ebf-hue/mini-scos/cad/13-bench-architecture/README.md

# Bench architecture study

Bench-layout study made during the architecture reset. The project subsequently returned to a wrist-mounted layout.

The existing scripts, exports and check reports are preserved in this folder. See the [CAD index](../README.md) for the ordered design history and the current version. Geometry and recorded checks do not establish physical fit or optical performance.
