ebf-hue/mini-scos/cad/05-slim-c-rest/README.md

# Slim C-rest

Intermediate slimmer wrist-rest and support study. Superseded by the SolidCraft mount sequence.

The existing scripts, exports and check reports are preserved in this folder. See the [CAD index](../README.md) for the ordered design history and the current version. Geometry and recorded checks do not establish physical fit or optical performance.
