ebf-hue/mini-scos/cad/08-solidcraft-mount-v3/README.md

# SCOS mount V3 — rounded laser cradle

The laser support now has a broad rounded barrel-shaped root, with radiused ends instead of the pointed triangular gusset. The camera retains V2's open front-loading tray and removable front keeper.

## What to reprint

Reprint **only the rest and the spine/camera tray**. Reuse V1's laser compression band, flat locking key and camera keeper. Their physical geometry is unchanged; the keeper moves to the front in the assembly.

- [One A1 mini PLA replacement plate — 55 mm wide-camera version](bambu/mount_wide_single/mount_wide_single.3mf)
- [One A1 mini PLA replacement plate — 105 mm standard-camera version](bambu/mount_standard_single/mount_standard_single.3mf)
- [Native SolidCraft model](mount.solidcraft)

The plates contain two replacement parts, with the rest on its axial end and the camera support on its planar rear face. They use a 0.4 mm nozzle, 0.2 mm layers, four walls, 30% infill and tree supports, with the complete bundled A1 mini/Generic PLA profiles. The wide-camera plate was also opened and re-sliced in Bambu Studio: approximately **2 h 50 min / 74.5 g**. Select the PLA AMS slot before printing. No print is sent automatically.

## Laser support

The cradle root is 32 mm wide, with a 22 mm diameter rounded cross-section and 2 mm end radii. It joins the arm rest across a broad footprint. The lower laser collar has a 17 mm outside diameter; the upper end retains the existing printed compression-band interface. The nominal 10 mm laser barrel uses a 10.2 mm bore.

This is a geometric reinforcement. Physical fit and strength still require a print trial; the checks below do not establish either.

## Insert the camera from the front

1. Leave the front keeper **out**. Disconnect the ribbon while loading.
2. Hold the camera **lens downward**, ribbon connector toward the rear spine, and slide it into the open front of the tray between the edge guides.
3. Seat it at the two rear stops. The guides are 25.8 mm apart for a nominal 25 mm board; the vertical guide gap remains 1.72 mm for the nominal 1.12 mm PCB.
4. Slide the original keeper crosswise into the **front** guide to prevent the board sliding back out. Do not force a tight keeper; physical printer compensation may still be needed.
5. Feed and connect the ribbon through the rear opening, using the top access window to operate the connector latch. Cable bending/hand access are not represented by the straight-envelope collision check.

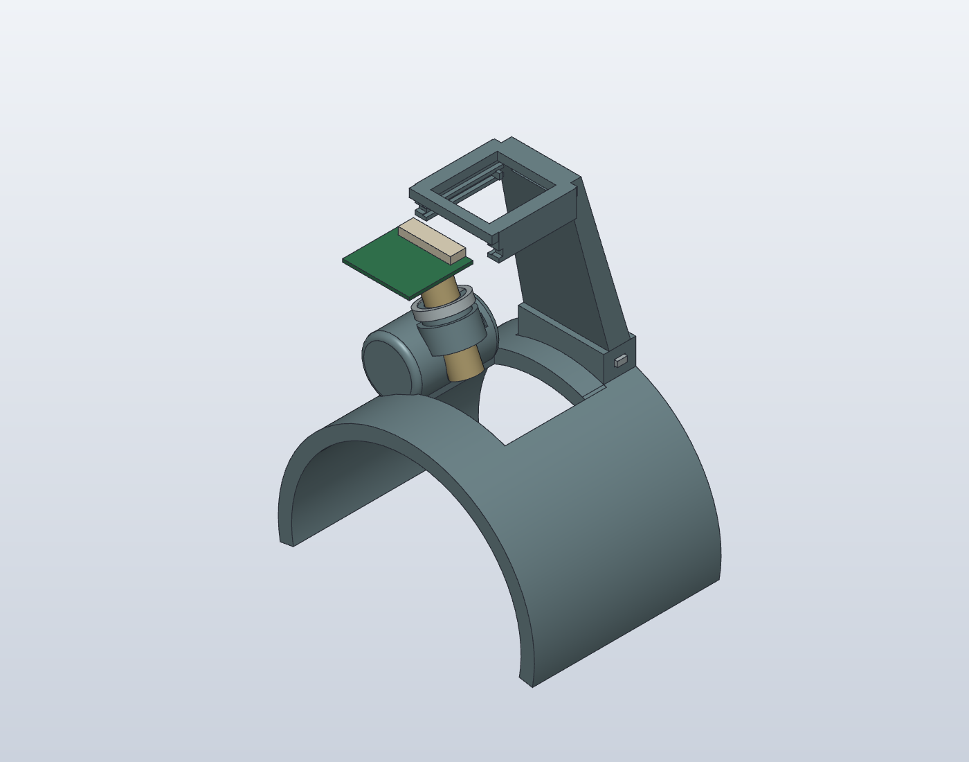
[picture p8: cad/08-solidcraft-mount-v3/camera_loading.png]
Camera outside the open front, keeper removed


## Checks

The native SolidCraft model checks the full **continuous 40 mm front insertion path** for the PCB, lens housing, lens and rear connector, with the keeper and ribbon removed. The check uses exact swept boxes for rectangular components and a conservative swept box around the circular lens. X/Y envelopes are padded by 0.2 mm per side and Z envelopes by 0.1 mm. A clear conservative envelope establishes clearance for the nominal rigid module along that path, rather than only checking sampled positions.

Both 55 and 105 mm configurations pass that insertion check. [Wide-path report](exports/assembly_path_wide.json) / [standard-path report](exports/assembly_path_standard.json). These are geometry checks, not a physical assembly trial.

The assembled model also checks the camera, cable, laser and R41 arm gauge. The only intended intersections are the flat key's two friction contacts and the collar/compression-band press fit. [Static collision report](exports/collision_checks.json). Camera/connector reference envelopes are simplified; they do not include every small electronic component or cable-handling detail.

Closed-mesh and bed-placement checks are in [mesh_validation.json](exports/mesh_validation.json). Bambu projects are sliced before delivery; native model sources and STEP exports are retained beside the print files. The standard variant retains V1's height difference; this revision does not change camera optics or establish SCOS performance.

## Rebuild

```sh
python3 build.py
python3 check_meshes.py
python3 slice_bambu.py
```

SolidCraft and Bambu Studio are required at their installed macOS locations; `SOLIDCRAFT_CLI` can override SolidCraft's path. Rebuilding uses a separate headless SolidCraft MCP document. The native feature history remains in `mount.solidcraft` and its plain JSON counterpart; `build_commands.json` is the replayable native command script. Re-slicing keeps both replacement parts on one A1 mini build plate.
