ebf-hue/mini-scos/cad/10-solidcraft-mount-v5/README.md

# SolidCraft mount V5

Intermediate attachment-junction and blending study between V4 and V6. Not the current mount.

The existing scripts, exports and check reports are preserved in this folder. See the [CAD index](../README.md) for the ordered design history and the current version. Geometry and recorded checks do not establish physical fit or optical performance.
