ebf-hue/mini-scos/cad/11-solidcraft-mount-v6/README.md

# SCOS mount V6 — surface-blended laser attachment

The attachment is a surface blend between trimmed boundaries on the arm rest and laser collar. The replacement surface follows the parent surfaces at both ends, rather than intersecting them with a two-profile solid loft. See [close-up](blend_detail_front.png).

## What to reprint

Reprint **only the rest and the spine/camera tray**. Reuse V1's laser compression band, flat locking key and camera keeper. Their physical geometry is unchanged; the keeper moves to the front in the assembly.

- [One A1 mini PLA replacement plate — 55 mm wide-camera version](bambu/mount_wide_single/mount_wide_single.3mf)
- [One A1 mini PLA replacement plate — 105 mm standard-camera version](bambu/mount_standard_single/mount_standard_single.3mf)
- [Native SolidCraft model](mount.solidcraft)

The plates contain two replacement parts, with the rest on its axial end and the camera support on its planar rear face. They use a 0.4 mm nozzle, 0.2 mm layers, four walls, 30% infill and tree supports, with the complete bundled A1 mini/Generic PLA profiles. The wide-camera plate was opened and re-sliced in Bambu Studio: approximately **2 h 38 min / 68.8 g**. Select the PLA AMS slot before printing. No print is sent automatically.

## Laser support

A 16 × 24 mm projected oval on the rest blends into a 4 × 7 mm projected oval on the back of the collar. SolidCraft's `surface.blend` requests G2 at each end; the open surfaces are sewn in Open CASCADE at 0.01 mm and imported as a closed solid for the bore, compliance slit and key slots. The native authoring document remains in [surface_source/blend_joined.solidcraft](surface_source/blend_joined.solidcraft); the final assembly has the sewn rest as a STEP import.

Independent checks on the finished STEP measured the blend seams at **under 0.45° tangent-plane mismatch** and **under 0.00022 mm projection gap**. [Report](surface_source/blend_seam_validation.json). This establishes finite-tolerance tangent agreement; exact mathematical G2 continuity is not claimed.

The rest STL is tessellated from the valid STEP solid using Open CASCADE. The mesh check preserves tiny triangles with 0.000001 mm coordinate rounding; every mesh edge has two incident triangles and no triangle has zero area. No hole filling or mesh patching is used.

The existing compression-band interface and 10.2 mm laser bore are retained. Physical fit and strength still require a print trial.

## Insert the camera from the front

1. Leave the front keeper **out**. Disconnect the ribbon while loading.
2. Hold the camera **lens downward**, ribbon connector toward the rear spine, and slide it into the open front of the tray between the edge guides.
3. Seat it at the two rear stops. The guides are 25.8 mm apart for a nominal 25 mm board; the vertical guide gap remains 1.72 mm for the nominal 1.12 mm PCB.
4. Slide the original keeper crosswise into the **front** guide to prevent the board sliding back out. Do not force a tight keeper; physical printer compensation may still be needed.
5. Feed and connect the ribbon through the rear opening, using the top access window to operate the connector latch. Cable bending/hand access are not represented by the straight-envelope collision check.

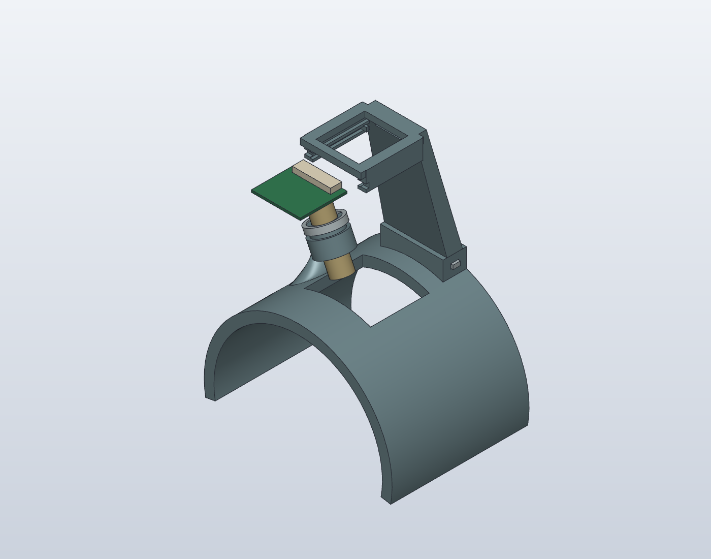
[picture p10: cad/11-solidcraft-mount-v6/camera_loading.png]
Camera outside the open front, keeper removed


## Checks

The native SolidCraft model checks the full **continuous 40 mm front insertion path** for the PCB, lens housing, lens and rear connector, with the keeper and ribbon removed. The check uses exact swept boxes for rectangular components and a conservative swept box around the circular lens. X/Y envelopes are padded by 0.2 mm per side and Z envelopes by 0.1 mm. A clear conservative envelope establishes clearance for the nominal rigid module along that path, rather than only checking sampled positions.

Both 55 and 105 mm configurations pass that insertion check. [Wide-path report](exports/assembly_path_wide.json) / [standard-path report](exports/assembly_path_standard.json). These are geometry checks, not a physical assembly trial.

The assembled model also checks the camera, cable, laser and R41 arm gauge. The only intended intersections are the flat key's two friction contacts and the collar/compression-band press fit. [Static collision report](exports/collision_checks.json). SolidCraft could not intersect the reused band with the imported curved rest; that intended press-fit pair was checked independently in Open CASCADE (15.18 mm³), with a source hash recorded. All remaining pairs and the complete camera insertion sweeps were checked in SolidCraft. Camera/connector reference envelopes are simplified; they do not include every small electronic component or cable-handling detail.

Closed-mesh and bed-placement checks are in [mesh_validation.json](exports/mesh_validation.json). Bambu projects are sliced before delivery; native model sources and STEP exports are retained beside the print files. The standard variant retains V1's height difference; this revision does not change camera optics or establish SCOS performance.

## Rebuild

```sh
# Reuse the checked surface source and rebuild camera variants/assembly:
python3 build.py
python3 check_meshes.py
python3 slice_bambu.py
```

SolidCraft and Bambu Studio are required at their installed macOS locations; `SOLIDCRAFT_CLI` can override SolidCraft's path. Rebuilding uses a separate headless SolidCraft MCP document. The native feature history remains in `mount.solidcraft` and its plain JSON counterpart; `build_commands.json` is the replayable native command script. Re-slicing keeps both replacement parts on one A1 mini build plate.

To rebuild the surface geometry itself, run `python3 build_surface.py` before the assembly build. This also uses uv/CadQuery for sewing and validation. The rest surface source and sewing are retained separately from the final imported assembly.
