ebf-hue/mini-scos/cad/12-solidcraft-mount-v7/README.md

# SolidCraft mount V7

Camera attachment surface blends and a wider laser attachment, retaining the front-loading camera layout. Superseded by the later architecture studies.

The existing scripts, exports and check reports are preserved in this folder. See the [CAD index](../README.md) for the ordered design history and the current version. Geometry and recorded checks do not establish physical fit or optical performance.
