ebf-hue/mini-scos/docs/TEAM.md

# Team #

## Members ##
- Elena Berrios eberrios@bu.edu
- Sean O’Connor ssoc@bu.edu

## Decisions ##
Decisions will be collaborative. In the rare case that an agreement can't be made, the designated sprint lead will call it.

## Roles ##
Designated sprint lead will alternate. The lead for sprint 1 is Elena. All decisions, including those that are technical or related to project management, are collaboratively discussed between members as stated above.

## Communication ##
The team will meet biweekly during EC601 class time. Additional in-person or remote meetings are flexible and will be scheduled as needed. Communication outside of meetings will primarily be over text. Replies can be expected within 24 hours, unless a member communicates that they'll be unavailable. Members will also communicate if they're unable to attend a scheduled meeting.
