ebf-hue/mini-scos/cad/01-bench-fixture/preview.png

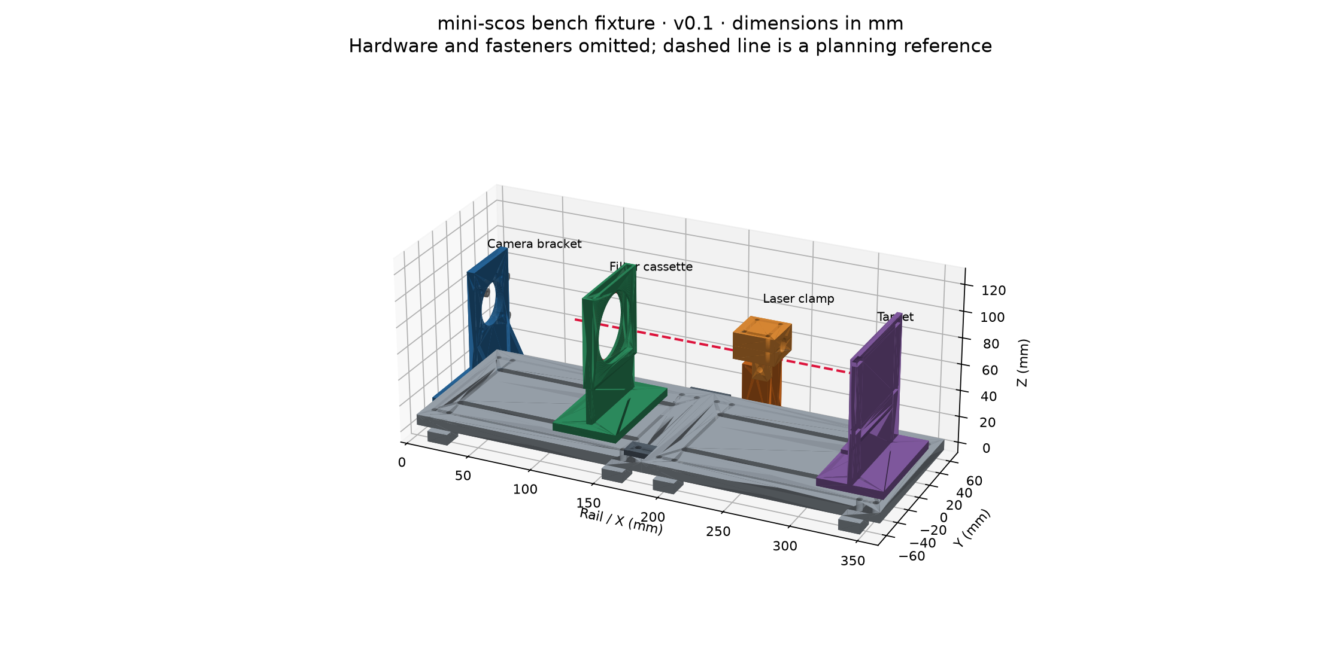
cad/01-bench-fixture/preview.png
