ebf-hue/mini-scos/cad/02-arm-cuff-concept/arm_cuff_graphic.png

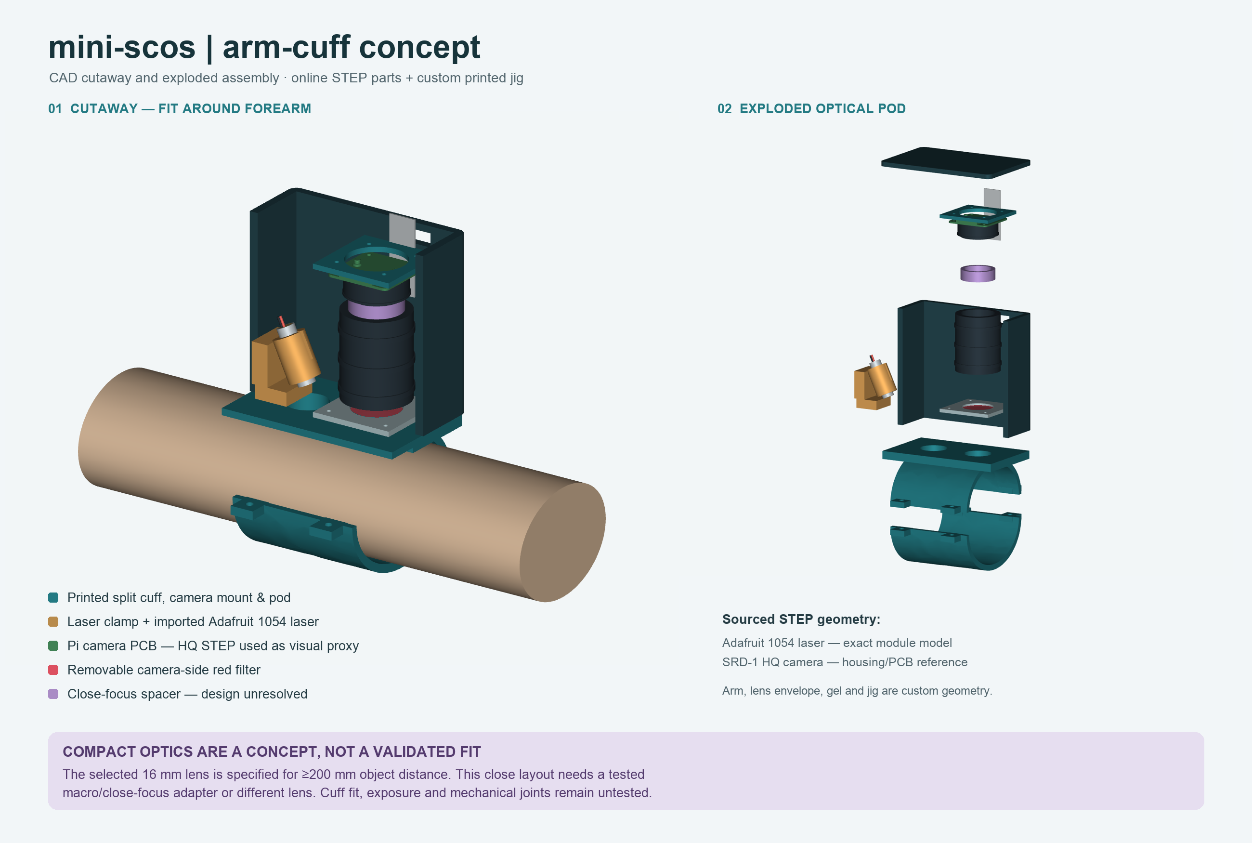
cad/02-arm-cuff-concept/arm_cuff_graphic.png
