ebf-hue/mini-scos/cad/02-arm-cuff-concept/arm_cuff_graphic_v02.png

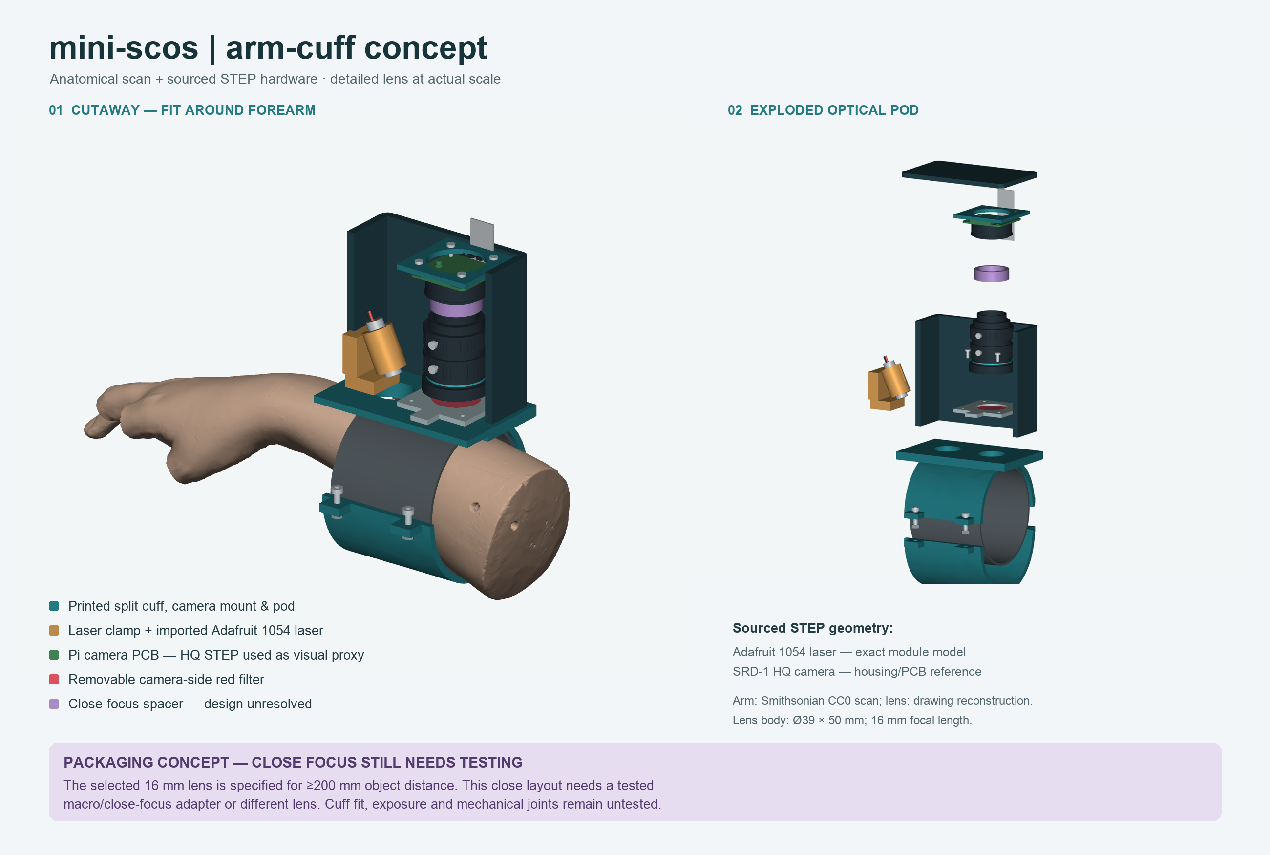
cad/02-arm-cuff-concept/arm_cuff_graphic_v02.png
