ebf-hue/mini-scos/cad/02-arm-cuff-concept/cutaway.png

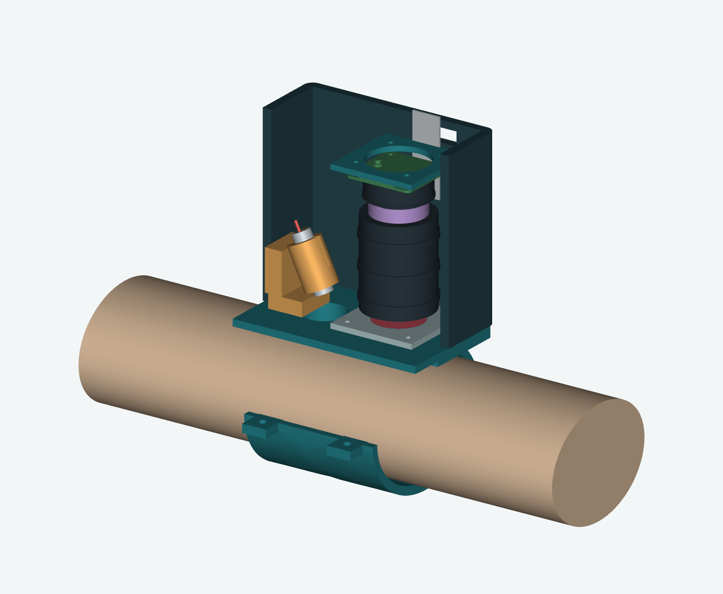
cad/02-arm-cuff-concept/cutaway.png
