ebf-hue/mini-scos/cad/02-arm-cuff-concept/cutaway_v02.png

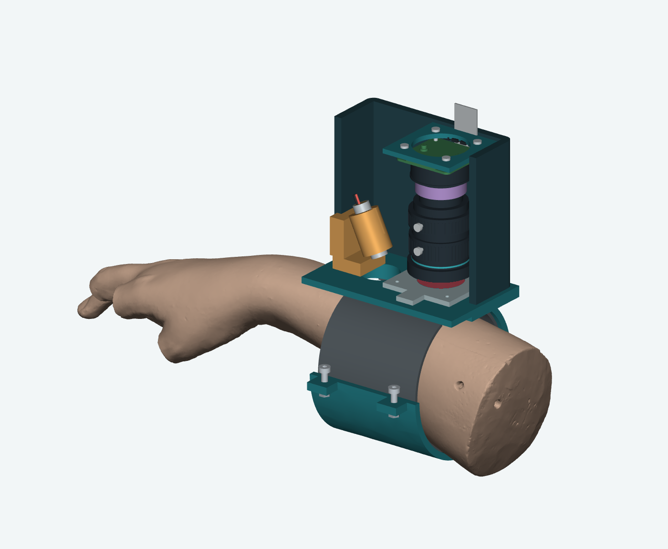
cad/02-arm-cuff-concept/cutaway_v02.png
