ebf-hue/mini-scos/cad/02-arm-cuff-concept/exploded.png

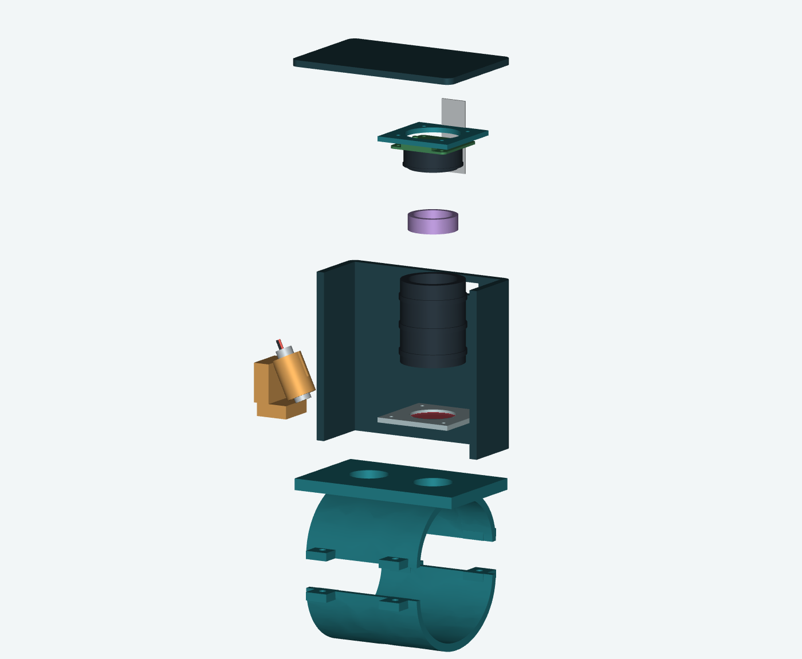
cad/02-arm-cuff-concept/exploded.png
