ebf-hue/mini-scos/cad/02-arm-cuff-concept/open_arm_saddle_graphic.png

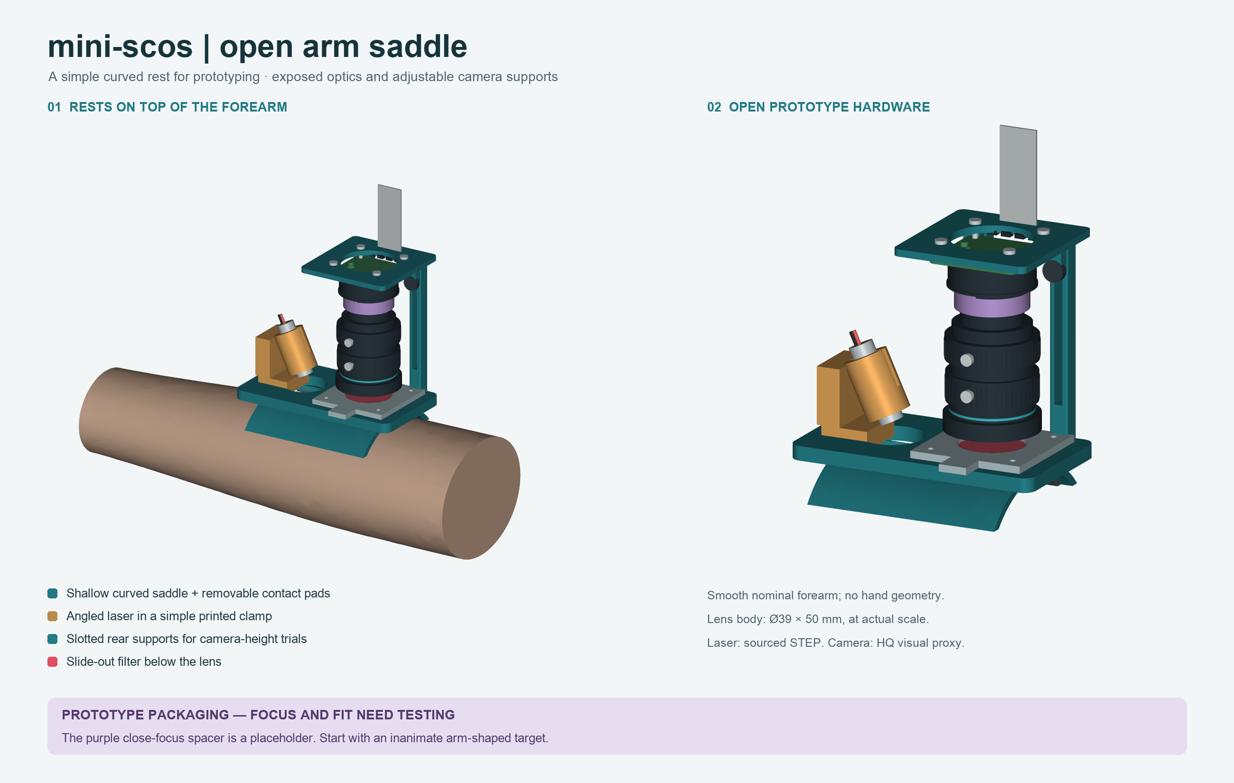
cad/02-arm-cuff-concept/open_arm_saddle_graphic.png
