ebf-hue/mini-scos/cad/02-arm-cuff-concept/open_saddle_detail.png

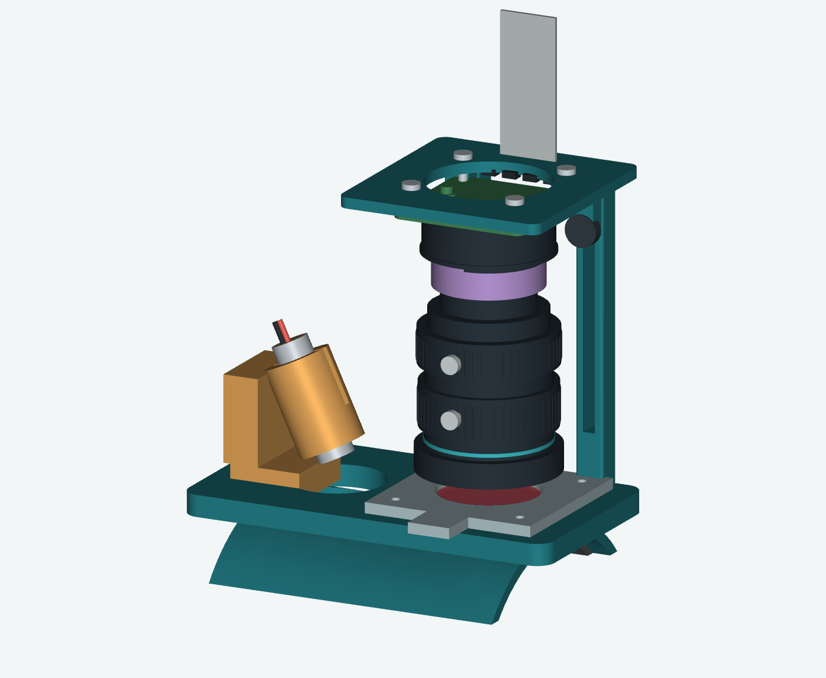
cad/02-arm-cuff-concept/open_saddle_detail.png
