ebf-hue/mini-scos/cad/02-arm-cuff-concept/sources/forearm_scan/life-cast-of-left-forearm-and-hand-150k-4096-occlusion.jpg

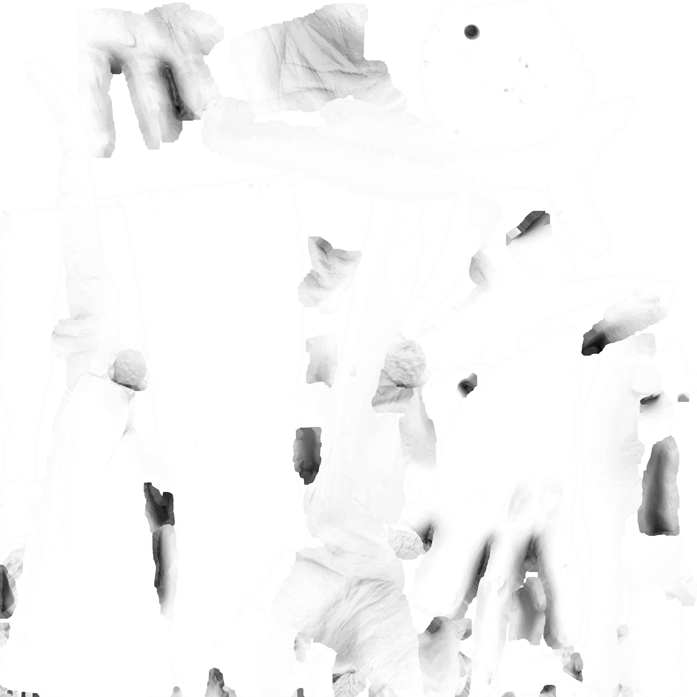
cad/02-arm-cuff-concept/sources/forearm_scan/life-cast-of-left-forearm-and-hand-150k-4096-occlusion.jpg
