ebf-hue/mini-scos/cad/03-c-rest-module3/exploded.png

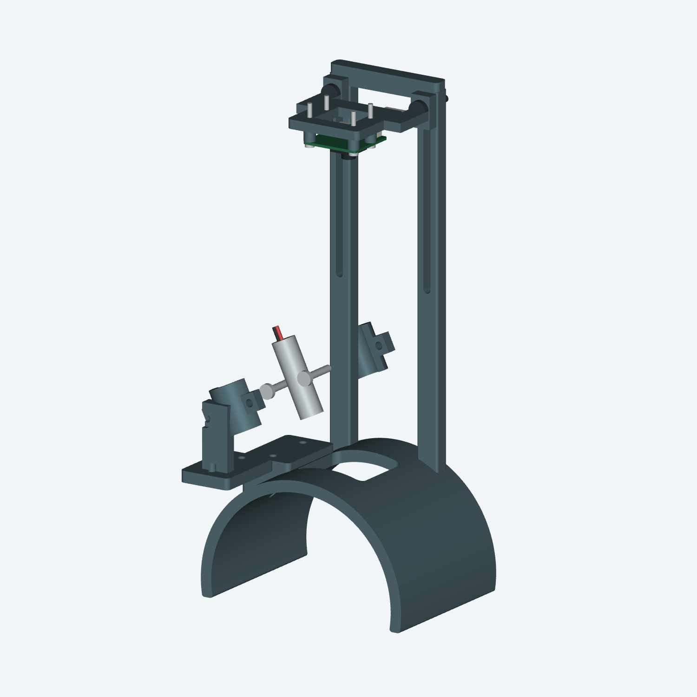
cad/03-c-rest-module3/exploded.png
