ebf-hue/mini-scos/cad/03-c-rest-module3/front.png

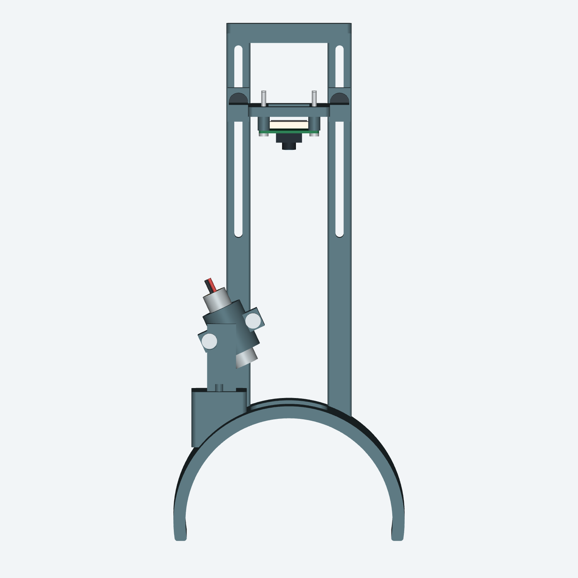
cad/03-c-rest-module3/front.png
