ebf-hue/mini-scos/cad/03-c-rest-module3/on_arm.png

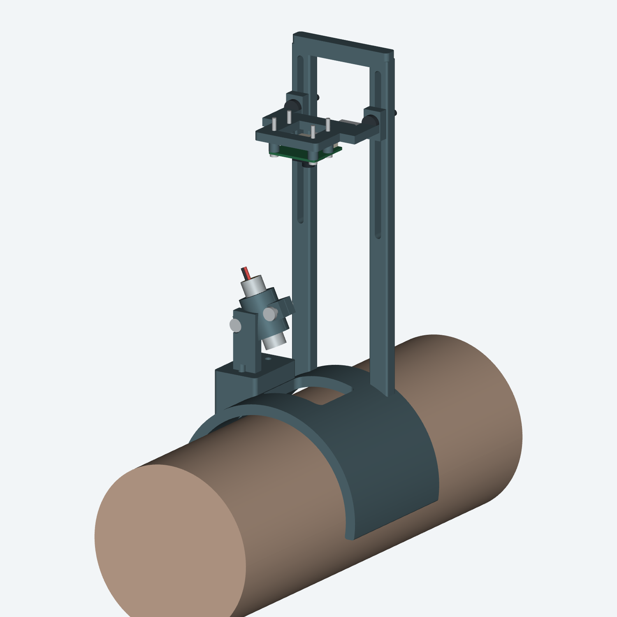
cad/03-c-rest-module3/on_arm.png
