ebf-hue/mini-scos/cad/11-solidcraft-mount-v6/blend_detail_back.png

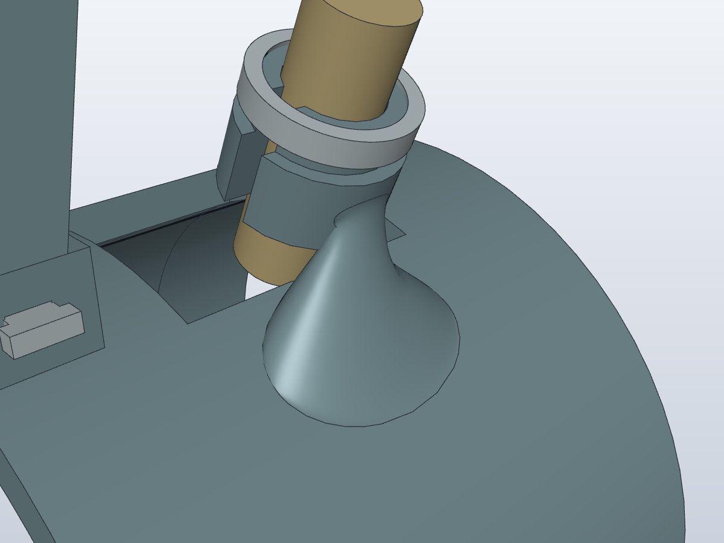
cad/11-solidcraft-mount-v6/blend_detail_back.png
