ebf-hue/mini-scos/cad/11-solidcraft-mount-v6/blend_detail_front.png

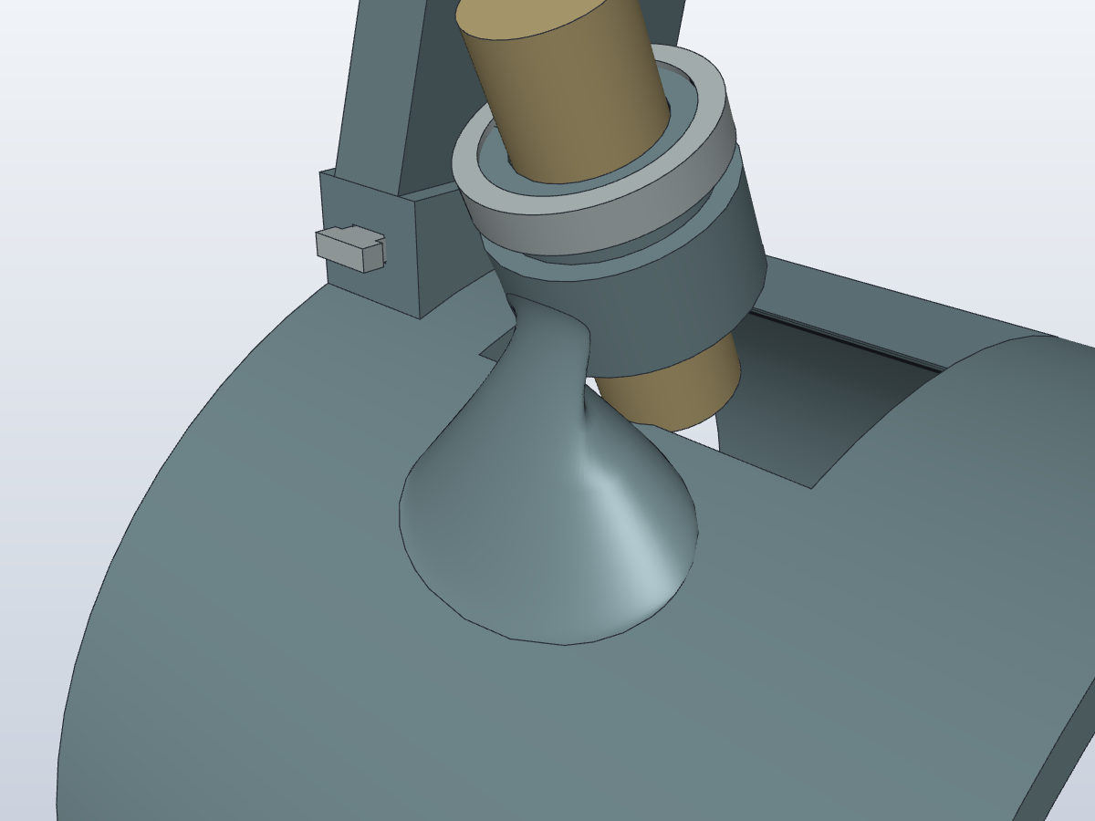
cad/11-solidcraft-mount-v6/blend_detail_front.png
