ebf-hue/mini-scos/cad/12-solidcraft-mount-v7/camera_source/wide/camera_blended.png

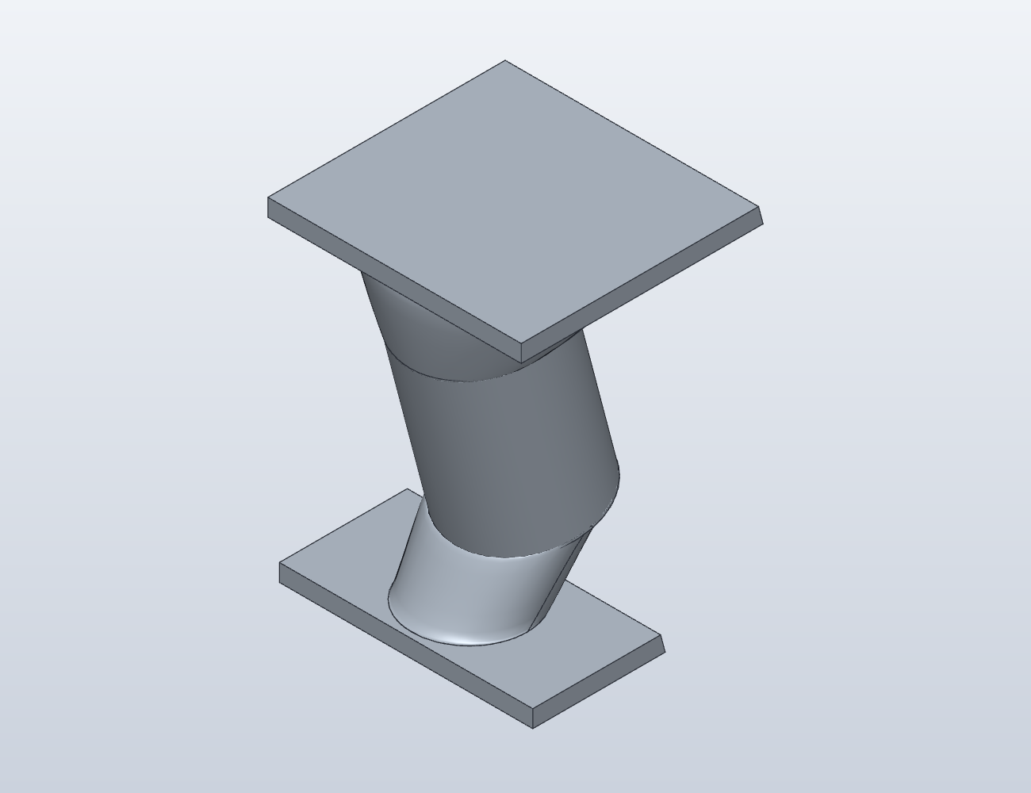
cad/12-solidcraft-mount-v7/camera_source/wide/camera_blended.png
