ebf-hue/mini-scos/cad/13-bench-architecture/bench-concept.png

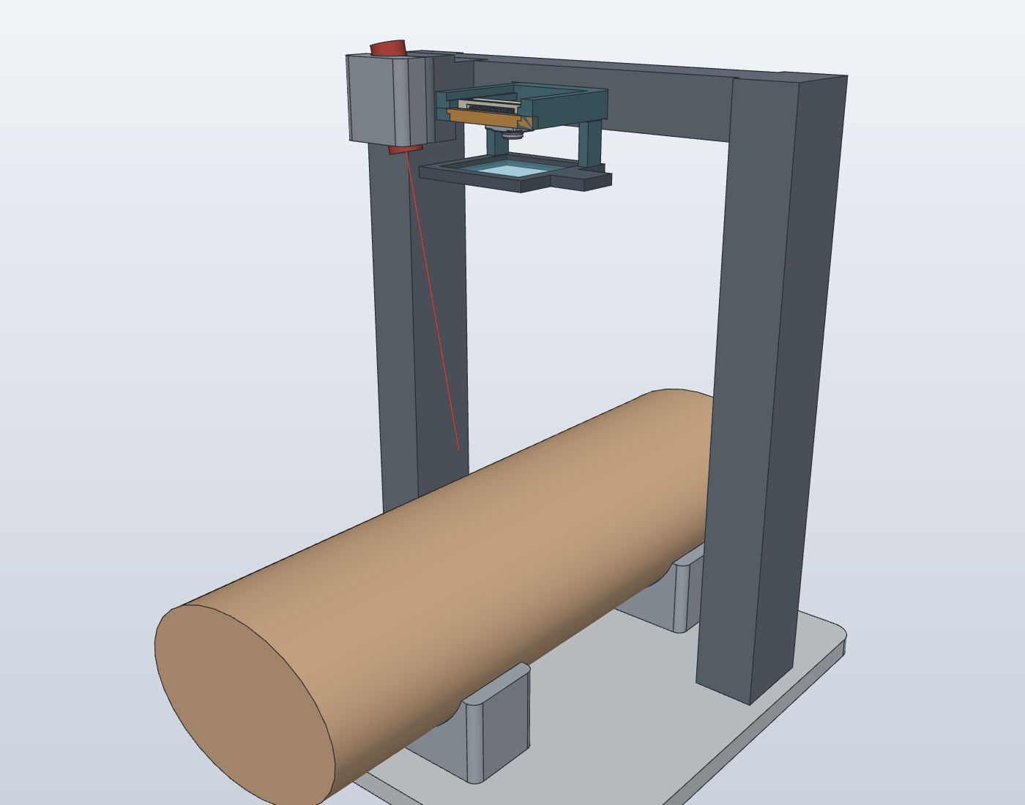
cad/13-bench-architecture/bench-concept.png
