ebf-hue/mini-scos/cad/13-bench-architecture/camera-detail.png

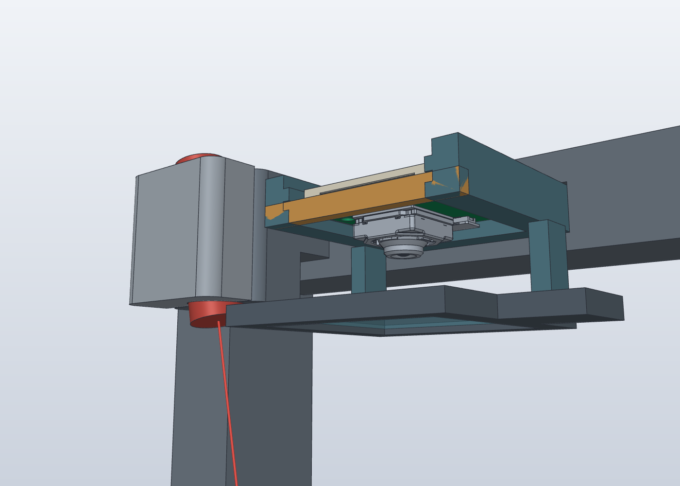
cad/13-bench-architecture/camera-detail.png
