ebf-hue/mini-scos/cad/14-wrist-architecture/insertion/camera-insertion.png

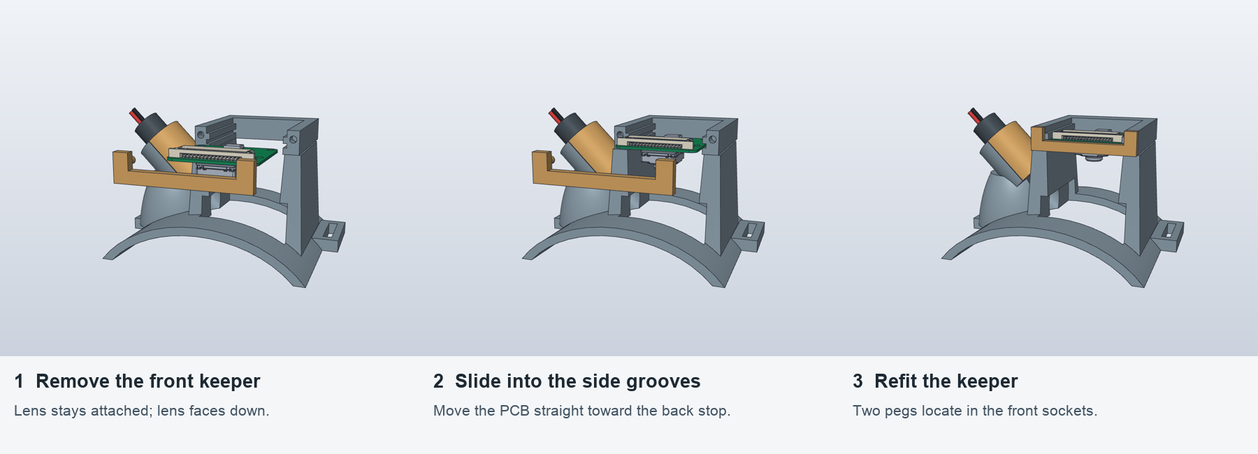
cad/14-wrist-architecture/insertion/camera-insertion.png
