ebf-hue/mini-scos/cad/14-wrist-architecture/wrist-closeup.png

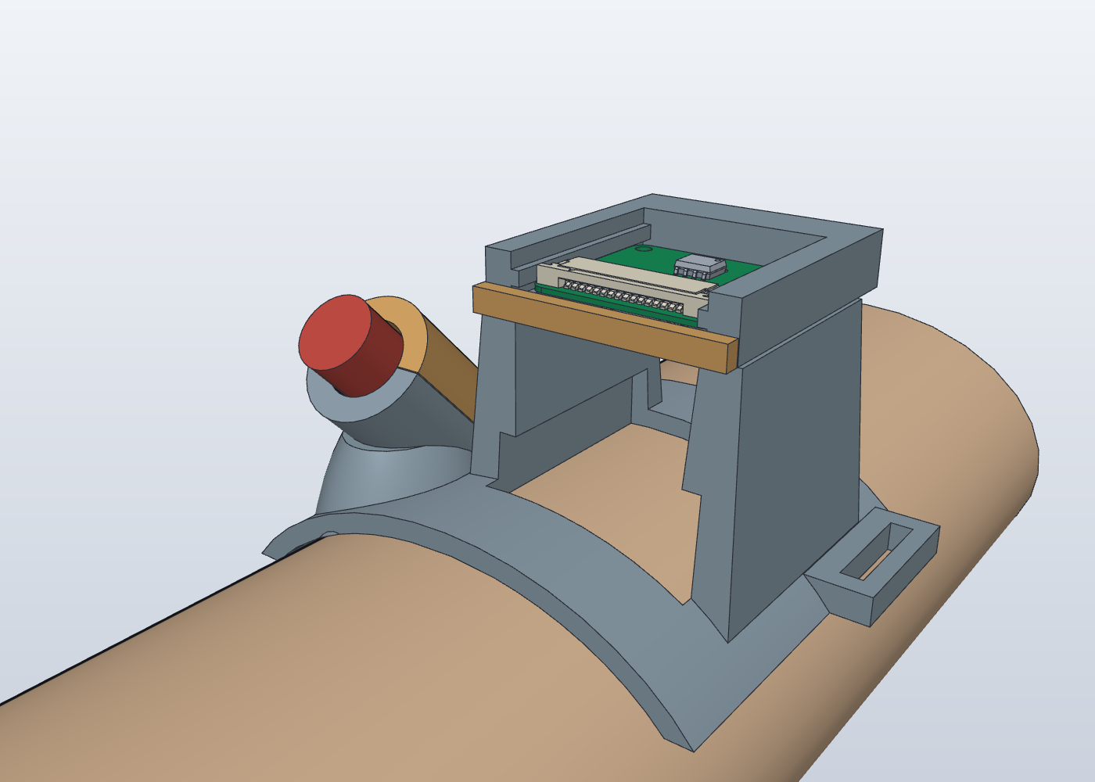
cad/14-wrist-architecture/wrist-closeup.png
