ebf-hue/mini-scos/cad/14-wrist-architecture/wrist-concept.png

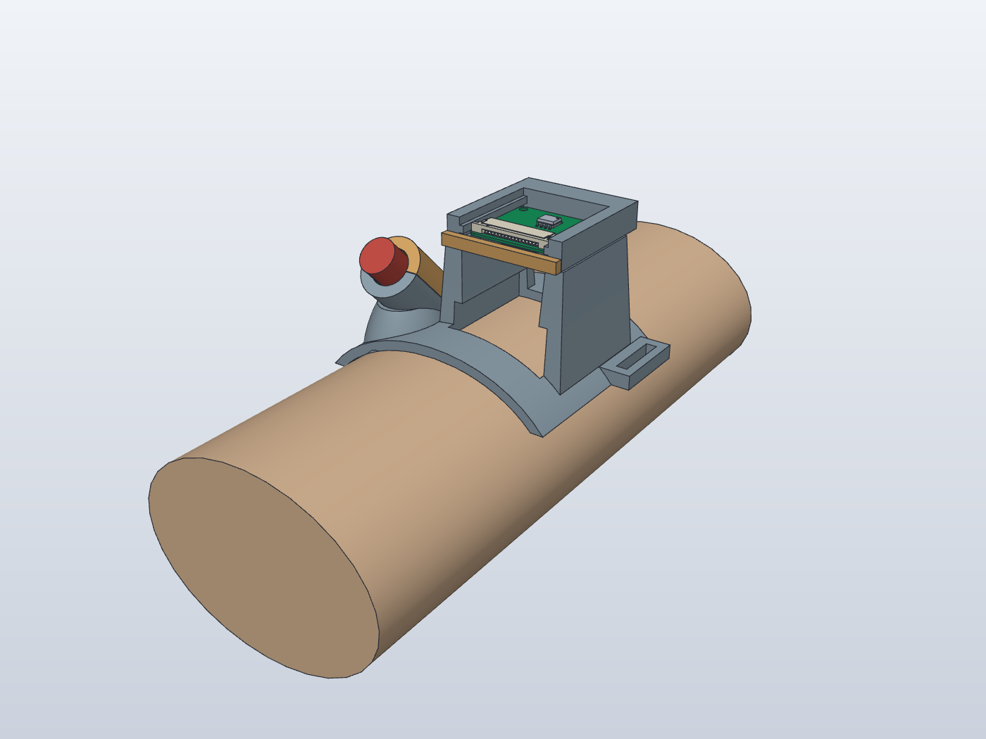
cad/14-wrist-architecture/wrist-concept.png
