ebf-hue/mini-scos/cad/14-wrist-architecture/wrist-inward-ray.png

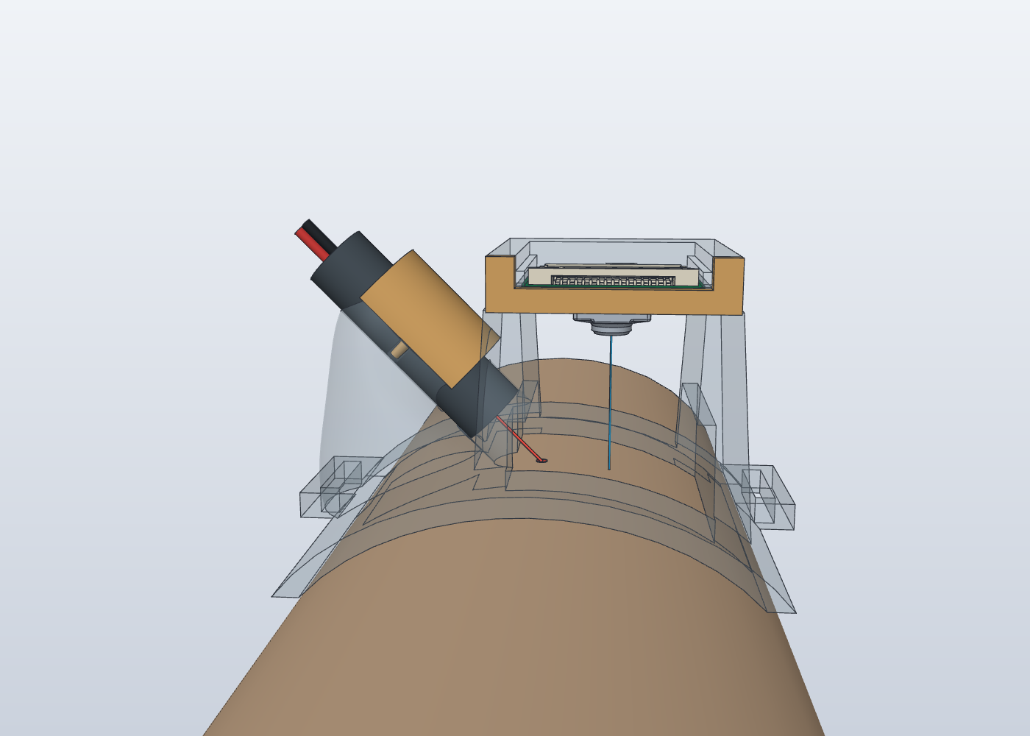
cad/14-wrist-architecture/wrist-inward-ray.png
