ebf-hue/mini-scos/cad/15-tower-mechanical/front.png

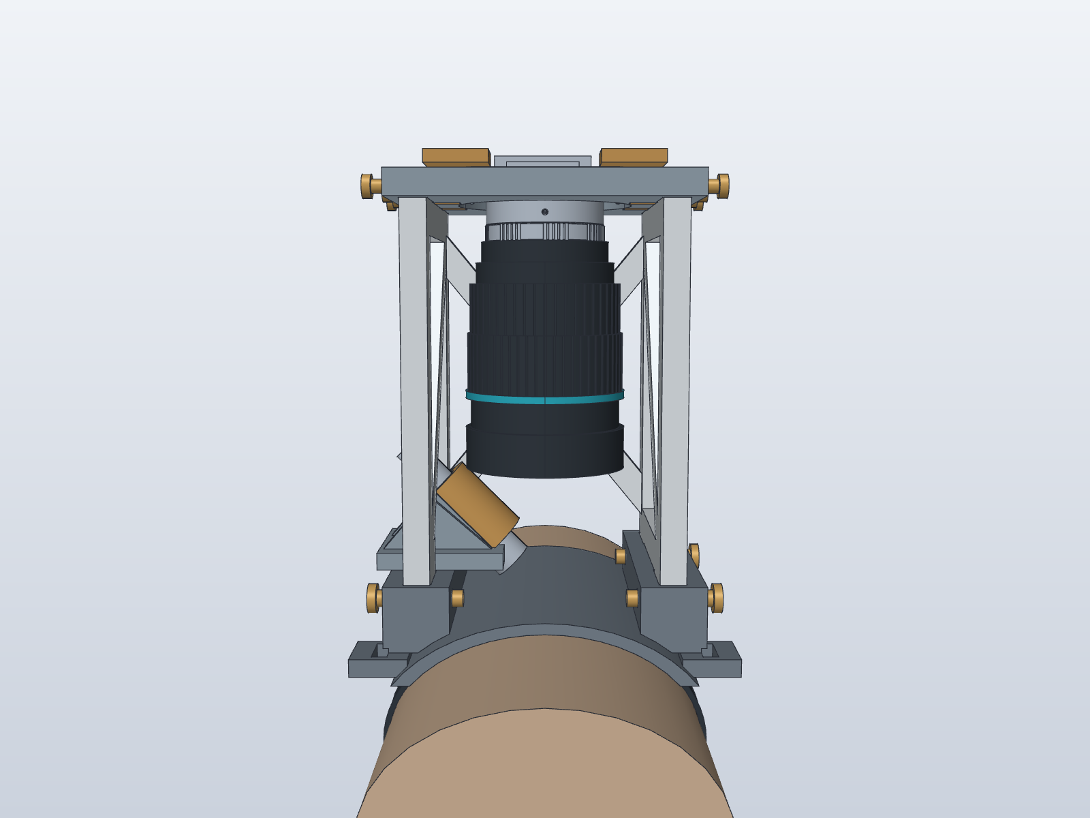
cad/15-tower-mechanical/front.png
