ebf-hue/mini-scos/cad/15-tower-mechanical/side.png

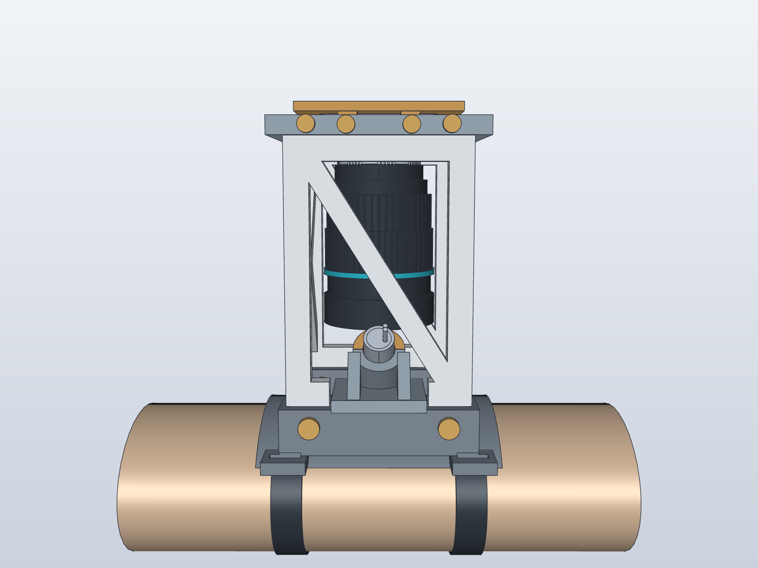
cad/15-tower-mechanical/side.png
