ebf-hue/mini-scos/cad/16-tower-dovetail/bambu/sliced-plate.jpg

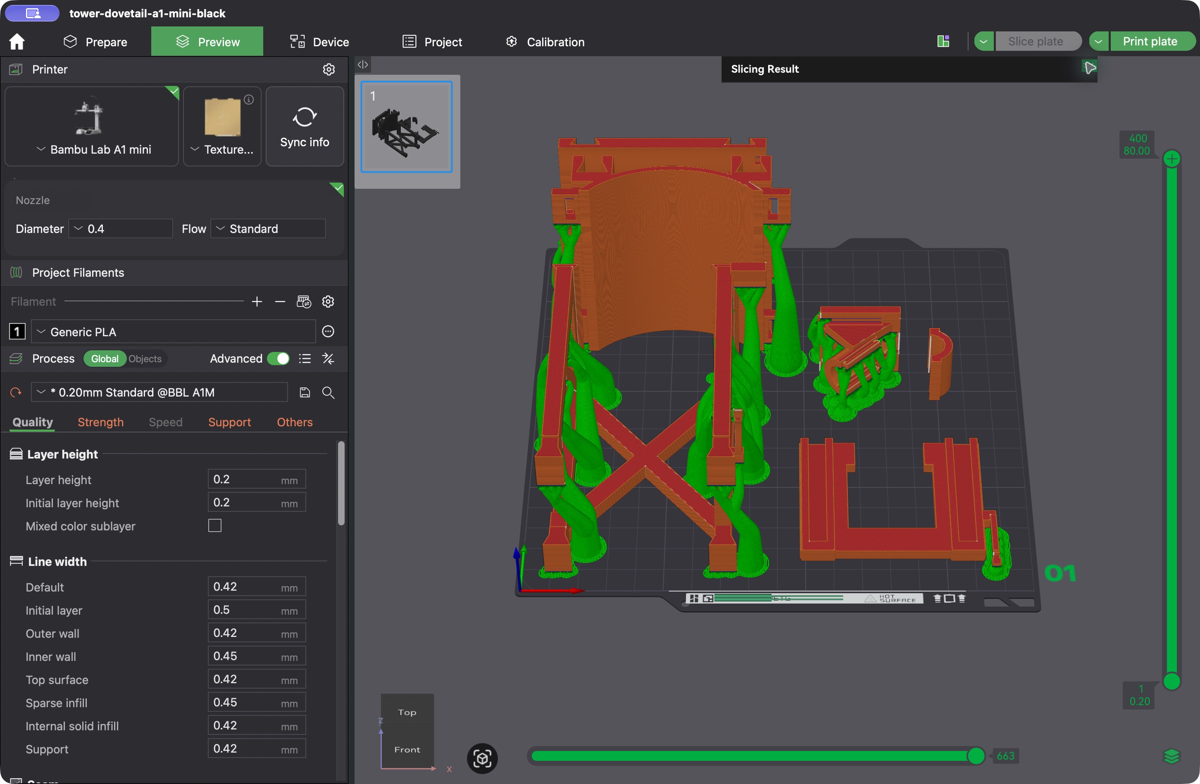
cad/16-tower-dovetail/bambu/sliced-plate.jpg
