ebf-hue/mini-scos/cad/16-tower-dovetail/screenshots/04-camera-retainer.png

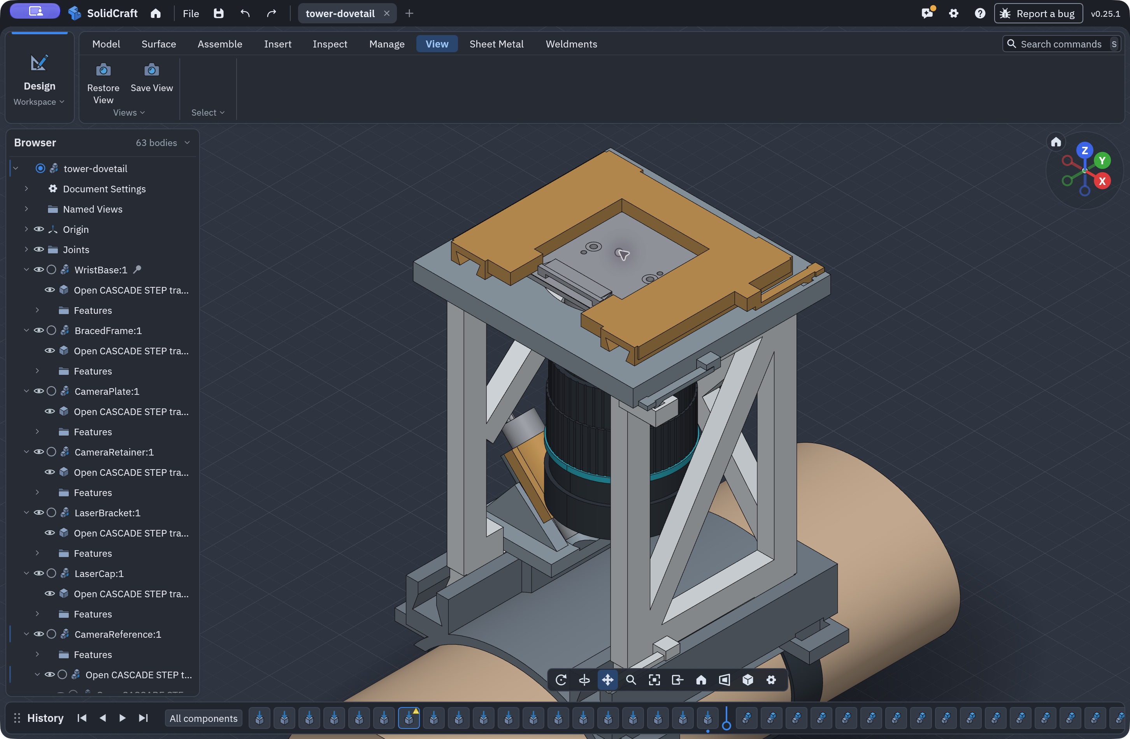
cad/16-tower-dovetail/screenshots/04-camera-retainer.png
