ebf-hue/mini-scos/cad/17-tower-open-optics/camera-clip-bottom.png

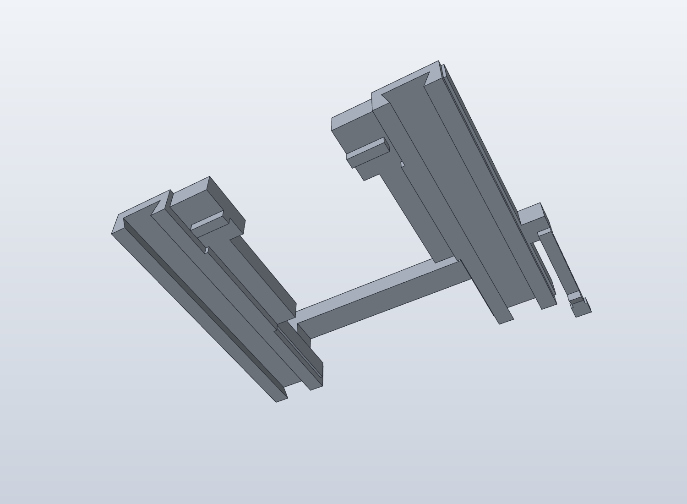
cad/17-tower-open-optics/camera-clip-bottom.png
