ebf-hue/mini-scos/cad/17-tower-open-optics/camera-retention-section.png

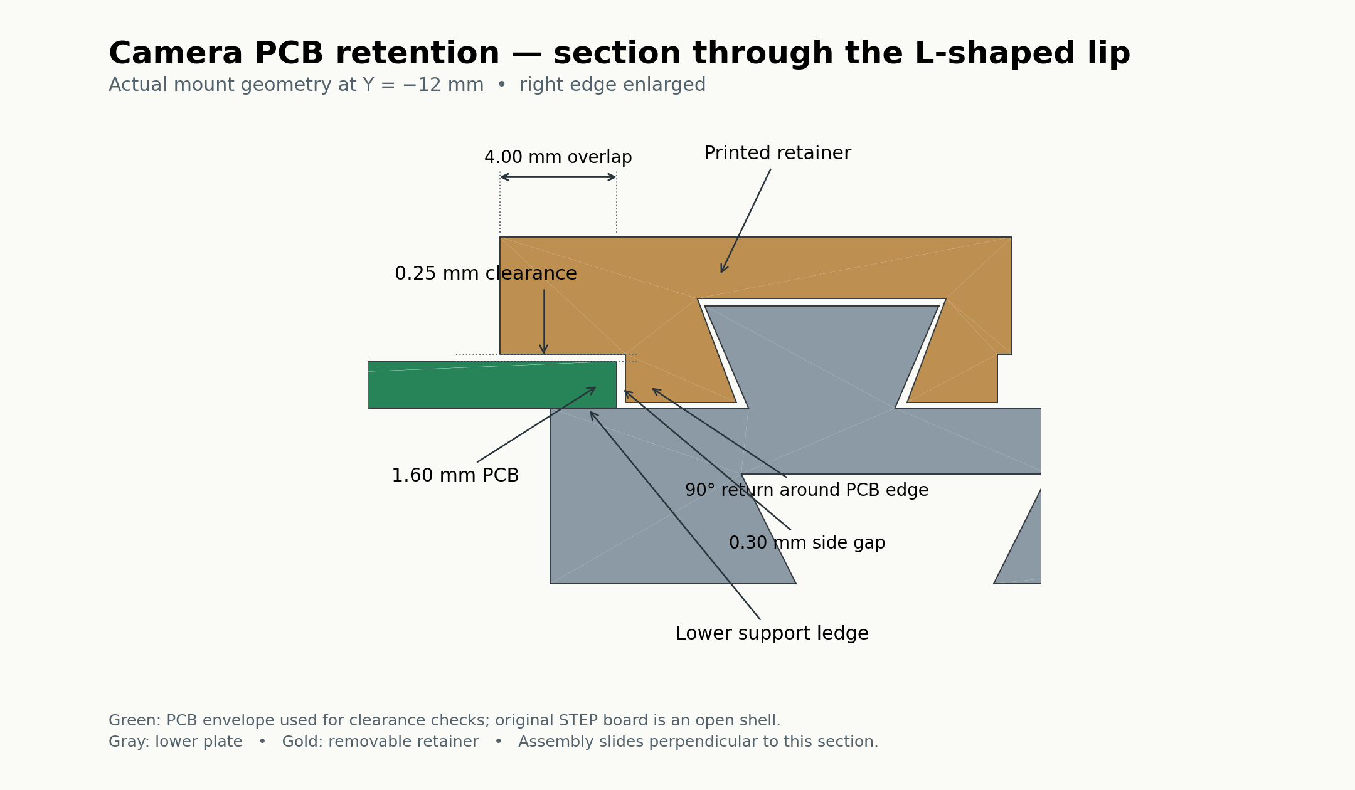
cad/17-tower-open-optics/camera-retention-section.png
