ebf-hue/mini-scos/cad/17-tower-open-optics/header-clearance-detail.png

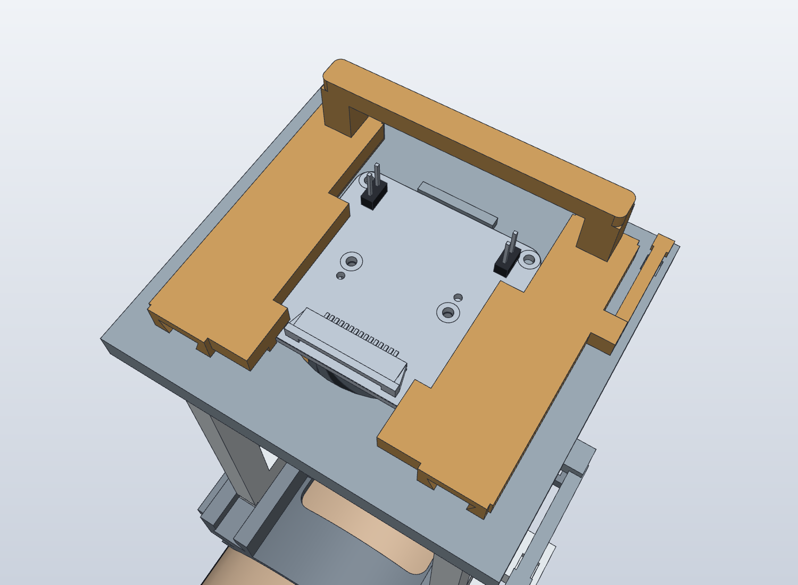
cad/17-tower-open-optics/header-clearance-detail.png
