ebf-hue/mini-scos/cad/17-tower-open-optics/open-base.png

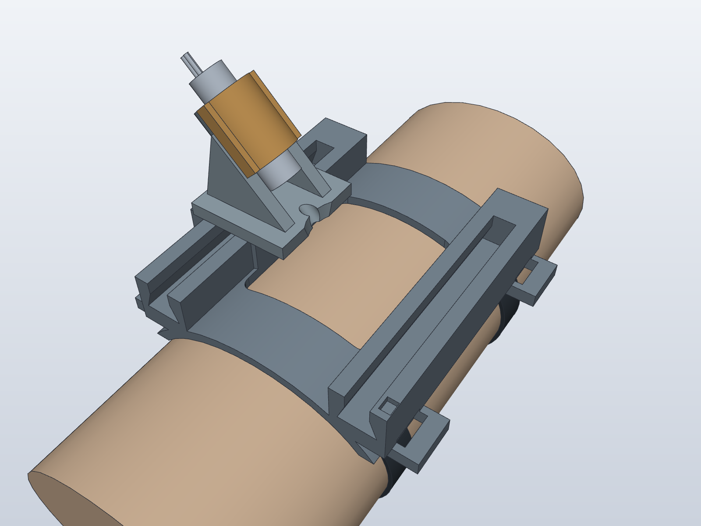
cad/17-tower-open-optics/open-base.png
