ebf-hue/mini-scos/cad/17-tower-open-optics/optical-paths-side.png

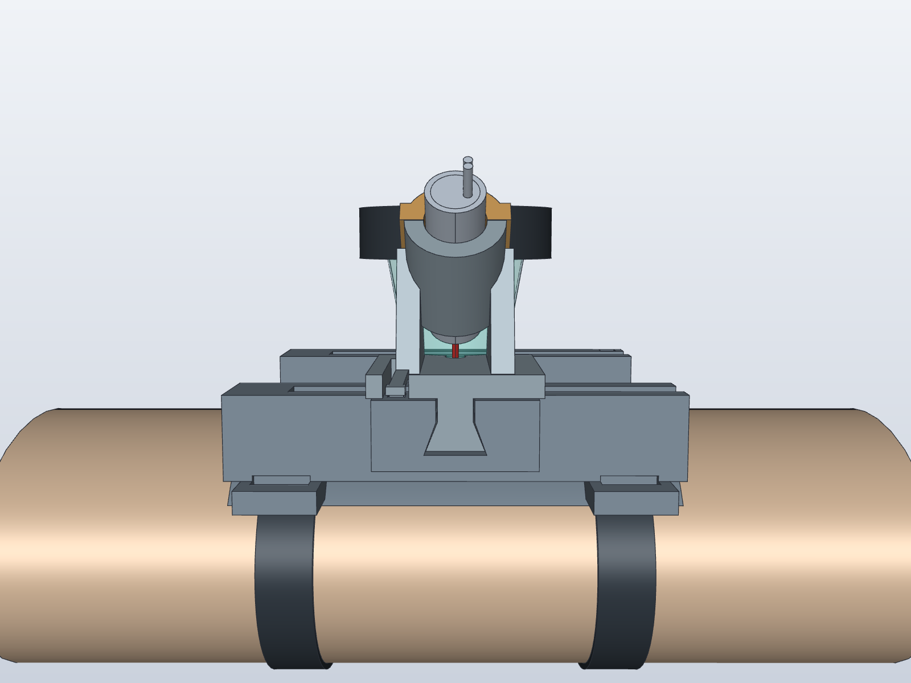
cad/17-tower-open-optics/optical-paths-side.png
