ebf-hue/mini-scos/cad/17-tower-open-optics/optical-paths.png

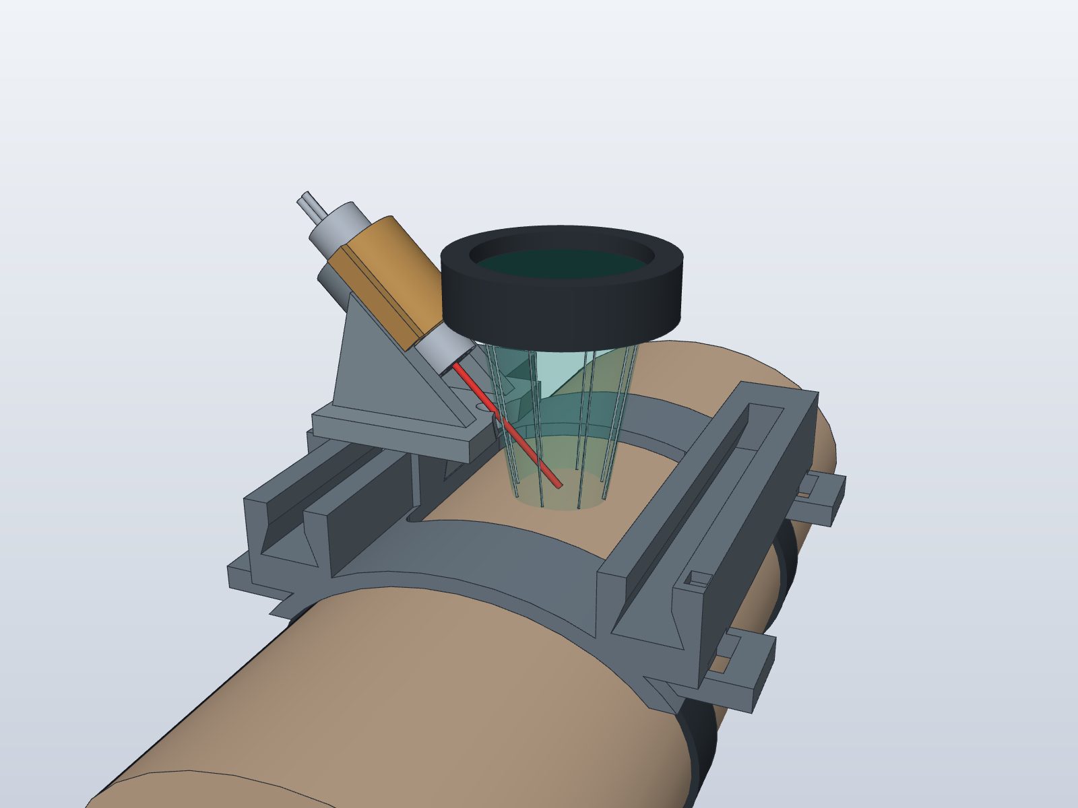
cad/17-tower-open-optics/optical-paths.png
