ebf-hue/mini-scos/cad/17-tower-open-optics/pcb-end-stops-section.png

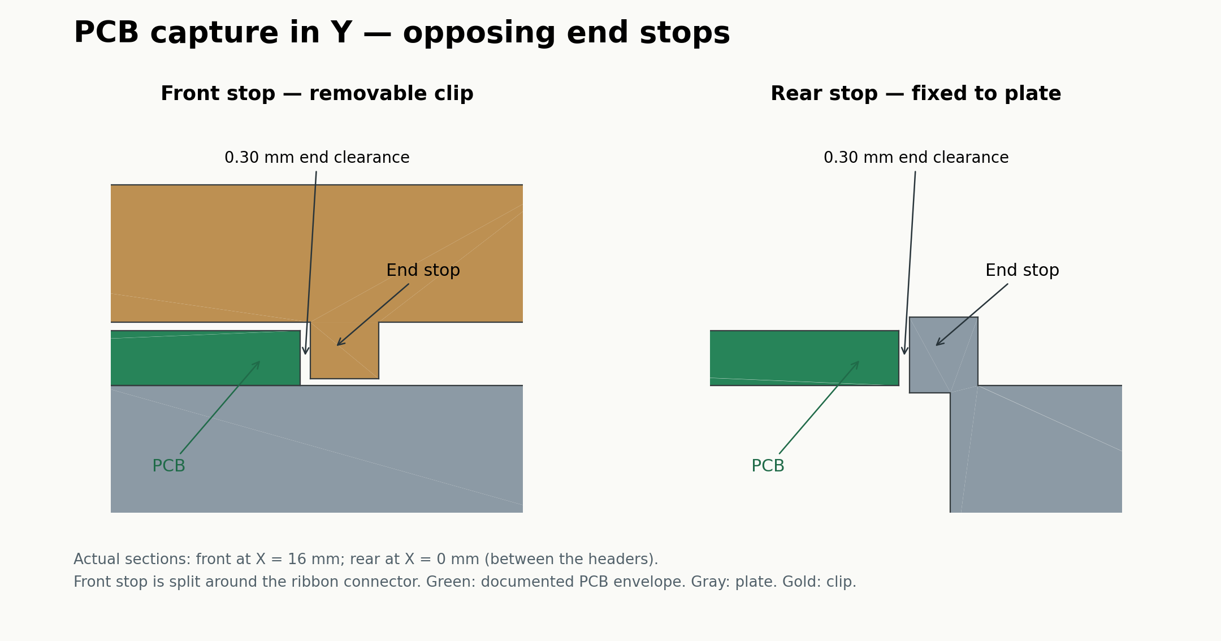
cad/17-tower-open-optics/pcb-end-stops-section.png
