ebf-hue/mini-scos/cad/18-tower-recessed-clips/camera-drop-in.png

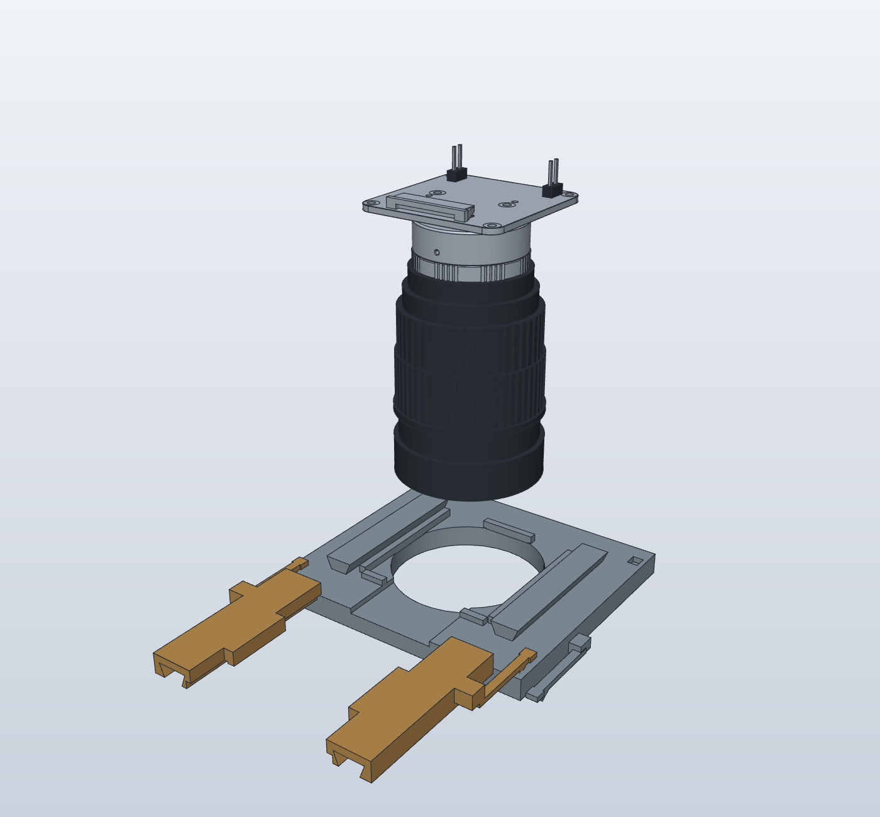
cad/18-tower-recessed-clips/camera-drop-in.png
