ebf-hue/mini-scos/cad/18-tower-recessed-clips/camera-seat-empty.png

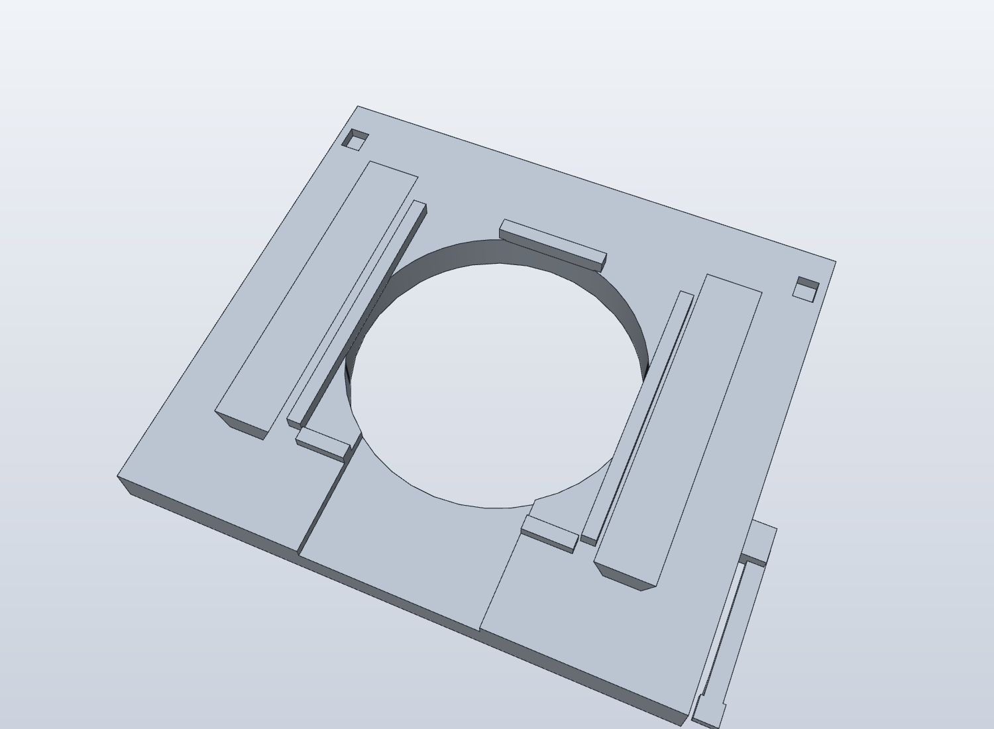
cad/18-tower-recessed-clips/camera-seat-empty.png
