ebf-hue/mini-scos/cad/19-camera-tray/camera-seat-empty.png

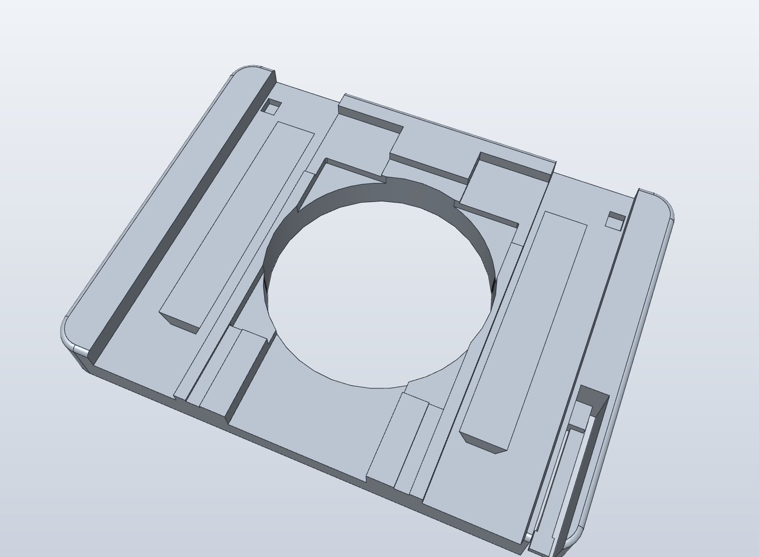
cad/19-camera-tray/camera-seat-empty.png
