ebf-hue/mini-scos/cad/experiments/halloween-sculpt/concept-reference.png

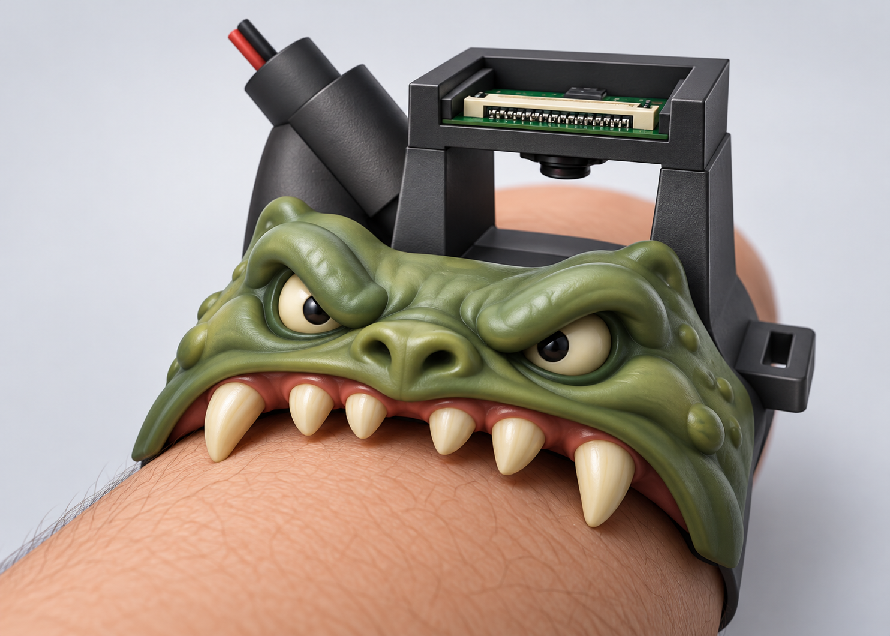
cad/experiments/halloween-sculpt/concept-reference.png
