ebf-hue/mini-scos/cad/tower-dovetail/dovetail-detail.png

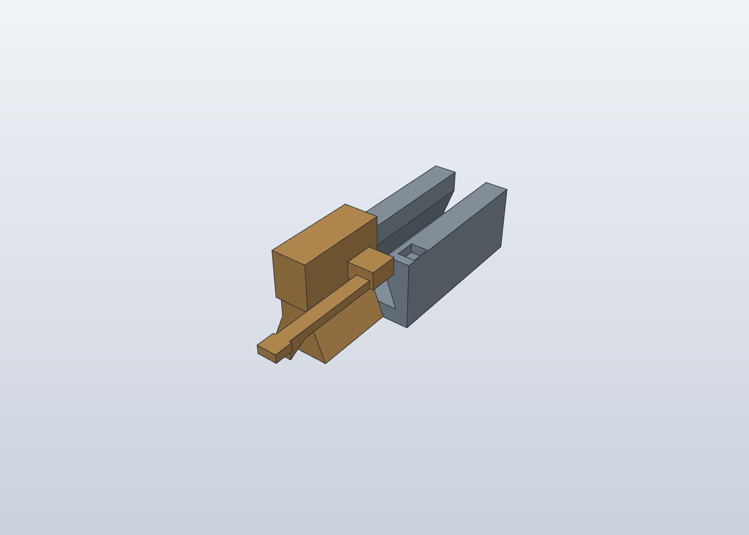
cad/tower-dovetail/dovetail-detail.png
