ebf-hue/mini-scos/cad/wrist-architecture/wrist-inward-closeup.png

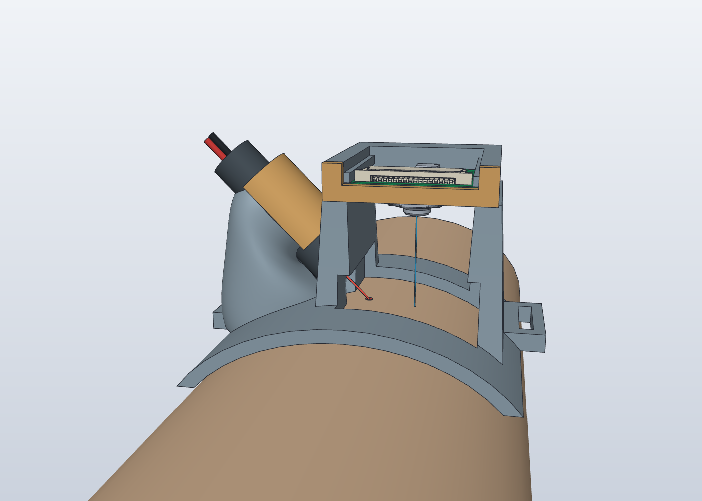
cad/wrist-architecture/wrist-inward-closeup.png
