ebf-hue/mini-scos/docs/Laser Speckle Imaging Workflow.png

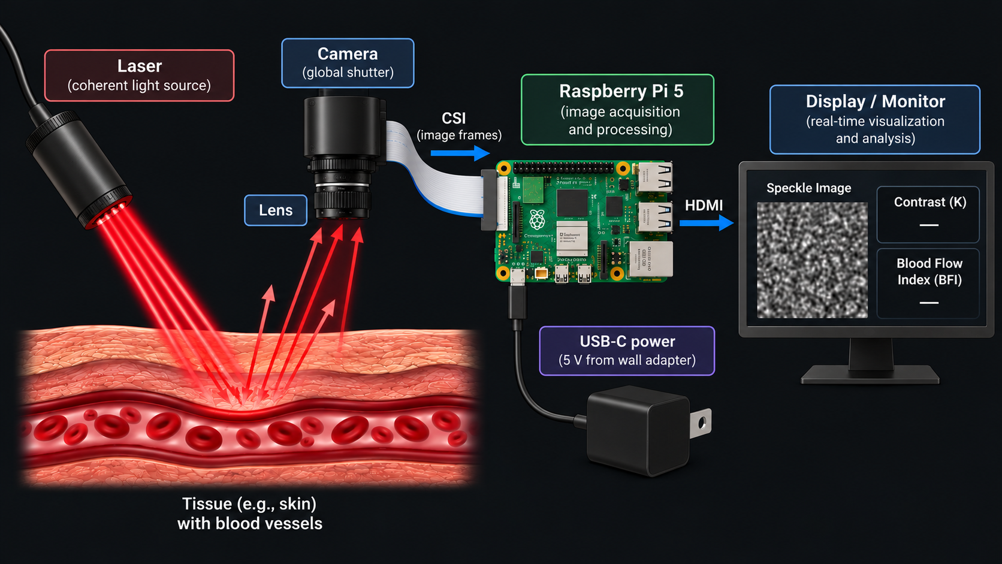
docs/Laser Speckle Imaging Workflow.png
