ebf-hue/mini-scos/software/examples/images/high.png

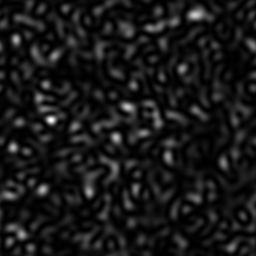
software/examples/images/high.png
