ebf-hue/mini-scos/software/examples/images/low.png

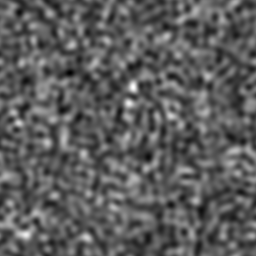
software/examples/images/low.png
