ebf-hue/mini-scos/cad/04-c-rest-printable/print_parts.png

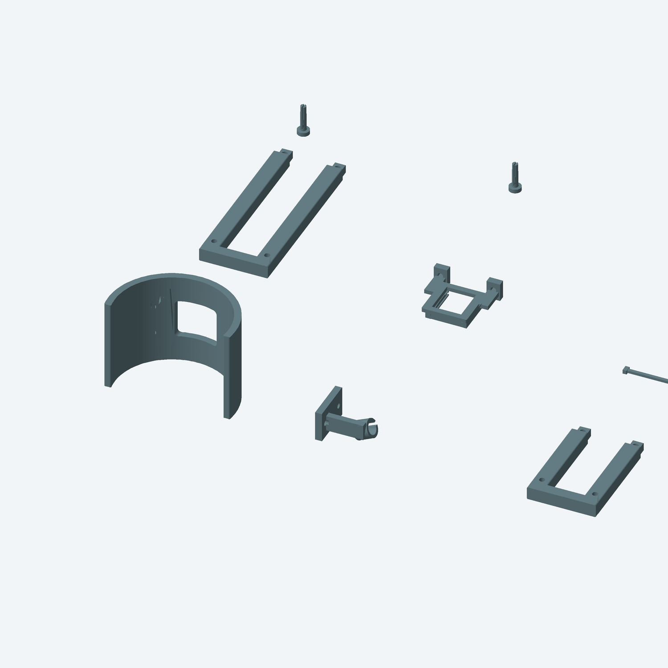
cad/04-c-rest-printable/print_parts.png
