ebf-hue/mini-scos/cad/12-solidcraft-mount-v7/standard_exports/assembly_standard.step

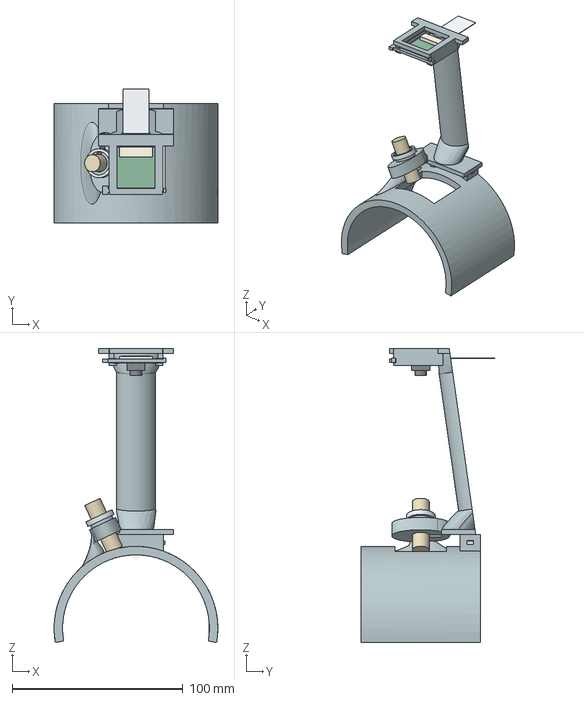
[picture p57: CAD file, 2026-11-04]
cad/12-solidcraft-mount-v7/standard_exports/assembly_standard.step
96.0 x 78.5 x 172.3 mm
