ebf-hue/mini-scos/cad/06-solidcraft-mount-v1/exports/assembly_standard.step

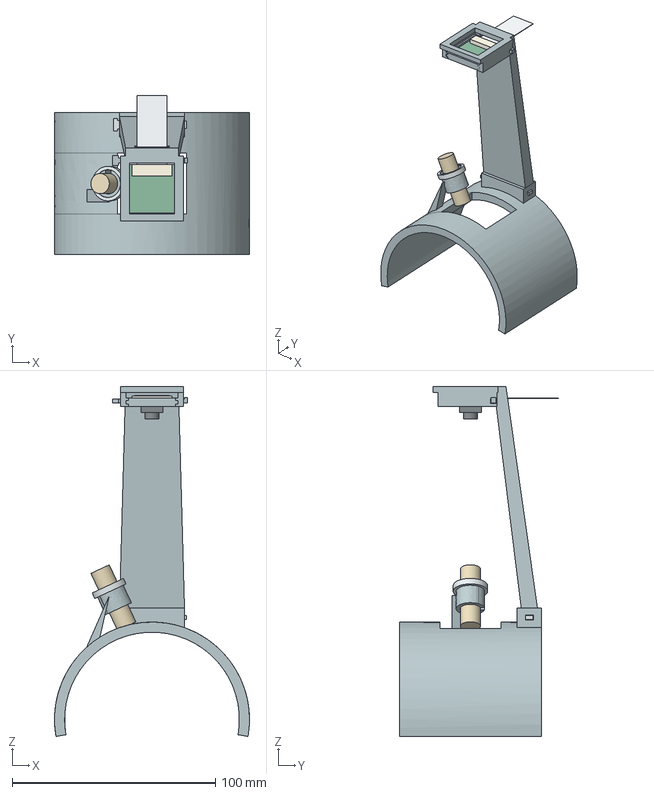
[picture p58: CAD file, 2026-11-04]
cad/06-solidcraft-mount-v1/exports/assembly_standard.step
96.0 x 78.5 x 172.3 mm
