ebf-hue/mini-scos/cad/07-solidcraft-mount-v2/exports/assembly_wide.step

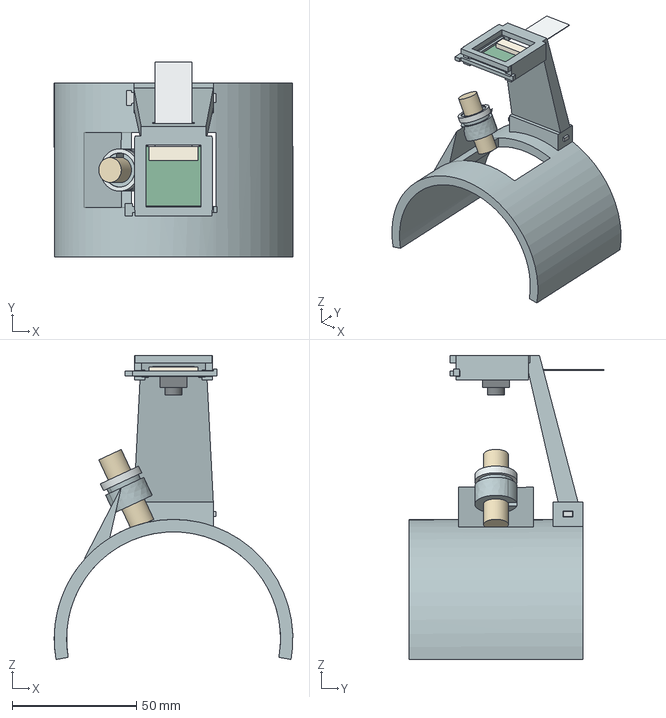
[picture p59: CAD file, 2026-11-04]
cad/07-solidcraft-mount-v2/exports/assembly_wide.step
96.0 x 78.5 x 122.3 mm
