ebf-hue/mini-scos/cad/11-solidcraft-mount-v6/exports/assembly_wide.step

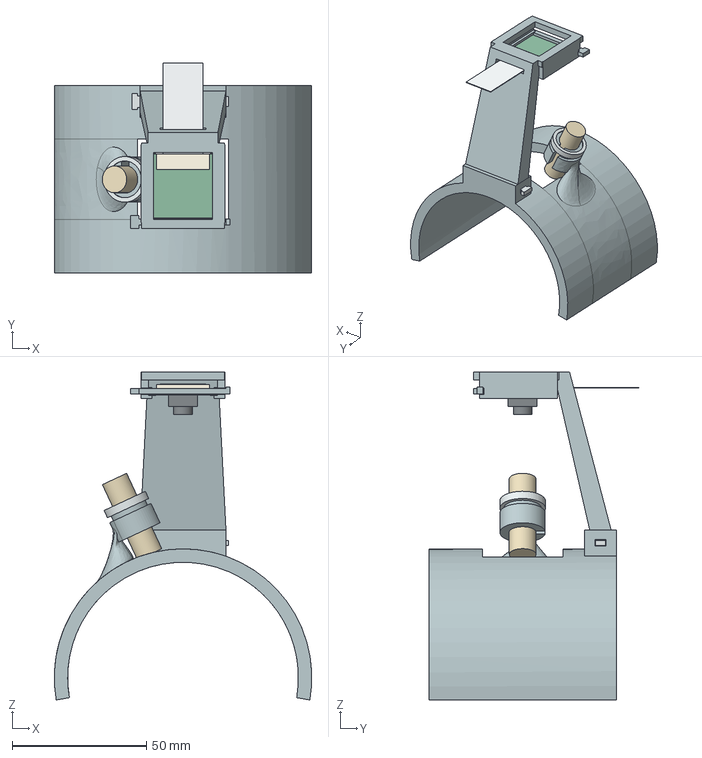
[picture p60: CAD file, 2026-11-04]
cad/11-solidcraft-mount-v6/exports/assembly_wide.step
96.0 x 78.5 x 122.3 mm
