ebf-hue/mini-scos/cad/03-c-rest-module3/exports/assembly.step

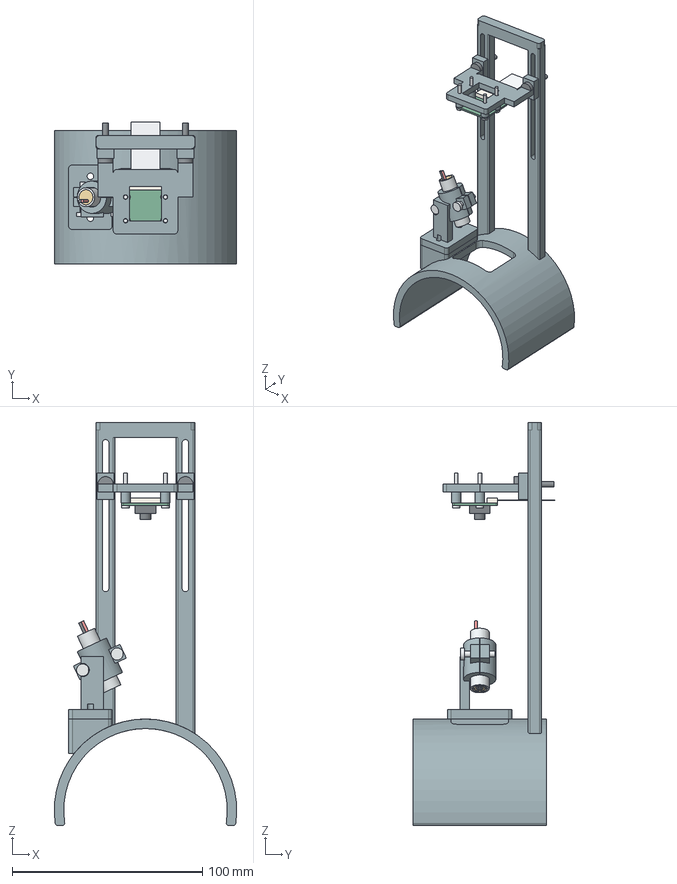
[picture p61: CAD file, 2026-11-04]
cad/03-c-rest-module3/exports/assembly.step
96.0 x 74.5 x 212.0 mm
c_rest
camera_carrier
laser_cradle
laser_cap
camera_module3_PCB_reference
camera_lens_reference
lens_glass_reference
FFC_connector_reference
ribbon_reference
Adafruit1054_reference_0
Adafruit1054_reference_1
Adafruit1054_reference_2
Adafruit1054_reference_3
Adafruit1054_reference_4
camera_height_M3_-21
camera_height_M3_21
camera_M2_-10.5_-12.4
camera_M2_-10.5_0.1
camera_M2_10.5_-12.4
camera_M2_10.5_0.1
laser_clamp_M3_-10
laser_clamp_M3_10
