ebf-hue/mini-scos/cad/04-c-rest-printable/exports/assembly_wide.step

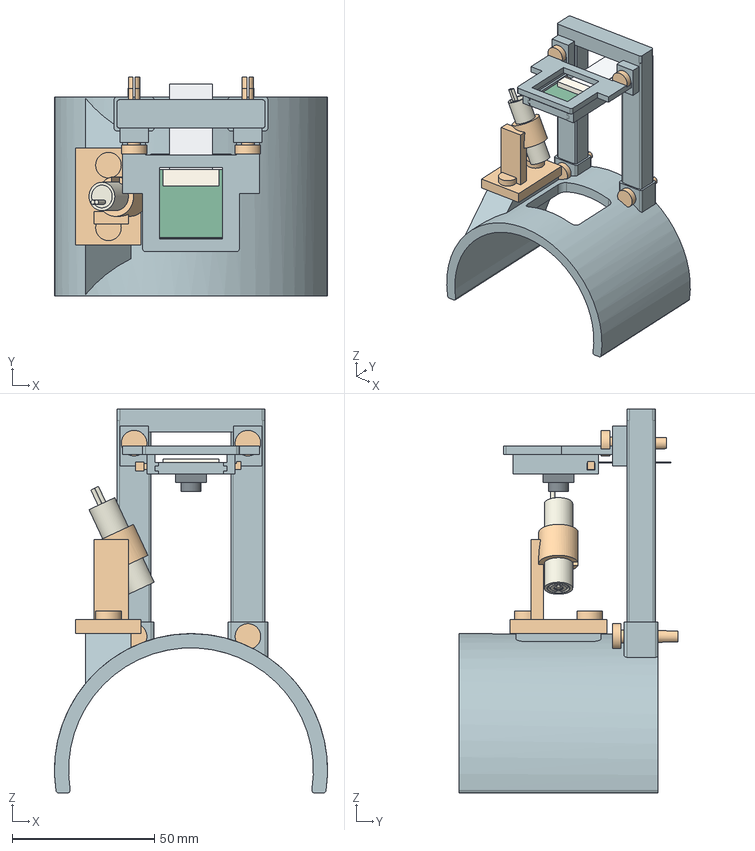
[picture p62: CAD file, 2026-11-04]
cad/04-c-rest-printable/exports/assembly_wide.step
96.0 x 77.0 x 134.9 mm
rest
laser_clip
tower
cassette
keeper
base_pin_-20
camera_pin_-20
base_pin_20
camera_pin_20
laser_pin_-11
laser_pin_11
PCB
lens_envelope
connector
laser
ribbon
