ebf-hue/mini-scos/cad/01-bench-fixture/exports/camera_bracket.step

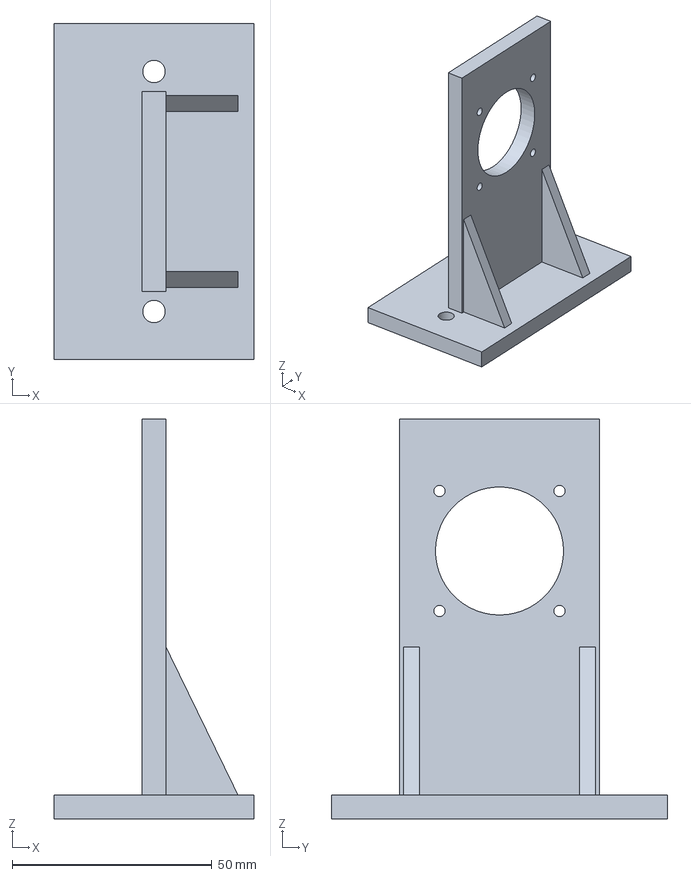
[picture p64: CAD file, 2026-11-04]
cad/01-bench-fixture/exports/camera_bracket.step
50.0 x 84.0 x 100.0 mm
