ebf-hue/mini-scos/cad/02-arm-cuff-concept/exports/filter_frame.step

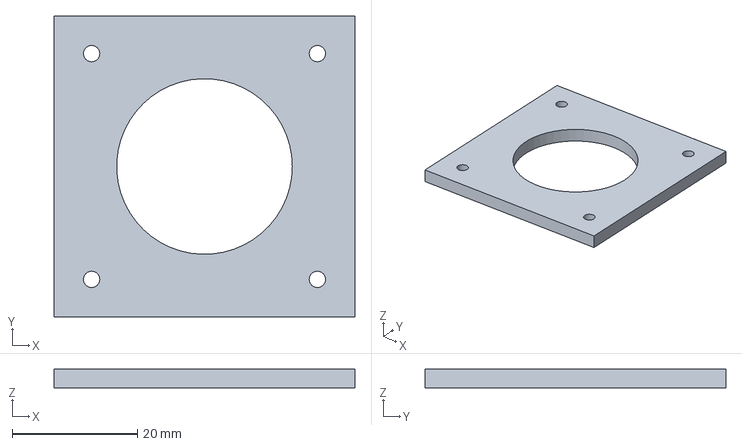
[picture p65: CAD file, 2026-11-04]
cad/02-arm-cuff-concept/exports/filter_frame.step
48.0 x 48.0 x 3.00 mm
