ebf-hue/mini-scos/cad/02-arm-cuff-concept/sources/forearm_scan/life-cast-of-left-forearm-and-hand-150k.obj

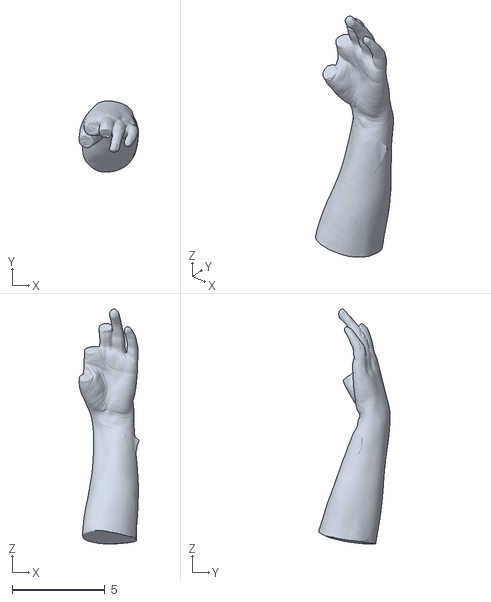
[picture p66: CAD file, 2026-11-04]
cad/02-arm-cuff-concept/sources/forearm_scan/life-cast-of-left-forearm-and-hand-150k.obj
3.21 x 3.84 x 12.6
