ebf-hue/mini-scos/cad/03-c-rest-module3/exports/dimensions.dxf

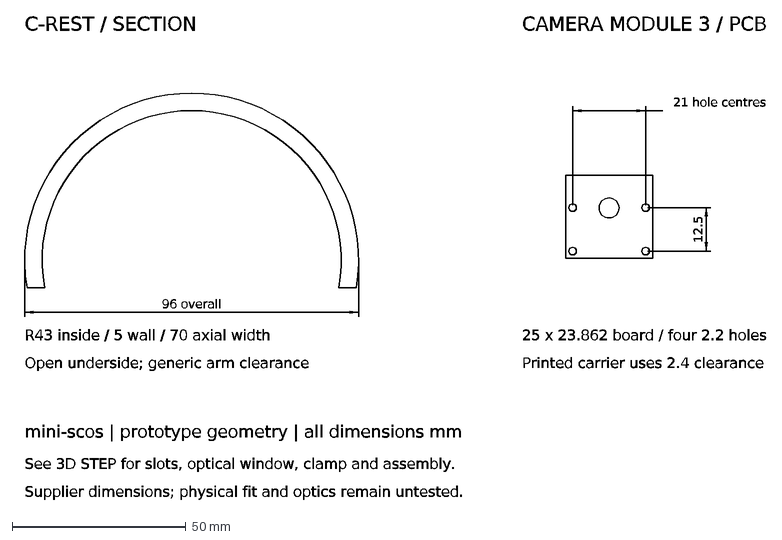
[picture p67: CAD file, 2026-11-04]
cad/03-c-rest-module3/exports/dimensions.dxf
C-REST / SECTION
R43 inside / 5 wall / 70 axial width
Open underside; generic arm clearance
96 overall
21 hole centres
12.5
CAMERA MODULE 3 / PCB
25 x 23.862 board / four 2.2 holes
Printed carrier uses 2.4 clearance
mini-scos | prototype geometry | all dimensions mm
See 3D STEP for slots, optical window, clamp and assembly.
Supplier dimensions; physical fit and optics remain untested.
