ebf-hue/mini-scos/cad/04-c-rest-printable/exports/camera_cassette.step

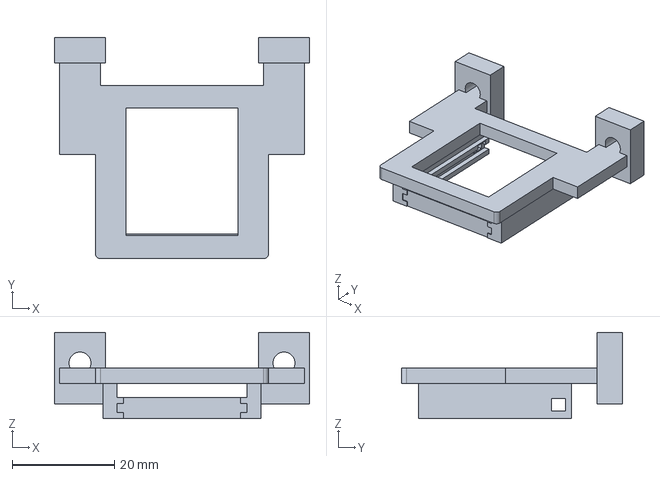
[picture p68: CAD file, 2026-11-04]
cad/04-c-rest-printable/exports/camera_cassette.step
50.0 x 43.4 x 16.9 mm
