ebf-hue/mini-scos/cad/06-solidcraft-mount-v1/bambu/fit_test/fit_test.3mf

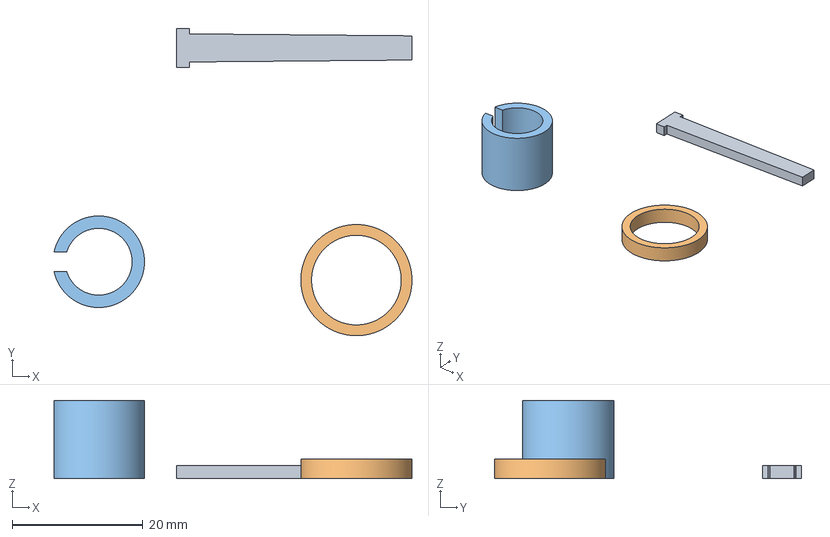
[picture p69: CAD file, 2026-11-04]
cad/06-solidcraft-mount-v1/bambu/fit_test/fit_test.3mf
54.7 x 47.0 x 12.0 mm
LockingKey.stl
LaserBand.stl
FitCollar.stl
