ebf-hue/mini-scos/cad/06-solidcraft-mount-v1/bambu/mount_standard/mount_standard.3mf

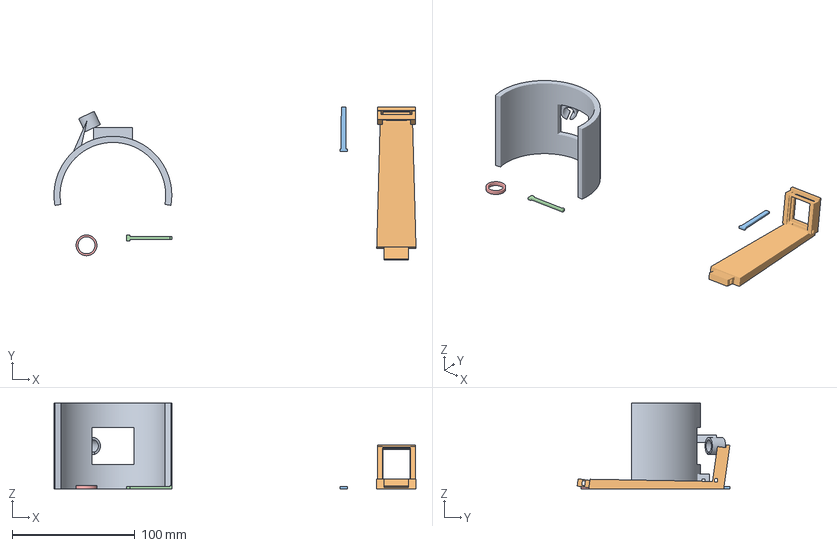
[picture p70: CAD file, 2026-11-04]
cad/06-solidcraft-mount-v1/bambu/mount_standard/mount_standard.3mf
295.0 x 124.5 x 70.0 mm
Rest.stl
SpineCamera_standard.stl
LockingKey.stl
Keeper.stl
LaserBand.stl
