ebf-hue/mini-scos/cad/06-solidcraft-mount-v1/bambu/mount_standard_single/layout.3mf

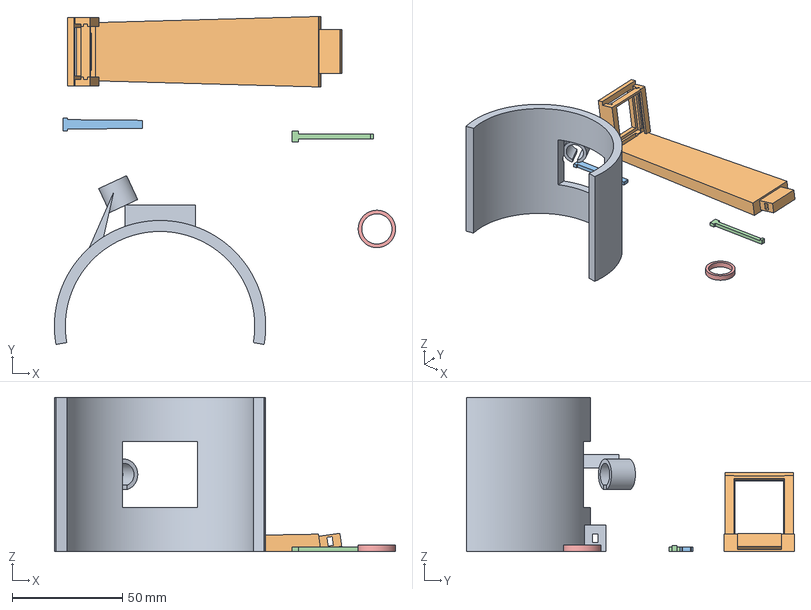
[picture p71: CAD file, 2026-11-04]
cad/06-solidcraft-mount-v1/bambu/mount_standard_single/layout.3mf
155.0 x 149.0 x 70.0 mm
Rest.stl
SpineCamera_standard.stl
LockingKey.stl
Keeper.stl
LaserBand.stl
