ebf-hue/mini-scos/cad/06-solidcraft-mount-v1/bambu/mount_wide/mount_wide.3mf

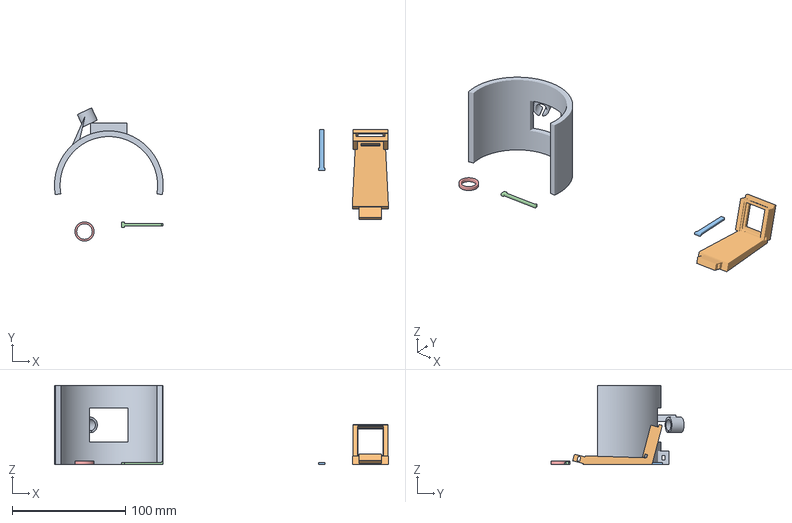
[picture p72: CAD file, 2026-11-04]
cad/06-solidcraft-mount-v1/bambu/mount_wide/mount_wide.3mf
295.0 x 117.7 x 70.0 mm
Rest.stl
SpineCamera.stl
LockingKey.stl
Keeper.stl
LaserBand.stl
