ebf-hue/mini-scos/cad/06-solidcraft-mount-v1/bambu/mount_wide_single/mount_wide_single.3mf

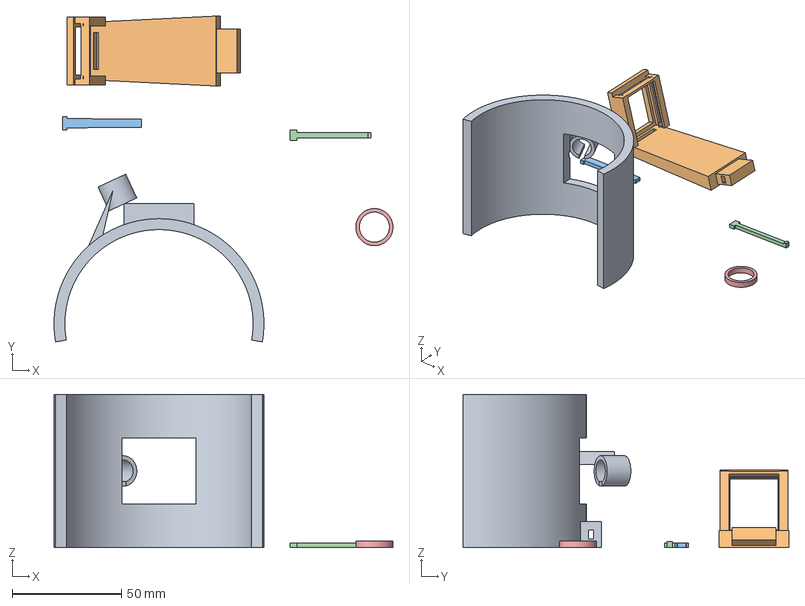
[picture p73: CAD file, 2026-11-04]
cad/06-solidcraft-mount-v1/bambu/mount_wide_single/mount_wide_single.3mf
155.0 x 149.0 x 70.0 mm
Rest.stl
SpineCamera.stl
LockingKey.stl
Keeper.stl
LaserBand.stl
