ebf-hue/mini-scos/cad/06-solidcraft-mount-v1/bambu/oriented/SpineCamera_standard.stl

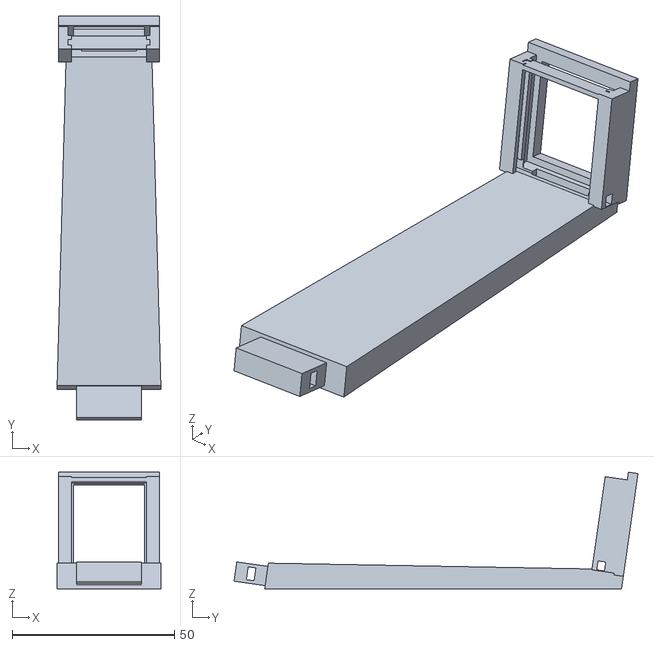
[picture p74: CAD file, 2026-11-04]
cad/06-solidcraft-mount-v1/bambu/oriented/SpineCamera_standard.stl
32.0 x 124.5 x 36.0
