ebf-hue/mini-scos/cad/06-solidcraft-mount-v1/exports/SpineCamera_standard.stl

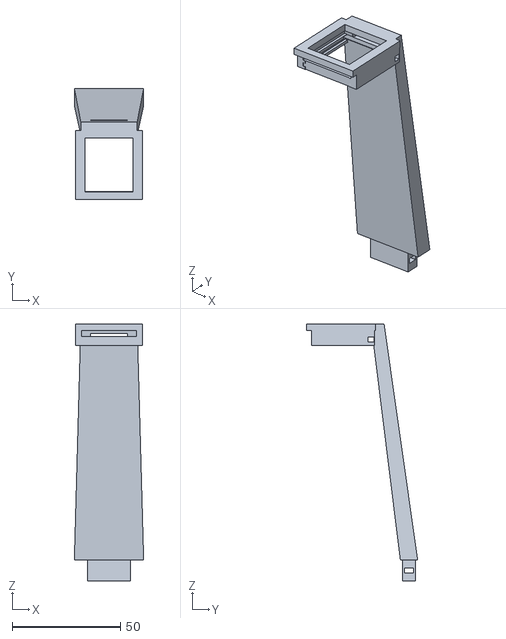
[picture p75: CAD file, 2026-11-04]
cad/06-solidcraft-mount-v1/exports/SpineCamera_standard.stl
32.0 x 51.4 x 118.6
