ebf-hue/mini-scos/cad/07-solidcraft-mount-v2/bambu/mount_standard/mount_standard.3mf

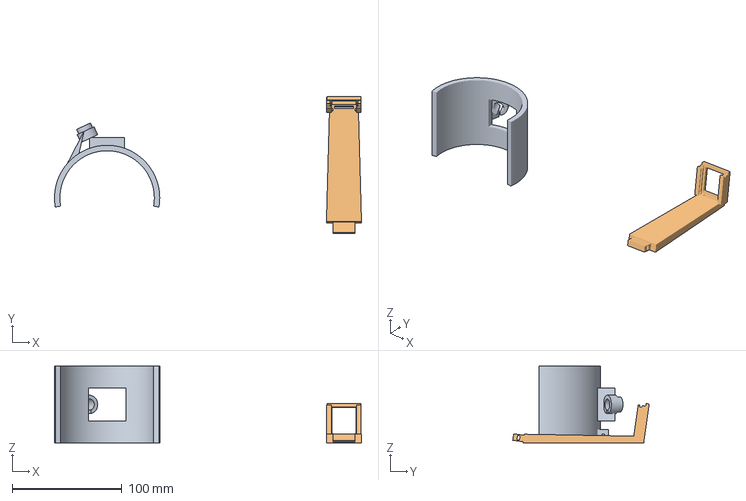
[picture p76: CAD file, 2026-11-04]
cad/07-solidcraft-mount-v2/bambu/mount_standard/mount_standard.3mf
280.0 x 124.5 x 70.0 mm
Rest.stl
SpineCamera_standard.stl
