ebf-hue/mini-scos/cad/07-solidcraft-mount-v2/bambu/mount_standard_single/layout.3mf

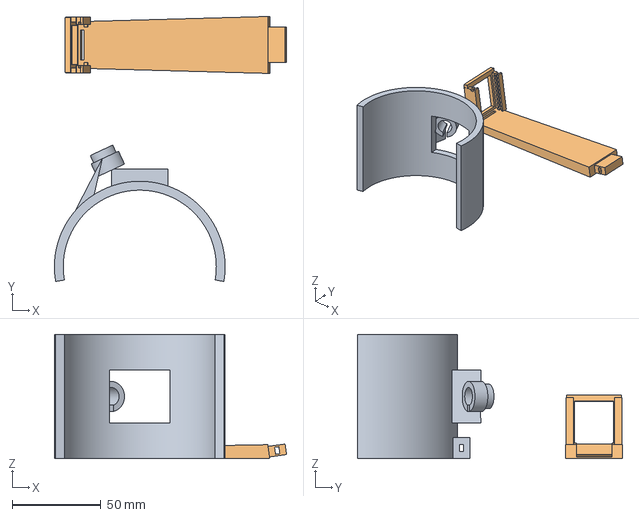
[picture p77: CAD file, 2026-11-04]
cad/07-solidcraft-mount-v2/bambu/mount_standard_single/layout.3mf
130.5 x 149.0 x 70.0 mm
Rest.stl
SpineCamera_standard.stl
