ebf-hue/mini-scos/cad/07-solidcraft-mount-v2/bambu/mount_wide/mount_wide.3mf

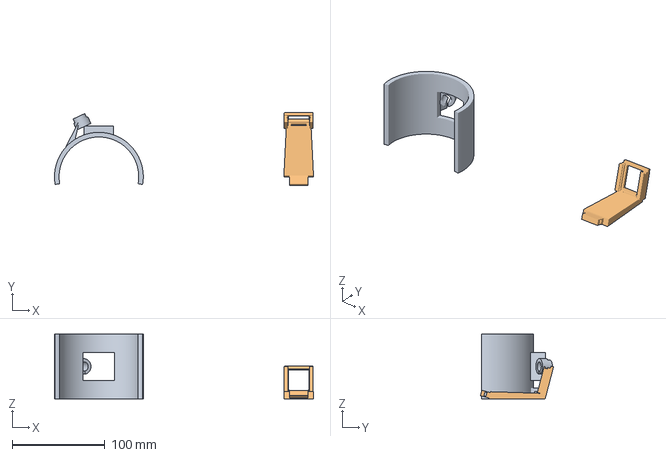
[picture p78: CAD file, 2026-11-04]
cad/07-solidcraft-mount-v2/bambu/mount_wide/mount_wide.3mf
280.0 x 79.2 x 70.0 mm
Rest.stl
SpineCamera.stl
