ebf-hue/mini-scos/cad/07-solidcraft-mount-v2/bambu/mount_wide_single/layout.3mf

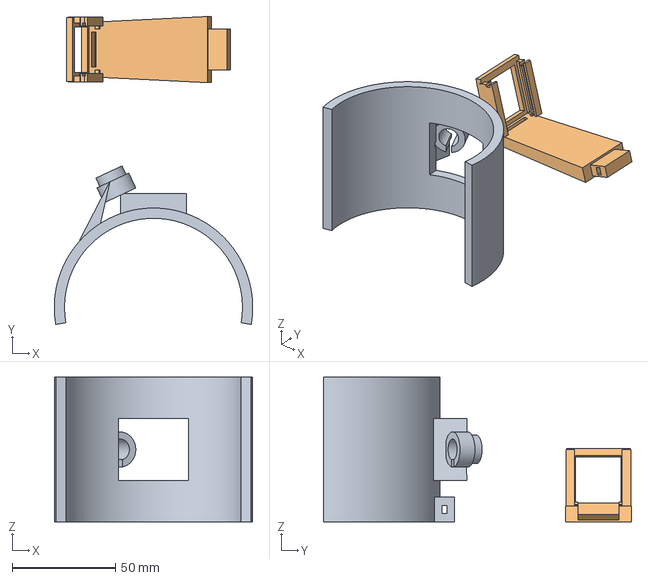
[picture p79: CAD file, 2026-11-04]
cad/07-solidcraft-mount-v2/bambu/mount_wide_single/layout.3mf
96.0 x 149.0 x 70.0 mm
Rest.stl
SpineCamera.stl
