ebf-hue/mini-scos/cad/07-solidcraft-mount-v2/exports/Rest.step

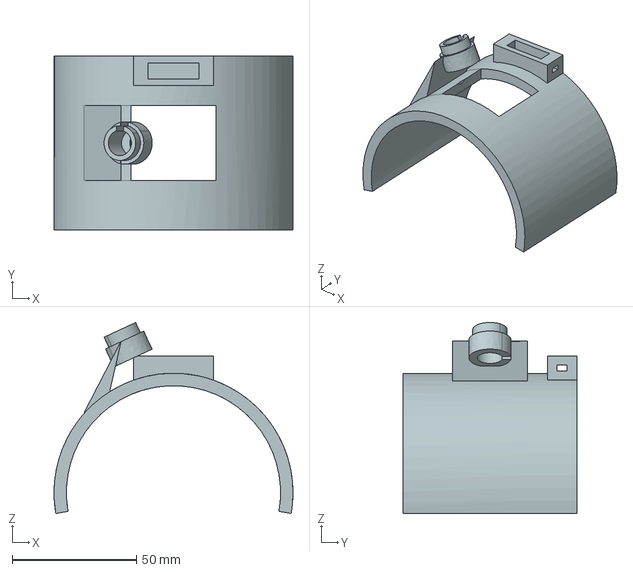
[picture p80: CAD file, 2026-11-04]
cad/07-solidcraft-mount-v2/exports/Rest.step
96.0 x 70.0 x 76.7 mm
