ebf-hue/mini-scos/cad/08-solidcraft-mount-v3/exports/SpineCamera.stl

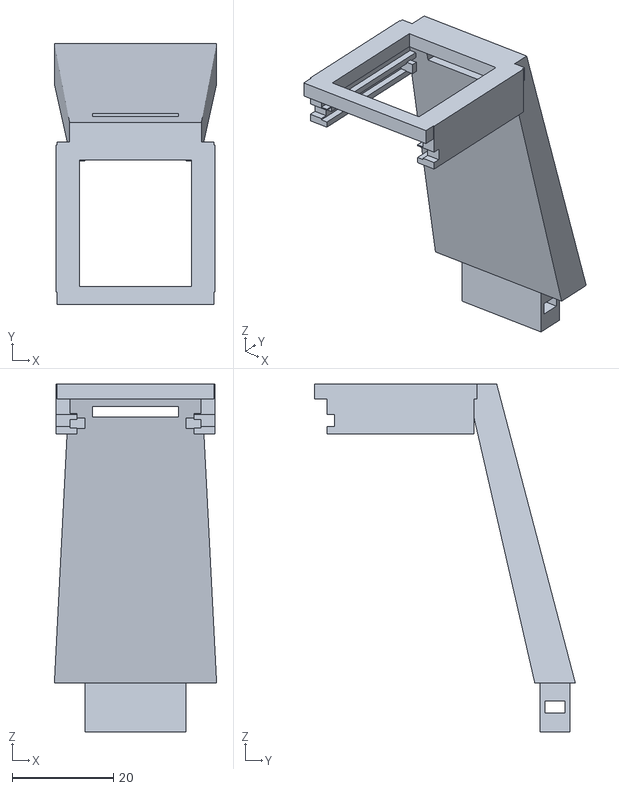
[picture p81: CAD file, 2026-11-04]
cad/08-solidcraft-mount-v3/exports/SpineCamera.stl
32.0 x 51.4 x 68.6
