ebf-hue/mini-scos/cad/09-solidcraft-mount-v4/bambu/mount_standard/mount_standard.3mf

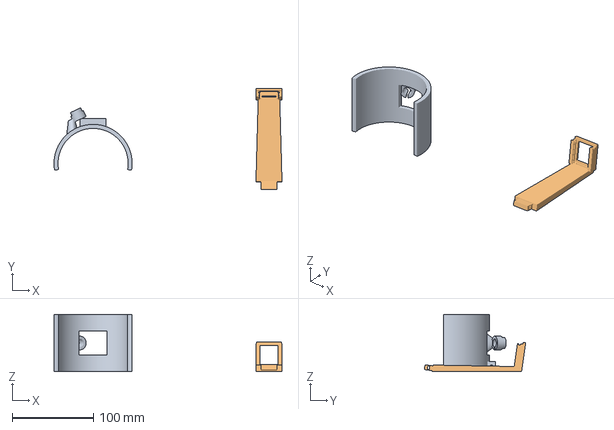
[picture p82: CAD file, 2026-11-04]
cad/09-solidcraft-mount-v4/bambu/mount_standard/mount_standard.3mf
280.0 x 124.5 x 70.0 mm
Rest.stl
SpineCamera_standard.stl
