ebf-hue/mini-scos/cad/09-solidcraft-mount-v4/bambu/mount_standard_single/mount_standard_single.3mf

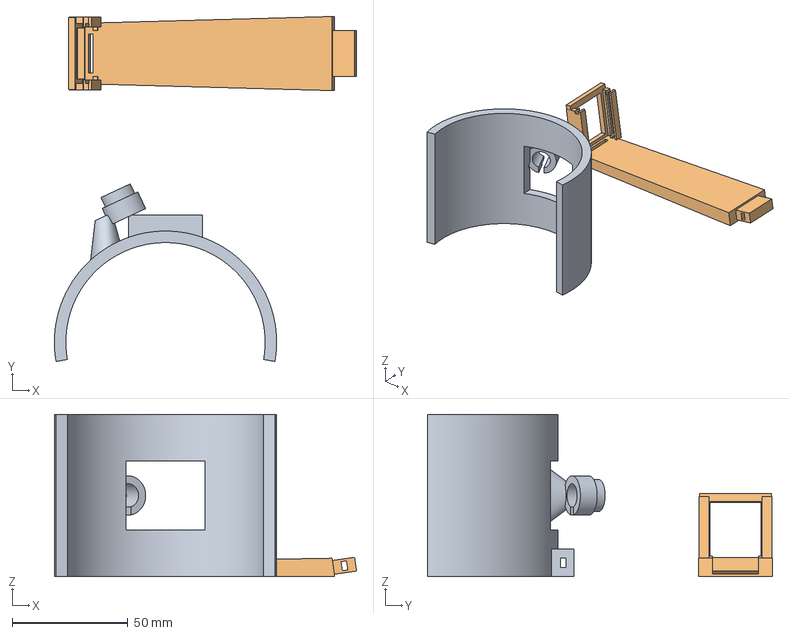
[picture p83: CAD file, 2026-11-04]
cad/09-solidcraft-mount-v4/bambu/mount_standard_single/mount_standard_single.3mf
130.5 x 149.0 x 70.0 mm
Rest.stl
SpineCamera_standard.stl
