ebf-hue/mini-scos/cad/09-solidcraft-mount-v4/bambu/mount_wide/mount_wide.3mf

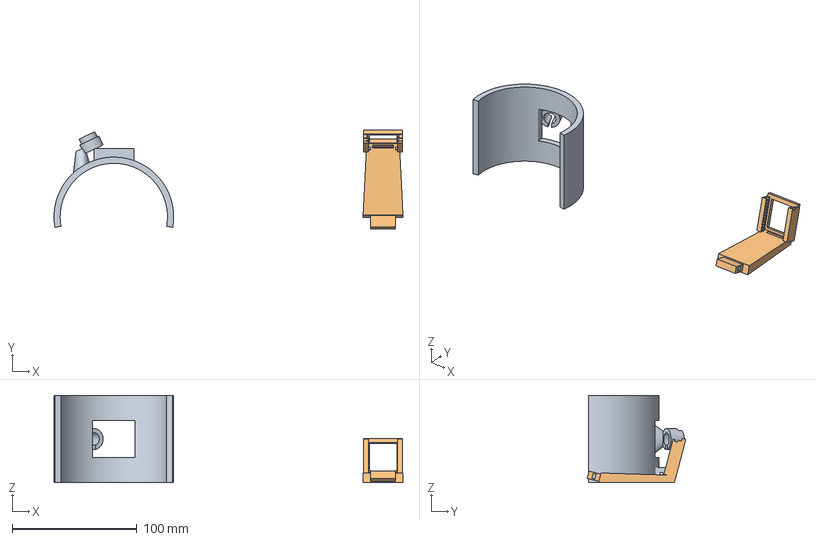
[picture p84: CAD file, 2026-11-04]
cad/09-solidcraft-mount-v4/bambu/mount_wide/mount_wide.3mf
280.0 x 79.2 x 70.0 mm
Rest.stl
SpineCamera.stl
