ebf-hue/mini-scos/cad/09-solidcraft-mount-v4/bambu/mount_wide_single/layout.3mf

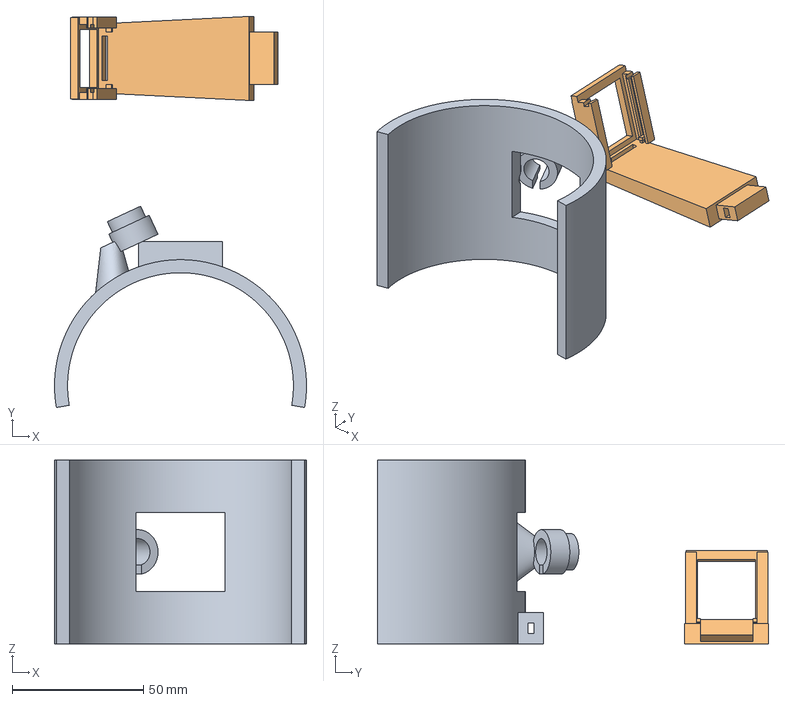
[picture p85: CAD file, 2026-11-04]
cad/09-solidcraft-mount-v4/bambu/mount_wide_single/layout.3mf
96.0 x 149.0 x 70.0 mm
Rest.stl
SpineCamera.stl
