ebf-hue/mini-scos/cad/09-solidcraft-mount-v4/exports/Rest.step

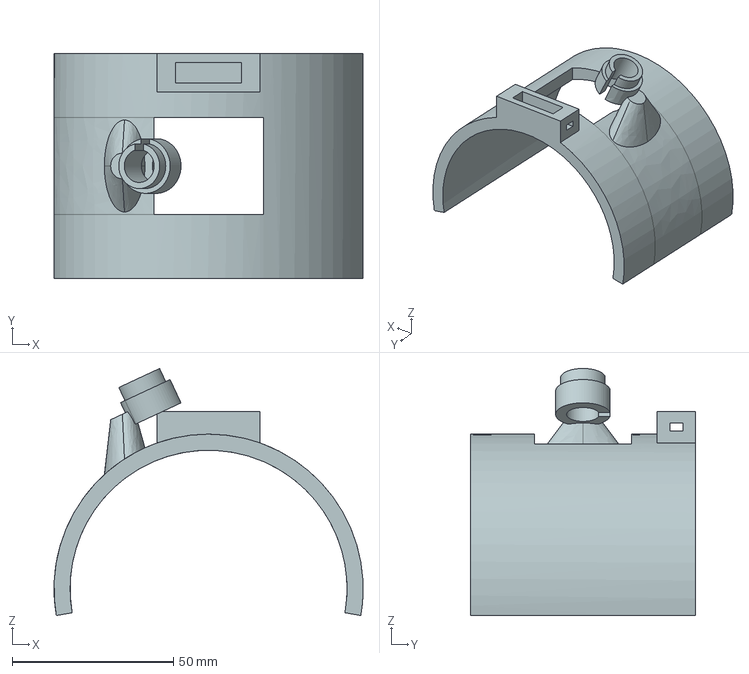
[picture p86: CAD file, 2026-11-04]
cad/09-solidcraft-mount-v4/exports/Rest.step
96.0 x 70.0 x 76.7 mm
