ebf-hue/mini-scos/cad/11-solidcraft-mount-v6/bambu/oriented/SpineCamera.stl

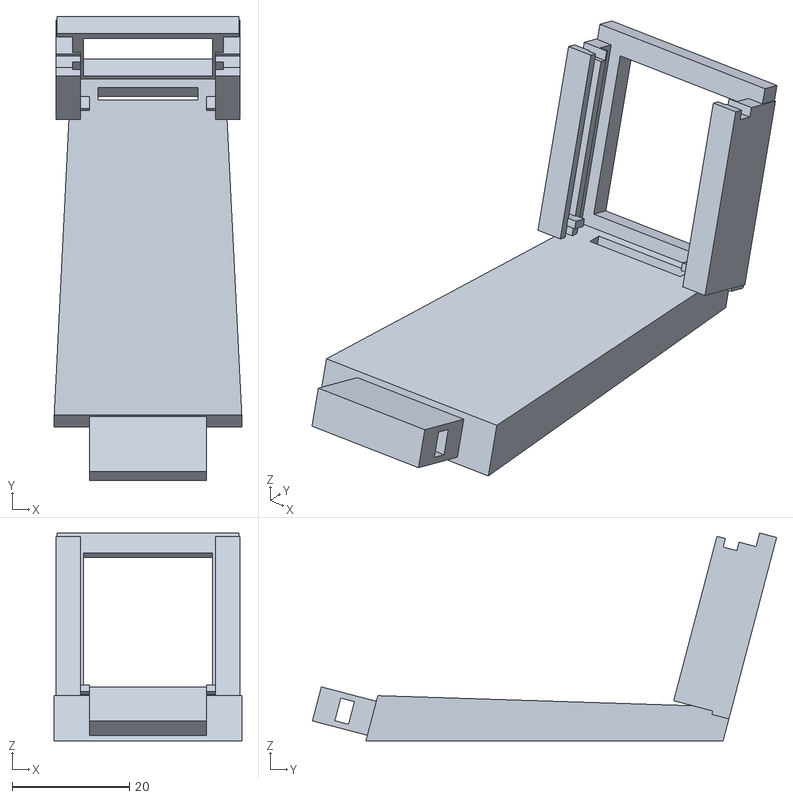
[picture p87: CAD file, 2026-11-04]
cad/11-solidcraft-mount-v6/bambu/oriented/SpineCamera.stl
32.0 x 79.2 x 35.5
