ebf-hue/mini-scos/cad/12-solidcraft-mount-v7/bambu/mount_standard_single/mount_standard_single.3mf

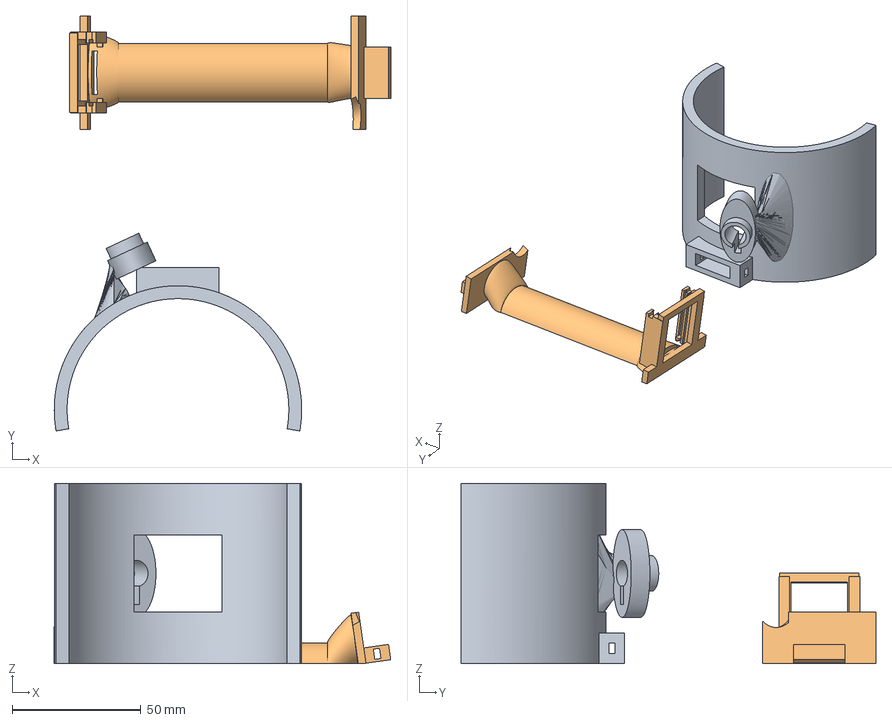
[picture p88: CAD file, 2026-11-04]
cad/12-solidcraft-mount-v7/bambu/mount_standard_single/mount_standard_single.3mf
130.5 x 161.0 x 70.0 mm
Rest.stl
SpineCamera_standard.stl
