ebf-hue/mini-scos/cad/12-solidcraft-mount-v7/bambu/mount_wide/mount_wide.3mf

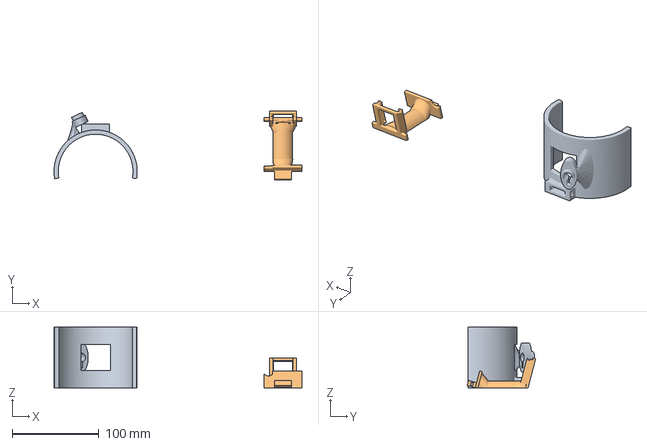
[picture p89: CAD file, 2026-11-04]
cad/12-solidcraft-mount-v7/bambu/mount_wide/mount_wide.3mf
286.0 x 79.2 x 70.0 mm
Rest.stl
SpineCamera.stl
