ebf-hue/mini-scos/cad/12-solidcraft-mount-v7/bambu/mount_wide_single/layout.3mf

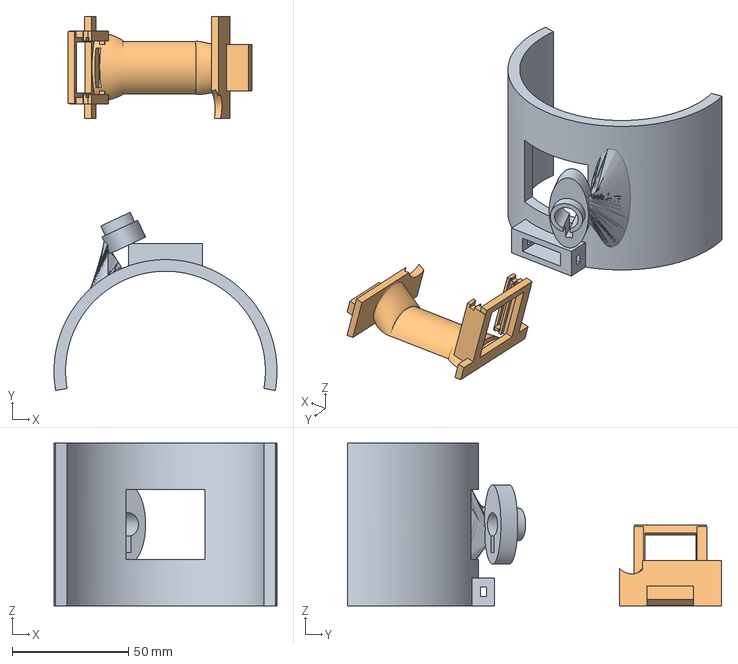
[picture p90: CAD file, 2026-11-04]
cad/12-solidcraft-mount-v7/bambu/mount_wide_single/layout.3mf
96.0 x 161.0 x 70.0 mm
Rest.stl
SpineCamera.stl
