ebf-hue/mini-scos/cad/12-solidcraft-mount-v7/bambu/oriented/SpineCamera.stl

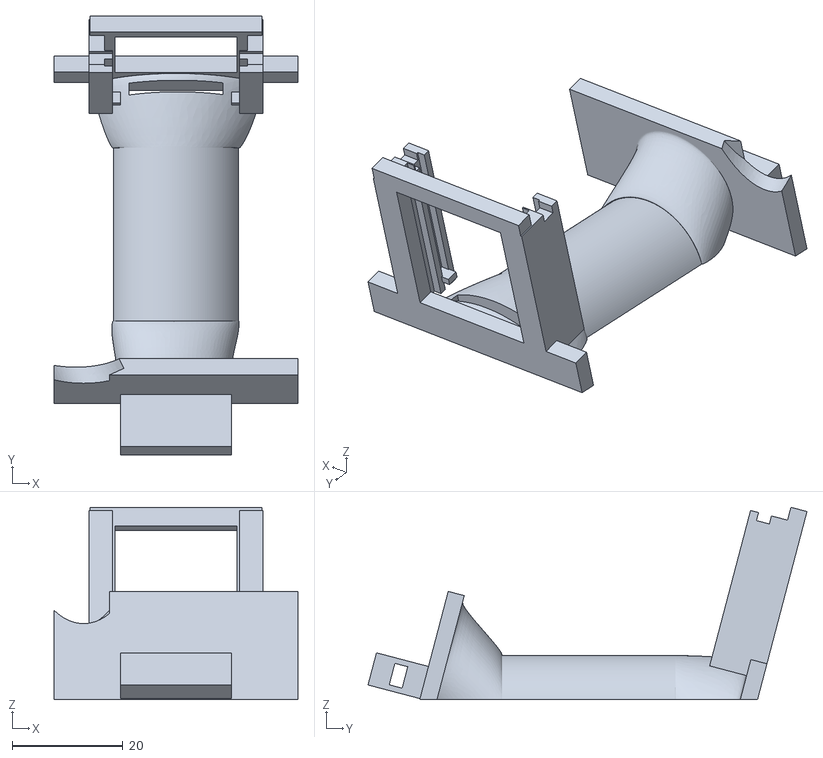
[picture p91: CAD file, 2026-11-04]
cad/12-solidcraft-mount-v7/bambu/oriented/SpineCamera.stl
44.0 x 79.2 x 34.7
