ebf-hue/mini-scos/cad/12-solidcraft-mount-v7/camera_source/standard/SpineCamera.step

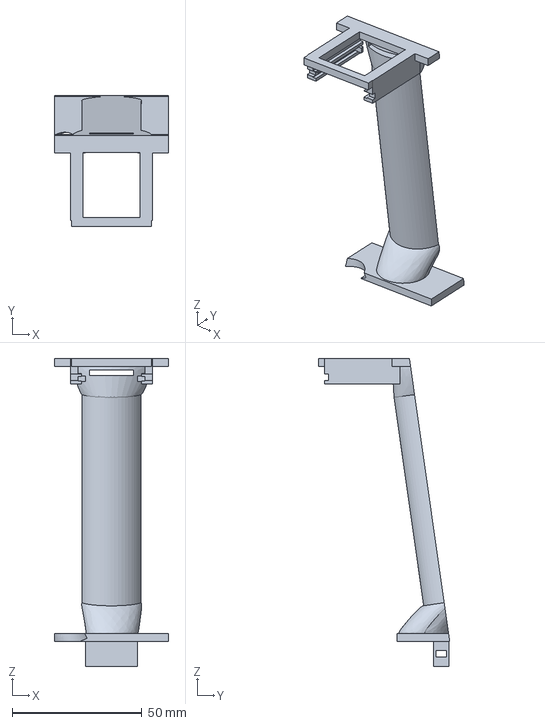
[picture p92: CAD file, 2026-11-04]
cad/12-solidcraft-mount-v7/camera_source/standard/SpineCamera.step
44.0 x 50.6 x 118.6 mm
