ebf-hue/mini-scos/cad/12-solidcraft-mount-v7/camera_source/wide/SpineCamera.step

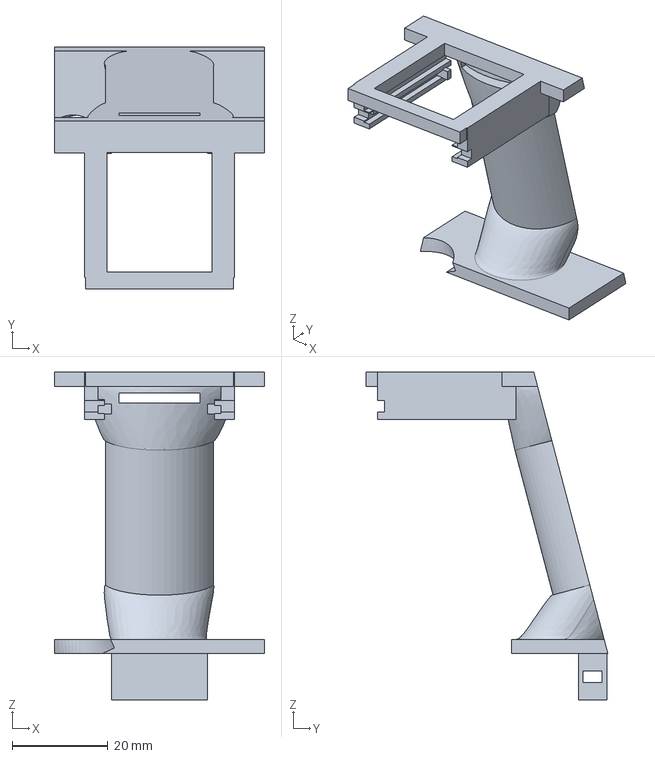
[picture p93: CAD file, 2026-11-04]
cad/12-solidcraft-mount-v7/camera_source/wide/SpineCamera.step
44.0 x 50.6 x 68.6 mm
