ebf-hue/mini-scos/cad/12-solidcraft-mount-v7/exports/LockingKey.stl

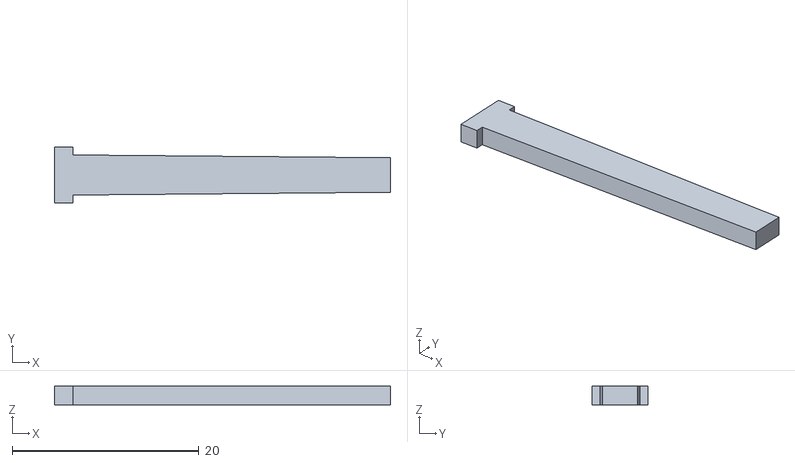
[picture p94: CAD file, 2026-11-04]
cad/12-solidcraft-mount-v7/exports/LockingKey.stl
36.0 x 6.00 x 2.00
