ebf-hue/mini-scos/cad/12-solidcraft-mount-v7/surface_source/experiments/native_blend.step

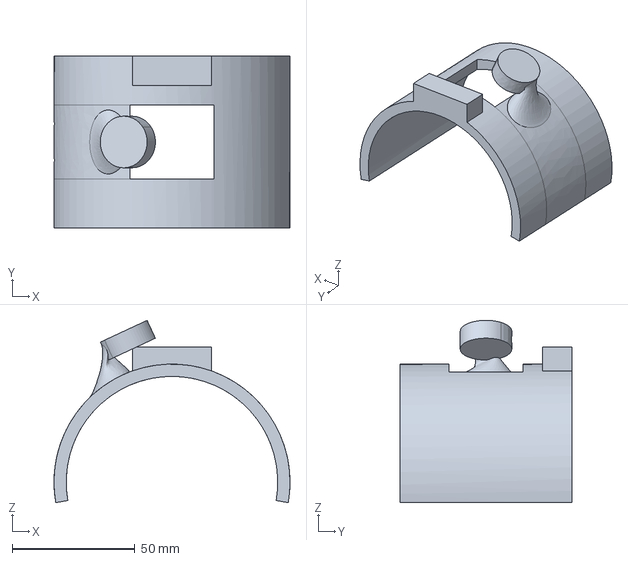
[picture p95: CAD file, 2026-11-04]
cad/12-solidcraft-mount-v7/surface_source/experiments/native_blend.step
96.0 x 70.0 x 74.1 mm
