ebf-hue/mini-scos/cad/12-solidcraft-mount-v7/surface_source/healed_blend.step

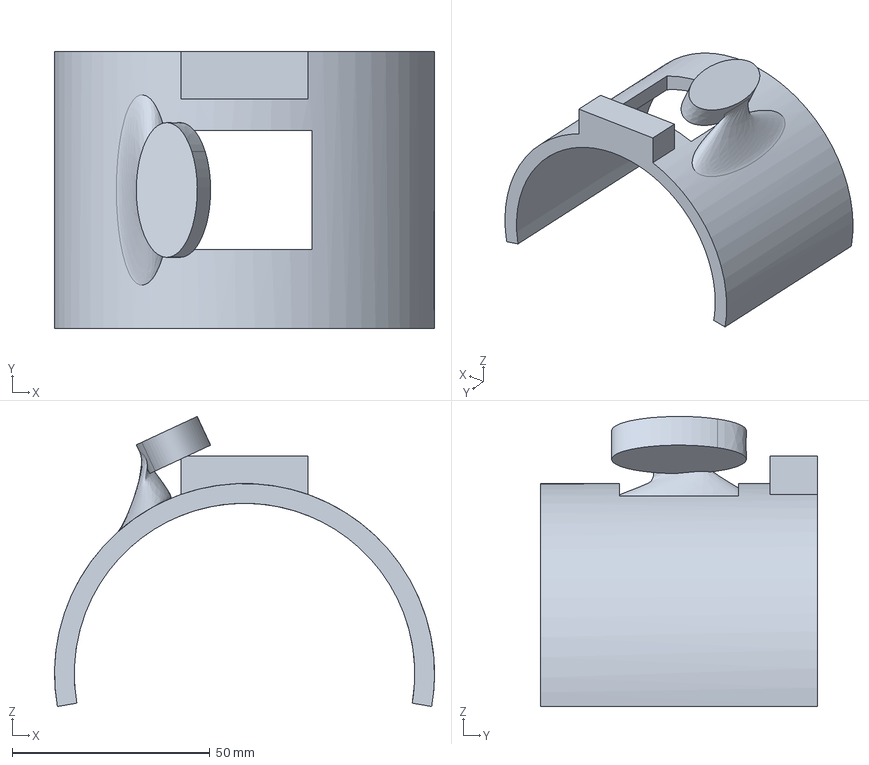
[picture p96: CAD file, 2026-11-04]
cad/12-solidcraft-mount-v7/surface_source/healed_blend.step
96.0 x 70.0 x 73.3 mm
