ebf-hue/mini-scos/cad/13-bench-architecture/bench-concept.step

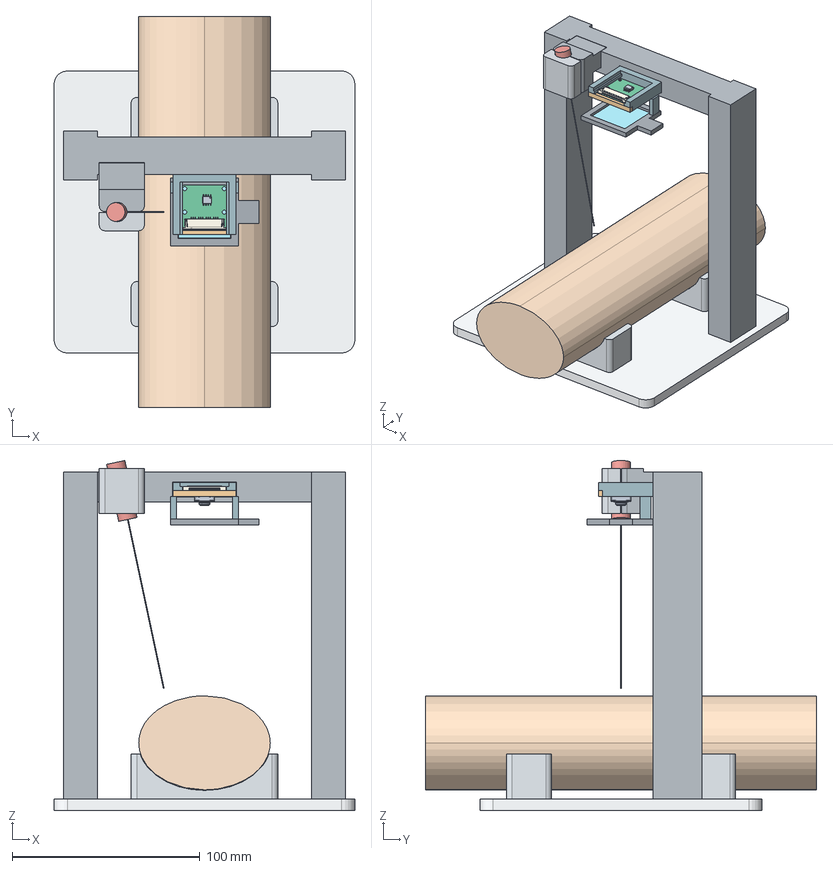
[picture p97: CAD file, 2026-11-04]
cad/13-bench-architecture/bench-concept.step
160.0 x 208.0 x 186.2 mm
OfficialCM3_PCB
OfficialCM3_Connector
