ebf-hue/mini-scos/cad/13-bench-architecture/sources/Camera_module_3_wide_model_simple.stp

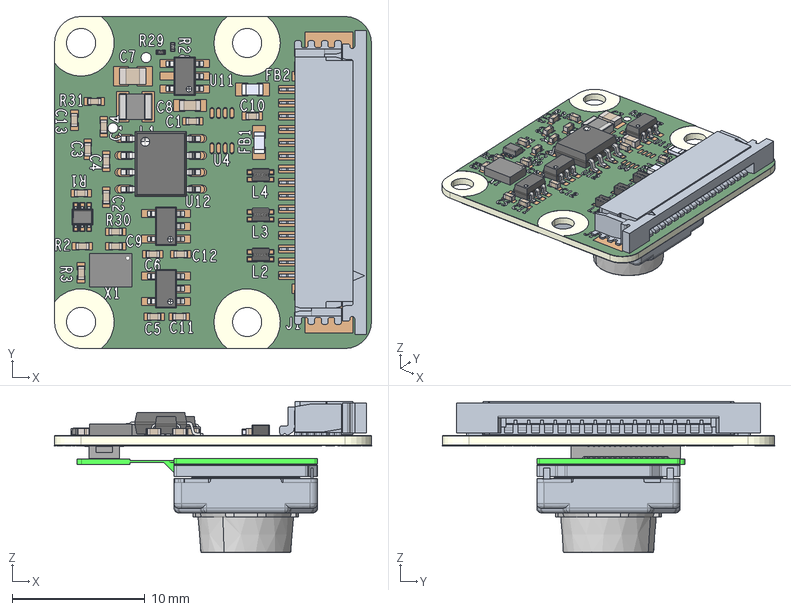
[picture p98: CAD file, 2026-11-04]
cad/13-bench-architecture/sources/Camera_module_3_wide_model_simple.stp
23.9 x 25.0 x 11.4 mm
/PWDN
AFVDD
AGND
D2 x 2
DGND1
DGND2
DGND3
DGND4
DGND5
DGND6
DGND7
DGND8
DGND9
DVDD
DVDD/GPIO
EN x 3
EXP_PAD
FB
G2 x 2
GND x 7
IN x 2
LX
MCKN
MCKP
MCLK
MD0N
MD0P
MD1N
MD1P
MECHANICAL PIN x 6
NC x 2
NC1 x 3
NC2 x 3
NC3 x 2
NC4
NC6
NC7 x 2
OE
OUT x 2
OUTPUT
P1 x 3
P2 x 3
P3 x 3
P4 x 3
PG
S2 x 2
SCL x 3
SDA x 3
VA2V8
VCC x 2
VDD
VIN
VO1V8
SILKSCREEN_TOP
PASTEMASK_TOP
SOLDERMASK_TOP
Dielectric
SOLDERMASK_BOTTOM
PASTEMASK_BOTTOM
SILKSCREEN_BOTTOM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
