ebf-hue/mini-scos/cad/14-wrist-architecture/bambu/laser-loft-check/oriented/WristSaddle.stl

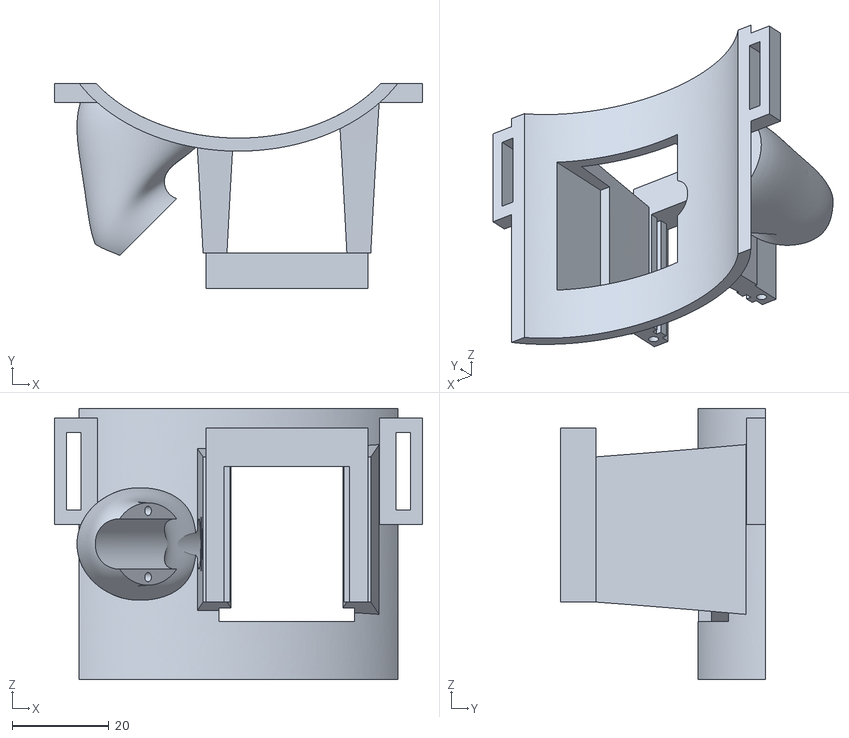
[picture p99: CAD file, 2026-11-04]
cad/14-wrist-architecture/bambu/laser-loft-check/oriented/WristSaddle.stl
76.0 x 42.4 x 56.0
