ebf-hue/mini-scos/cad/14-wrist-architecture/bambu/laser-loft-check/wrist-inward-fit-test/wrist-inward-fit-test.3mf

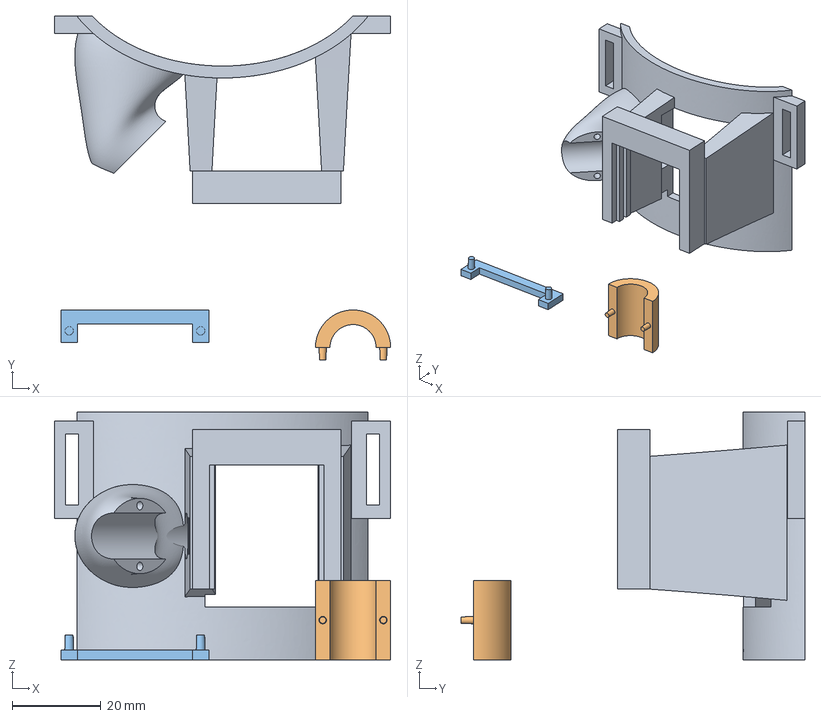
[picture p100: CAD file, 2026-11-04]
cad/14-wrist-architecture/bambu/laser-loft-check/wrist-inward-fit-test/wrist-inward-fit-test.3mf
76.0 x 77.7 x 56.0 mm
WristSaddle.stl
LaserCap.stl
CameraKeeper.stl
