ebf-hue/mini-scos/cad/14-wrist-architecture/bambu/oriented/CameraKeeper.stl

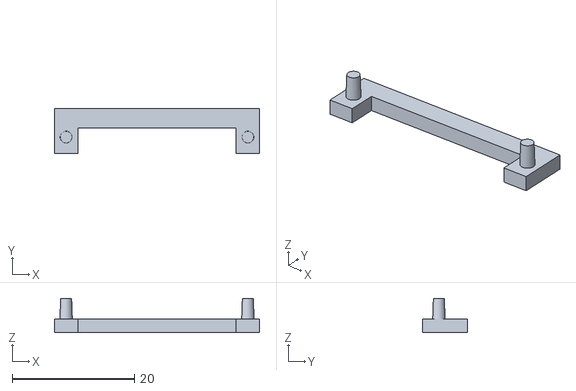
[picture p101: CAD file, 2026-11-04]
cad/14-wrist-architecture/bambu/oriented/CameraKeeper.stl
33.5 x 7.40 x 5.60
