ebf-hue/mini-scos/cad/14-wrist-architecture/wrist-inward.step

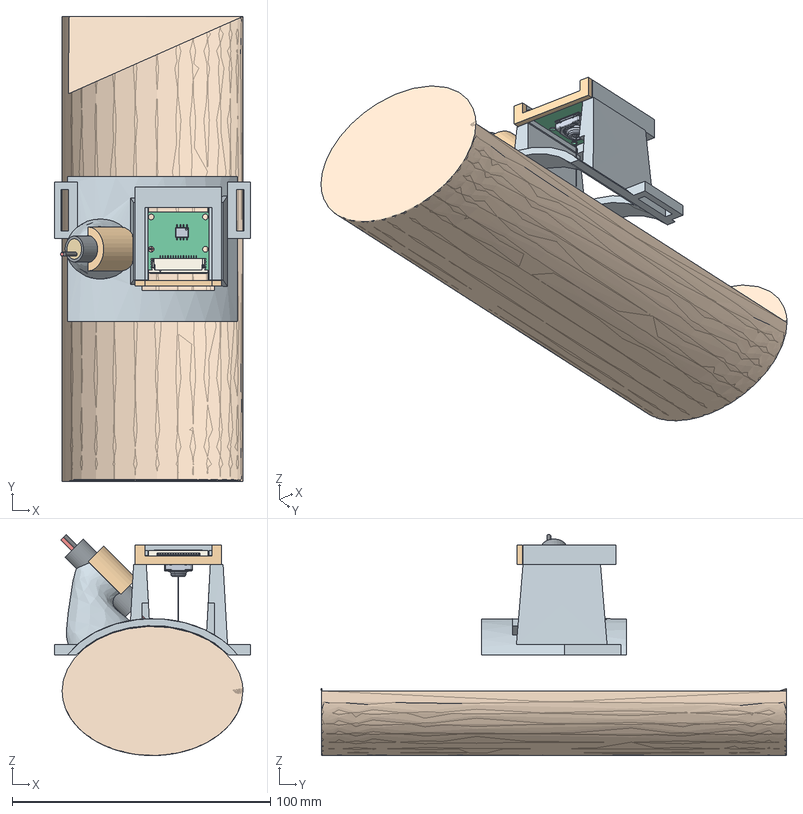
[picture p102: CAD file, 2026-11-04]
cad/14-wrist-architecture/wrist-inward.step
76.0 x 180.0 x 85.6 mm
WristSaddle
CameraKeeper
LaserCap
BeamReference
SpotReference
CameraAxisReference
ArmReference
LaserHousing
LaserInsert
LaserAperture
LaserWireRed
LaserWireBlack
OfficialCM3_PCB
OfficialCM3_Connector
