ebf-hue/mini-scos/cad/15-tower-mechanical/parts/CameraReference.step

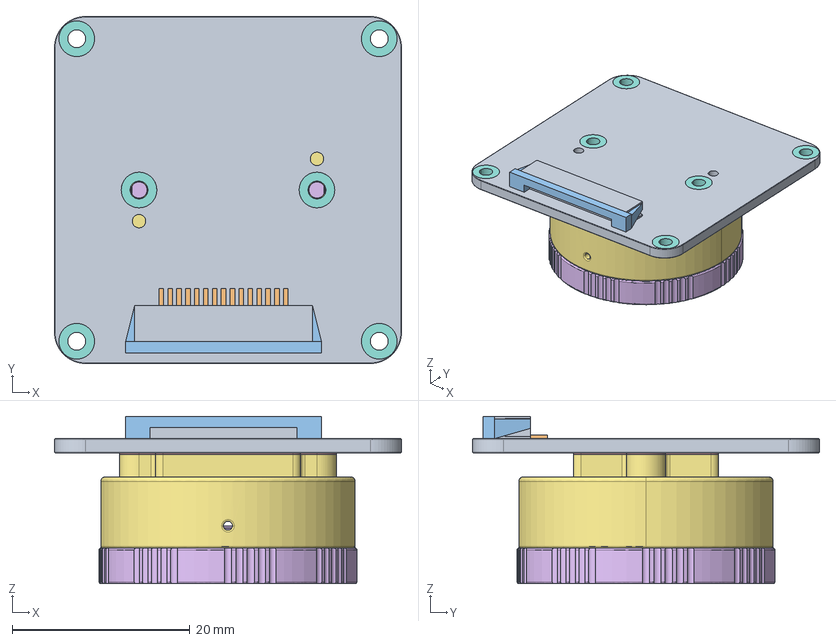
[picture p103: CAD file, 2026-11-04]
cad/15-tower-mechanical/parts/CameraReference.step
39.0 x 39.0 x 18.8 mm
