ebf-hue/mini-scos/cad/15-tower-mechanical/sources/lens-visual/ApertureRing.step

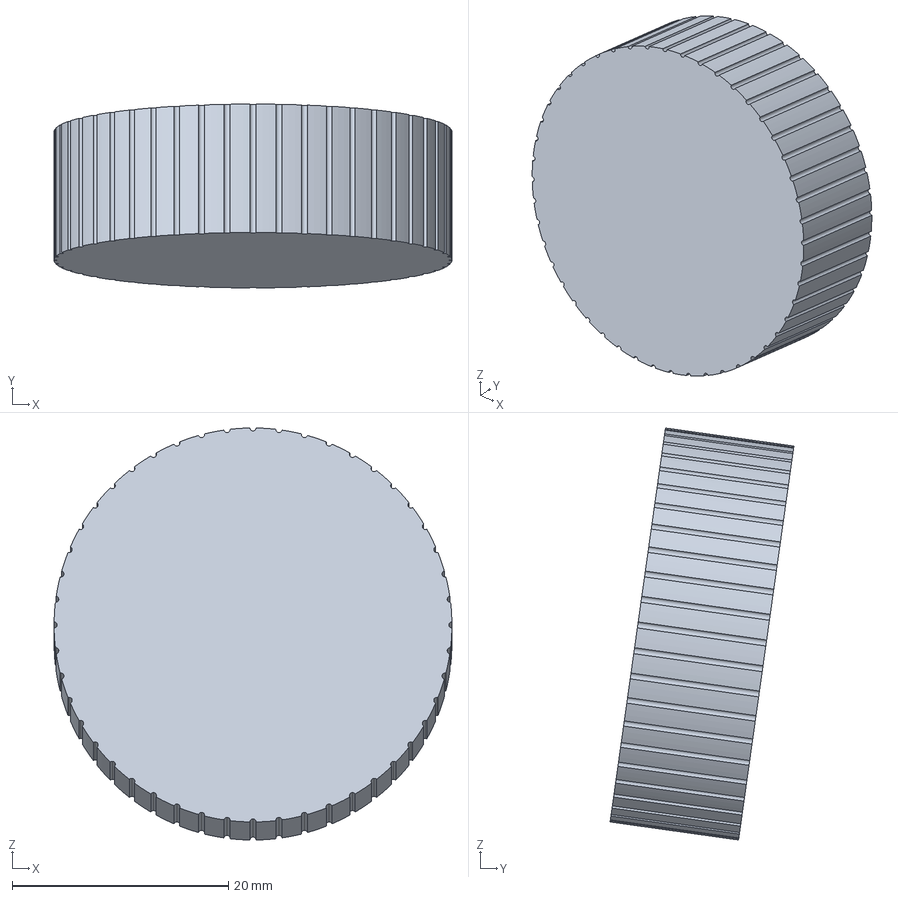
[picture p104: CAD file, 2026-11-04]
cad/15-tower-mechanical/sources/lens-visual/ApertureRing.step
36.8 x 17.0 x 38.1 mm
