ebf-hue/mini-scos/cad/15-tower-mechanical/tower-mechanical.step

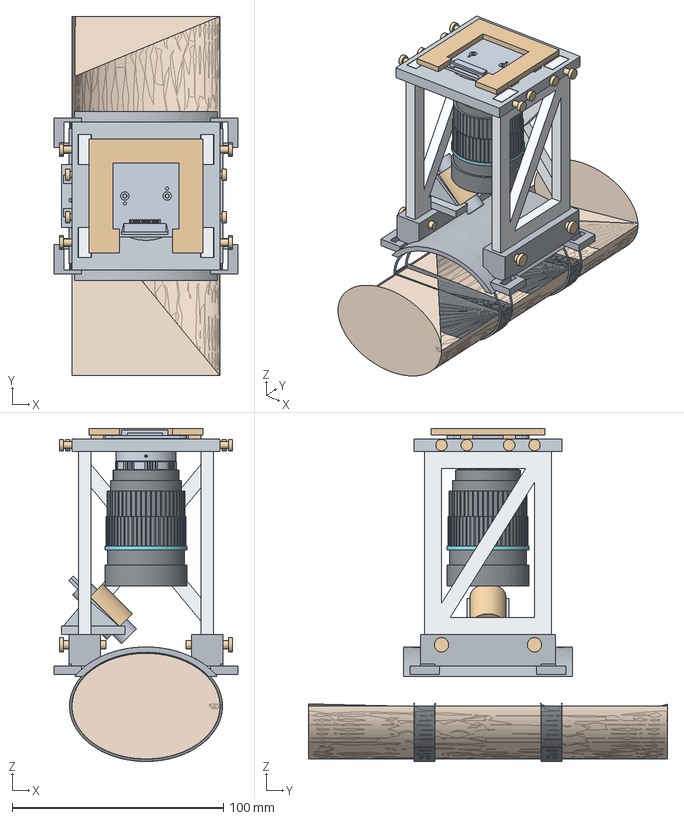
[picture p105: CAD file, 2026-11-04]
cad/15-tower-mechanical/tower-mechanical.step
87.0 x 170.0 x 157.5 mm
WristBase
BracedFrame
CameraPlate
CameraRetainer
BasePin-1_0
PlatePin-1_0
BasePin-1_1
PlatePin-1_1
RetainerPin-1_0
RetainerPin-1_1
BasePin1_0
PlatePin1_0
BasePin1_1
PlatePin1_1
RetainerPin1_0
RetainerPin1_1
LaserBracket
LaserCap
CAdapterEnvelope
LensRearBody
ApertureRing
FocusRing
BlueTrim
FrontBarrel
FrontRim
FrontGlass
ArmReference
Strap0
Strap1
