ebf-hue/mini-scos/cad/16-tower-dovetail/bambu/one-plate-input.3mf

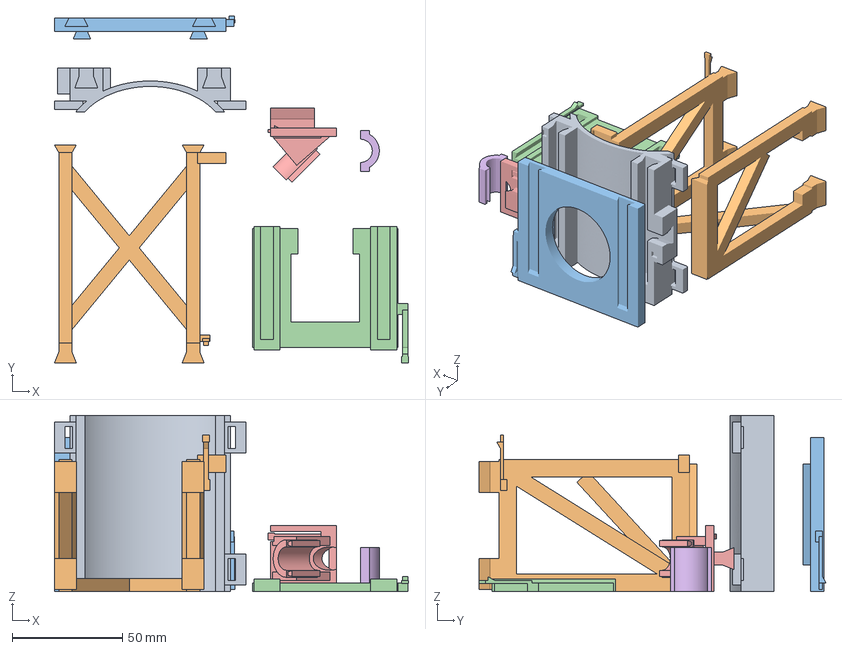
[picture p106: CAD file, 2026-11-04]
cad/16-tower-dovetail/bambu/one-plate-input.3mf
160.8 x 157.5 x 80.0 mm
WristBase
BracedFrame
CameraPlate
CameraRetainer
LaserBracket
LaserCap
