ebf-hue/mini-scos/cad/16-tower-dovetail/bambu/oriented/LaserCap.stl

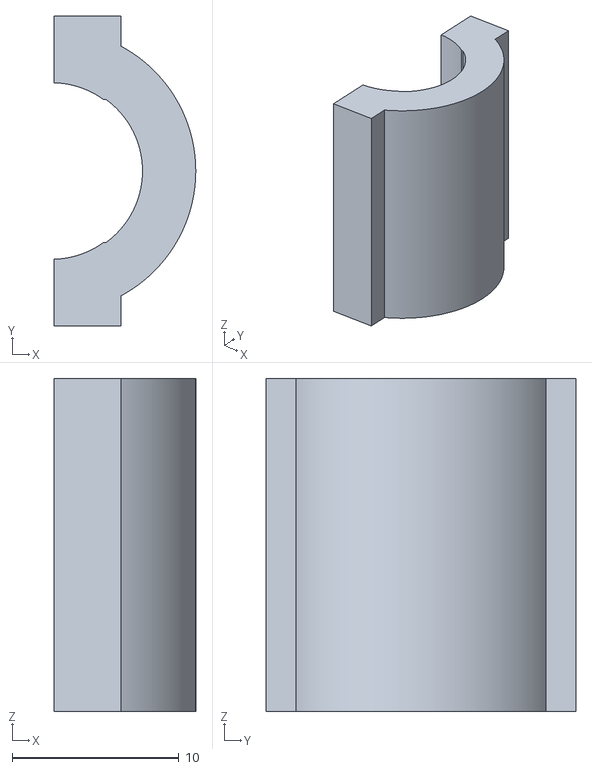
[picture p107: CAD file, 2026-11-04]
cad/16-tower-dovetail/bambu/oriented/LaserCap.stl
8.50 x 18.6 x 20.0
