ebf-hue/mini-scos/cad/16-tower-dovetail/fit-coupon/FemaleRailAndCatch.step

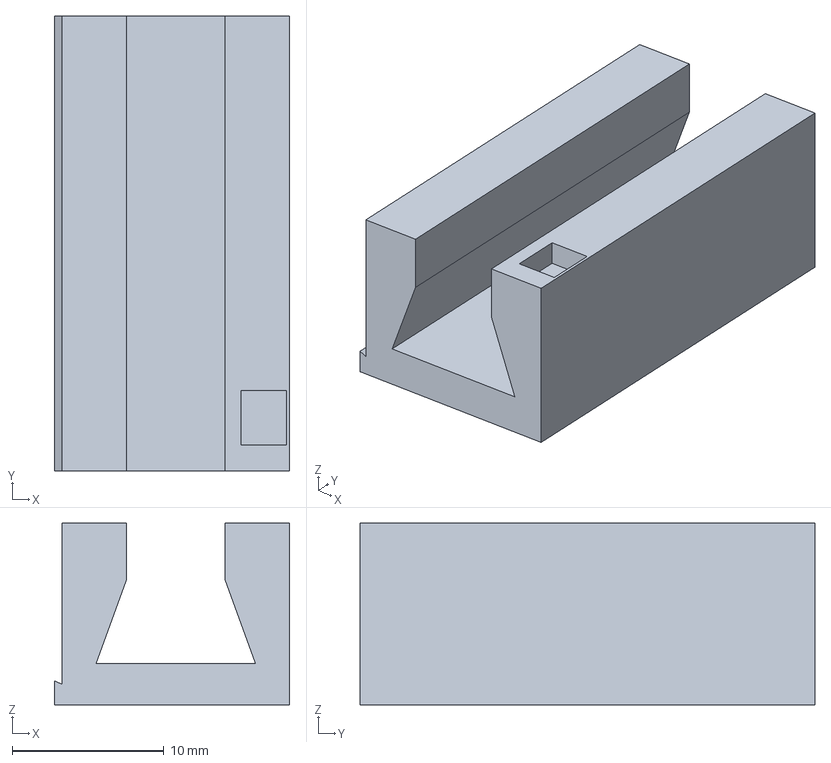
[picture p108: CAD file, 2026-11-04]
cad/16-tower-dovetail/fit-coupon/FemaleRailAndCatch.step
15.5 x 30.0 x 12.0 mm
