ebf-hue/mini-scos/cad/16-tower-dovetail/parts/CameraPlate.step

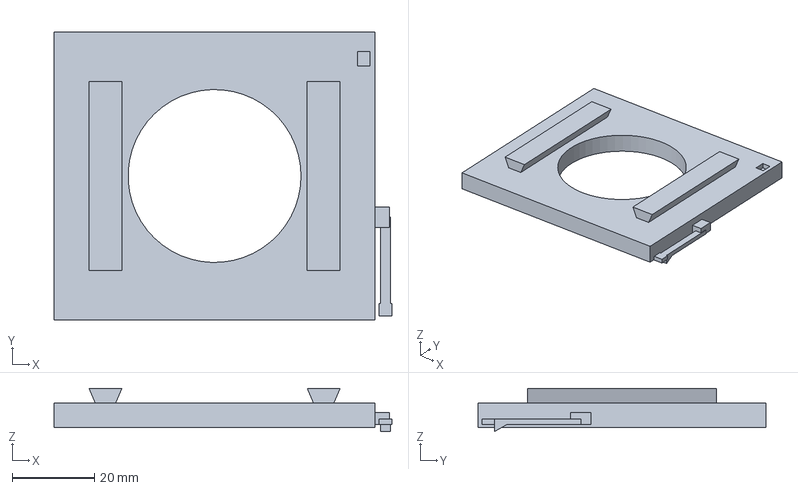
[picture p109: CAD file, 2026-11-04]
cad/16-tower-dovetail/parts/CameraPlate.step
82.1 x 70.0 x 10.5 mm
