ebf-hue/mini-scos/cad/16-tower-dovetail/tower-dovetail.step

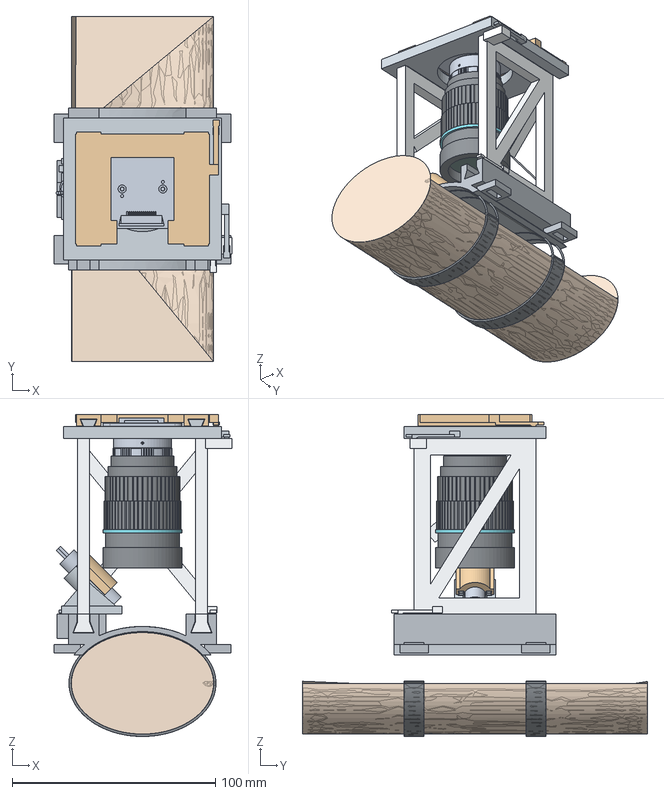
[picture p110: CAD file, 2026-11-04]
cad/16-tower-dovetail/tower-dovetail.step
87.5 x 170.0 x 158.5 mm
WristBase
BracedFrame
CameraPlate
CameraRetainer
LaserBracket
LaserCap
CAdapterEnvelope
LensRearBody
ApertureRing
FocusRing
BlueTrim
FrontBarrel
FrontRim
FrontGlass
ArmReference
Strap0
Strap1
