ebf-hue/mini-scos/cad/17-tower-open-optics/before-headers/CameraRetainer.step

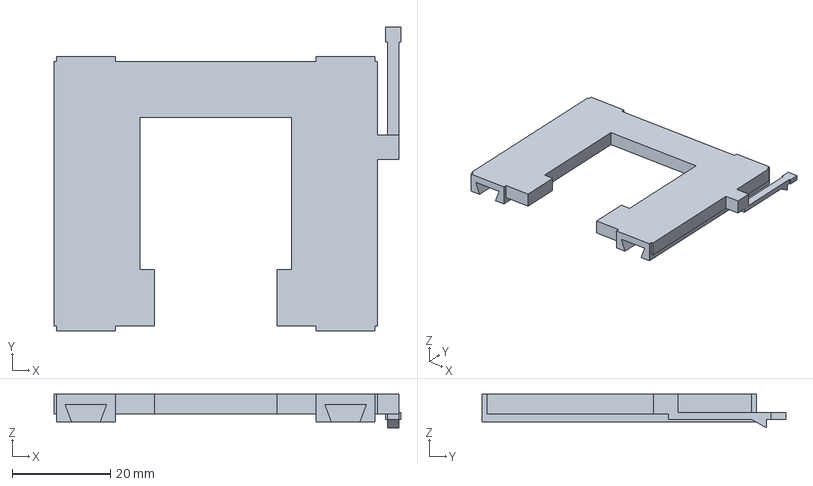
[picture p111: CAD file, 2026-11-04]
cad/17-tower-open-optics/before-headers/CameraRetainer.step
70.8 x 62.0 x 6.85 mm
