ebf-hue/mini-scos/cad/17-tower-open-optics/before-wrap/CameraRetainer.step

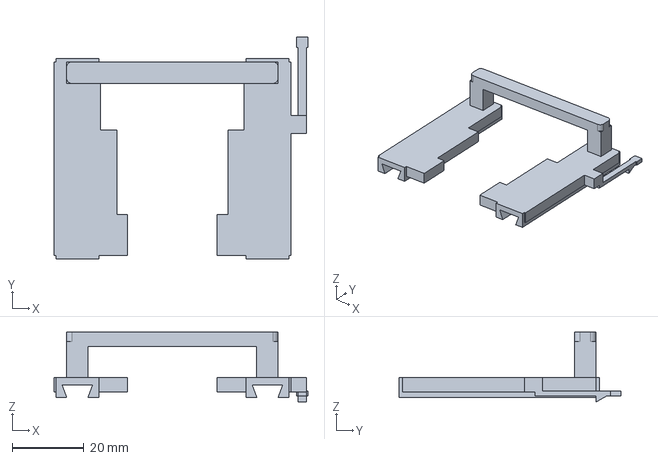
[picture p112: CAD file, 2026-11-04]
cad/17-tower-open-optics/before-wrap/CameraRetainer.step
70.8 x 62.0 x 19.5 mm
