ebf-hue/mini-scos/cad/17-tower-open-optics/camera-retention-section.step

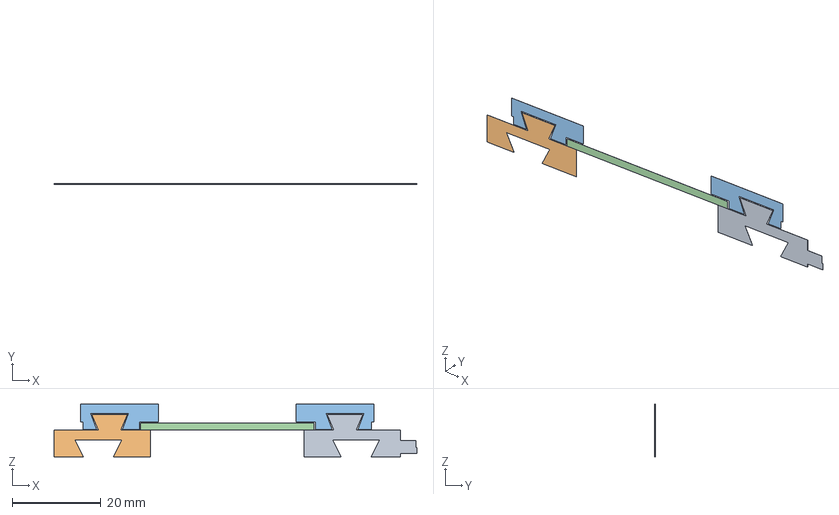
[picture p113: CAD file, 2026-11-04]
cad/17-tower-open-optics/camera-retention-section.step
81.7 x 0.02 x 11.8 mm
