ebf-hue/mini-scos/cad/17-tower-open-optics/guides/CameraClearance.step

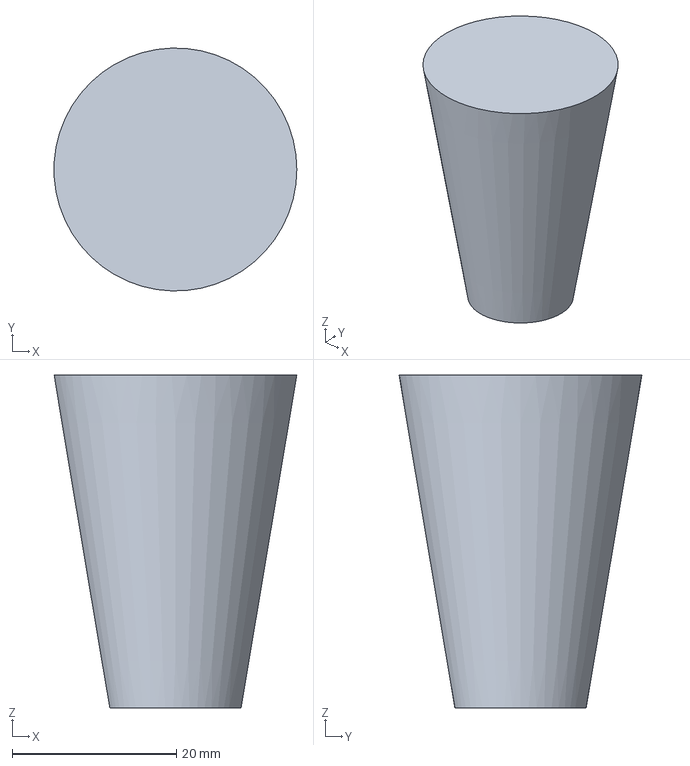
[picture p114: CAD file, 2026-11-04]
cad/17-tower-open-optics/guides/CameraClearance.step
29.6 x 29.6 x 40.6 mm
