ebf-hue/mini-scos/cad/17-tower-open-optics/sources/imx296-with-headers-estimated.step

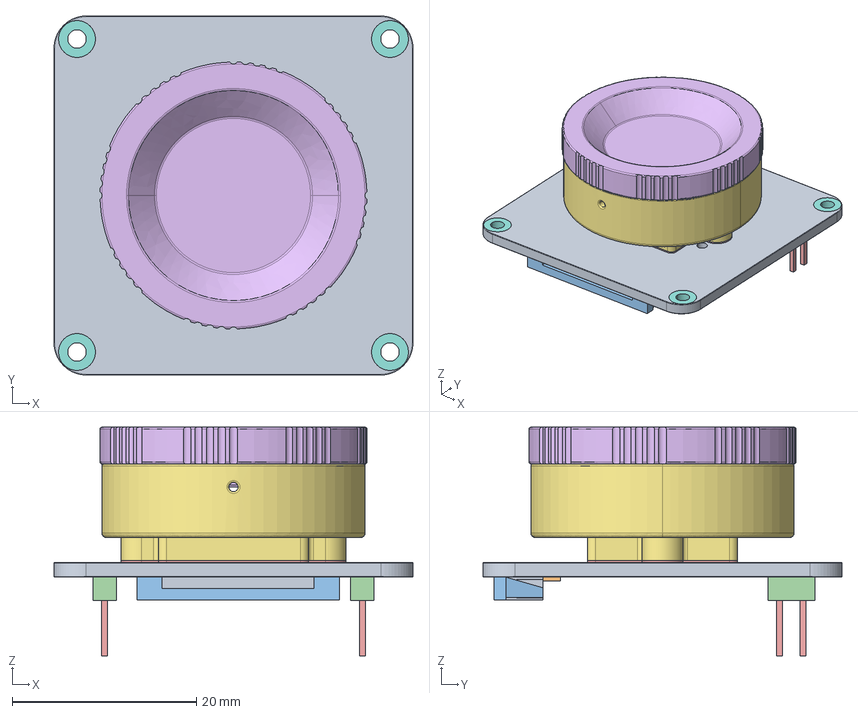
[picture p115: CAD file, 2026-11-04]
cad/17-tower-open-optics/sources/imx296-with-headers-estimated.step
39.0 x 39.0 x 24.8 mm
