ebf-hue/mini-scos/cad/17-tower-open-optics/sources/lens-visual/FrontBarrel.step

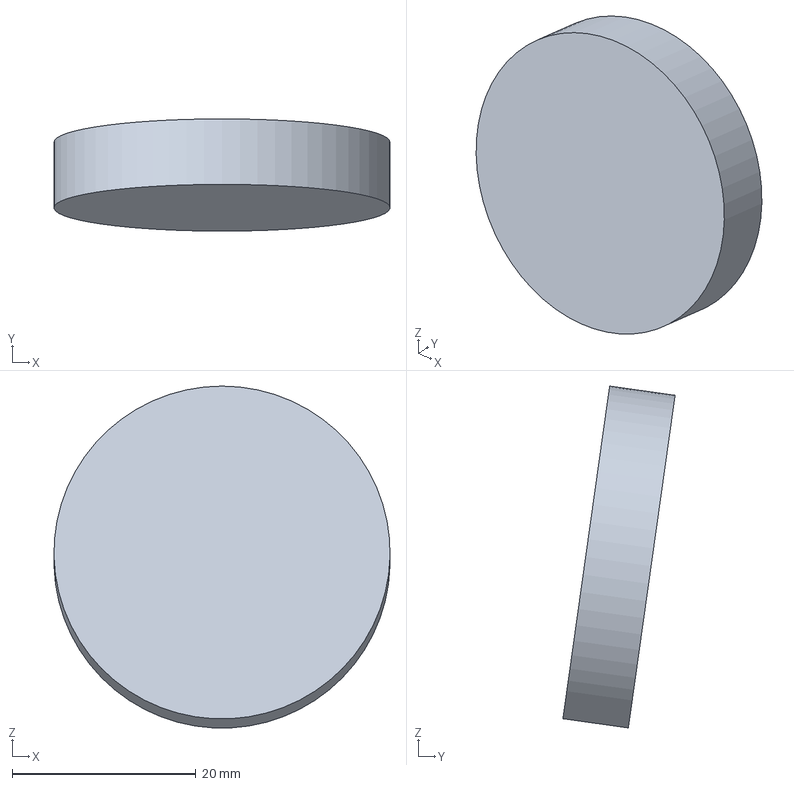
[picture p116: CAD file, 2026-11-04]
cad/17-tower-open-optics/sources/lens-visual/FrontBarrel.step
36.6 x 12.2 x 37.2 mm
