ebf-hue/mini-scos/cad/18-tower-recessed-clips/parts/LensRearBody.step

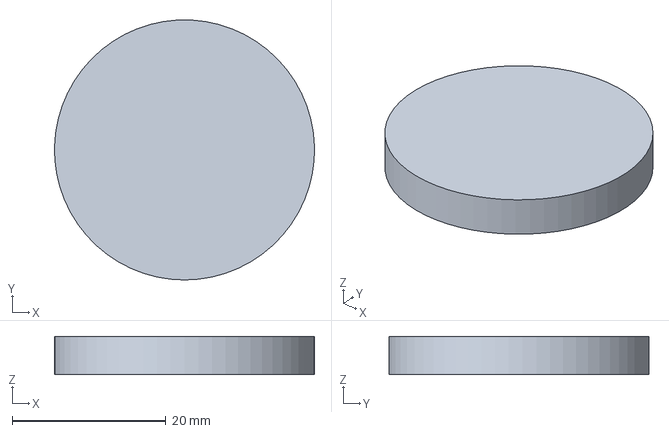
[picture p117: CAD file, 2026-11-04]
cad/18-tower-recessed-clips/parts/LensRearBody.step
33.8 x 33.8 x 5.00 mm
