ebf-hue/mini-scos/cad/18-tower-recessed-clips/tower-recessed-clips.step

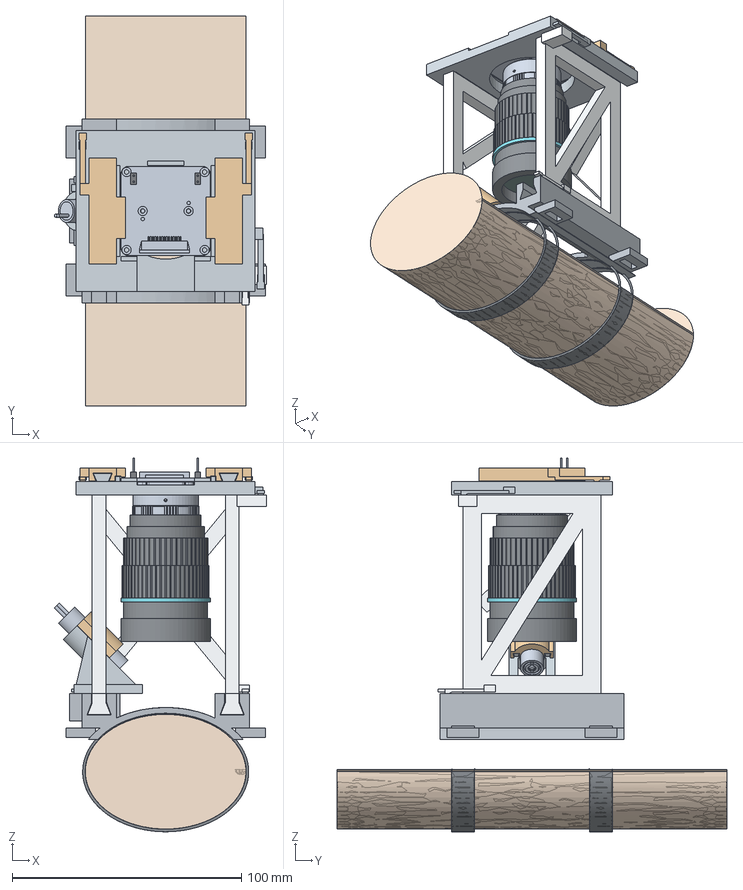
[picture p118: CAD file, 2026-11-04]
cad/18-tower-recessed-clips/tower-recessed-clips.step
92.5 x 170.0 x 162.8 mm
WristBase
BracedFrame
CameraPlate
CameraClipRight
CameraClipLeft
LaserBracket
LaserCap
TriggerJ3Housing
StrobeJ2Housing
CAdapterEnvelope
LensRearBody
ApertureRing
FocusRing
BlueTrim
FrontBarrel
FrontRim
FrontGlass
ArmReference
Strap0
Strap1
