ebf-hue/mini-scos/cad/19-camera-tray/bambu/one-plate-input.3mf

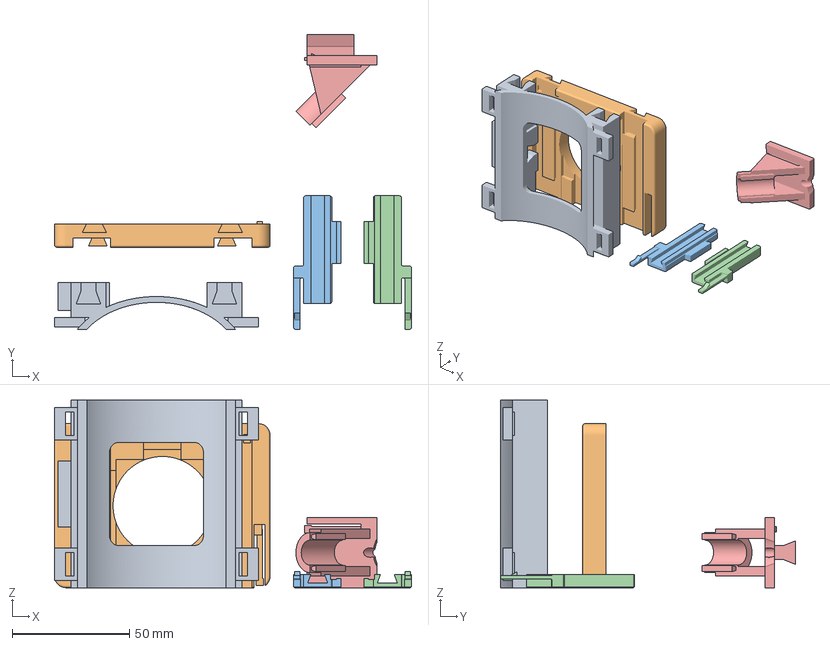
[picture p119: CAD file, 2026-11-04]
cad/19-camera-tray/bambu/one-plate-input.3mf
152.3 x 125.7 x 80.0 mm
WristBase
CameraPlate
CameraClipLeft
CameraClipRight
LaserBracket
