ebf-hue/mini-scos/cad/19-camera-tray/bambu/oriented/CameraPlate.stl

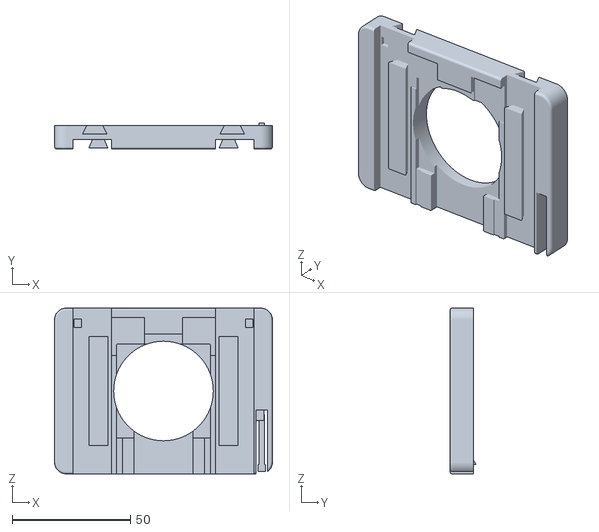
[picture p120: CAD file, 2026-11-04]
cad/19-camera-tray/bambu/oriented/CameraPlate.stl
92.0 x 11.0 x 70.0
