ebf-hue/mini-scos/cad/19-camera-tray/camera-tray.step

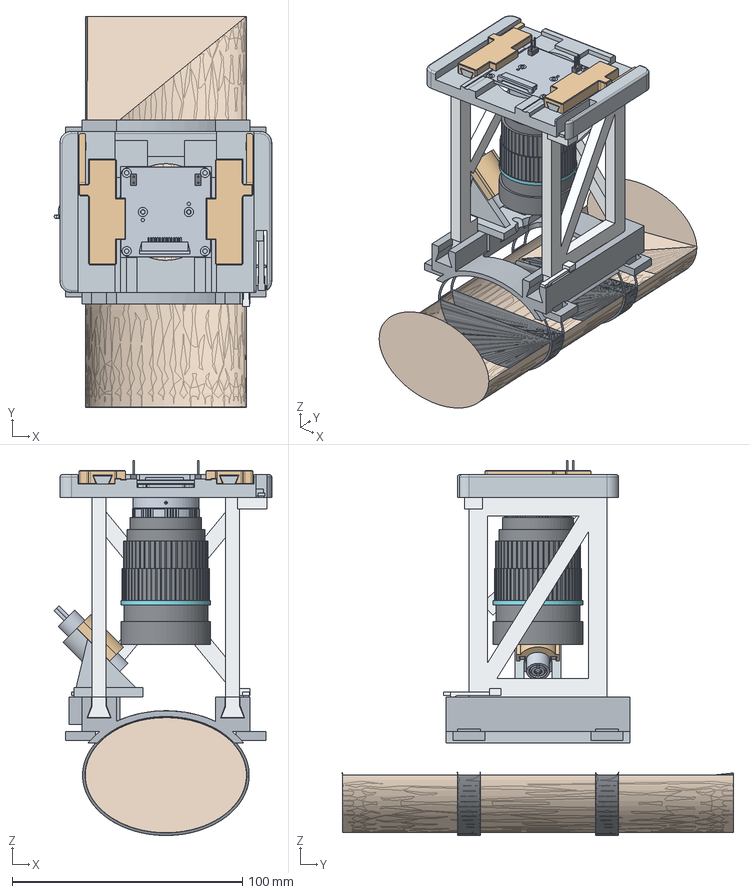
[picture p121: CAD file, 2026-11-04]
cad/19-camera-tray/camera-tray.step
94.5 x 170.0 x 162.8 mm
WristBase
BracedFrame
CameraPlate
CameraClipRight
CameraClipLeft
LaserBracket
LaserCap
TriggerJ3Housing
StrobeJ2Housing
CAdapterEnvelope
LensRearBody
ApertureRing
FocusRing
BlueTrim
FrontBarrel
FrontRim
FrontGlass
ArmReference
Strap0
Strap1
