ebf-hue/mini-scos/cad/19-camera-tray/inspection/StrobeJ2Housing.step

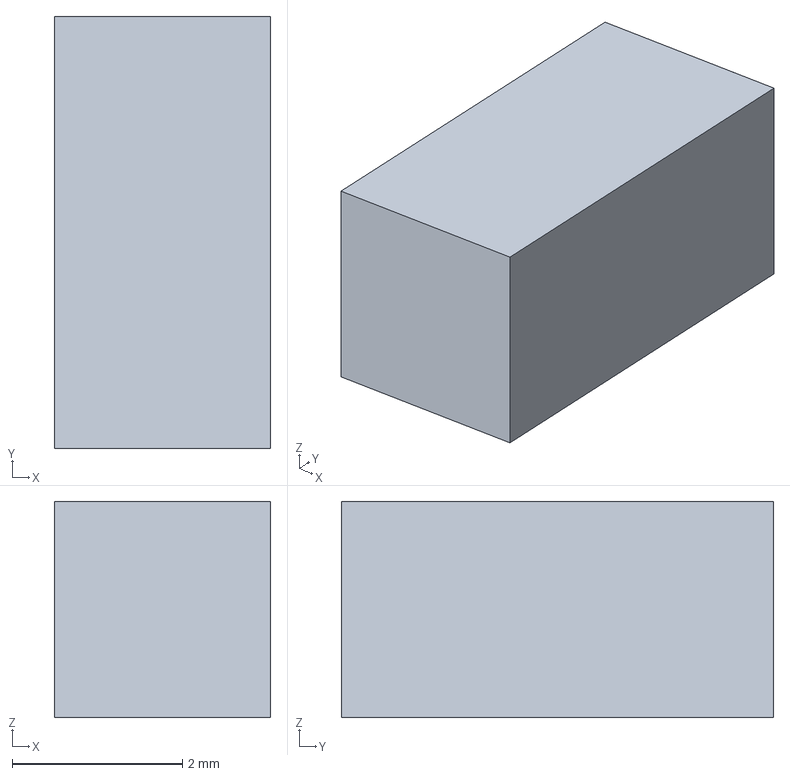
[picture p122: CAD file, 2026-11-04]
cad/19-camera-tray/inspection/StrobeJ2Housing.step
2.54 x 5.08 x 2.54 mm
