ebf-hue/mini-scos/cad/19-camera-tray/parts/FrontBarrel.step

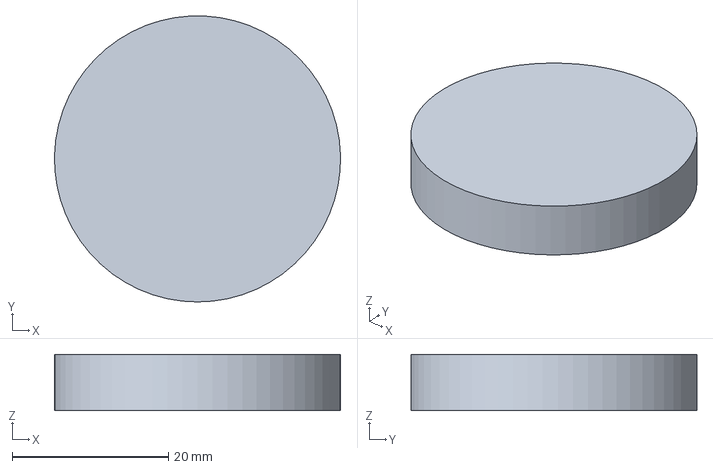
[picture p123: CAD file, 2026-11-04]
cad/19-camera-tray/parts/FrontBarrel.step
36.6 x 36.6 x 7.20 mm
