ebf-hue/mini-scos/cad/bench-fixture/exports/laser_fit_coupon.step

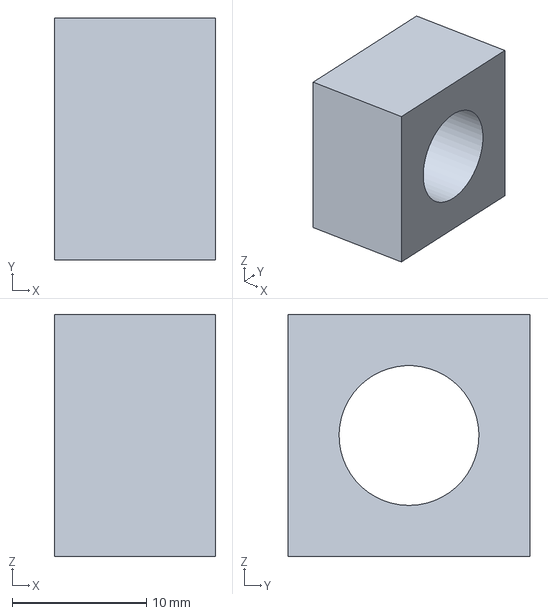
[picture p124: CAD file, 2026-10-19]
cad/bench-fixture/exports/laser_fit_coupon.step
12.0 x 18.0 x 18.0 mm
