ebf-hue/mini-scos/cad/experiments/halloween-monster/monster-attachment.step

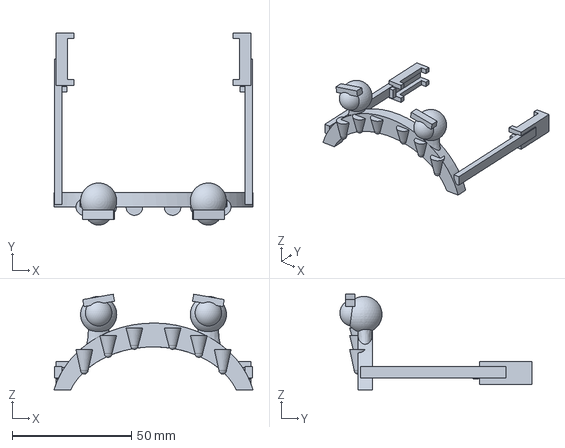
[picture p125: CAD file, 2026-11-04]
cad/experiments/halloween-monster/monster-attachment.step
83.4 x 80.6 x 40.1 mm
