ebf-hue/mini-scos/cad/experiments/halloween-monster/parts/Pupils.step

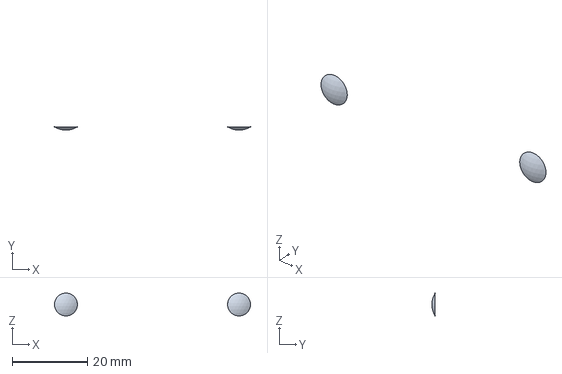
[picture p126: CAD file, 2026-11-04]
cad/experiments/halloween-monster/parts/Pupils.step
52.1 x 0.881 x 6.08 mm
