ebf-hue/mini-scos/cad/experiments/halloween-sculpt/meshes/SkinAndMount.ply

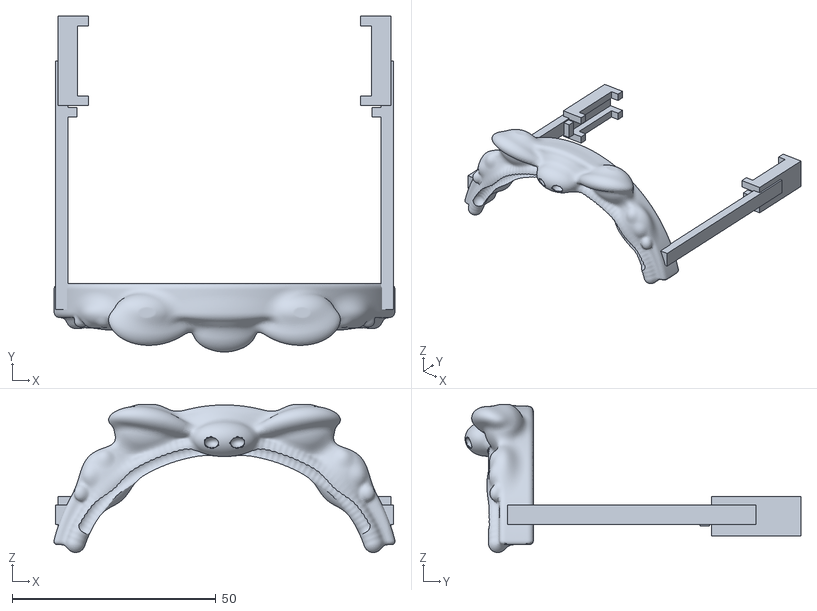
[picture p127: CAD file, 2026-11-04]
cad/experiments/halloween-sculpt/meshes/SkinAndMount.ply
83.6 x 82.4 x 36.3
