ebf-hue/mini-scos/cad/experiments/halloween-sculpt/monster-attachment.stl

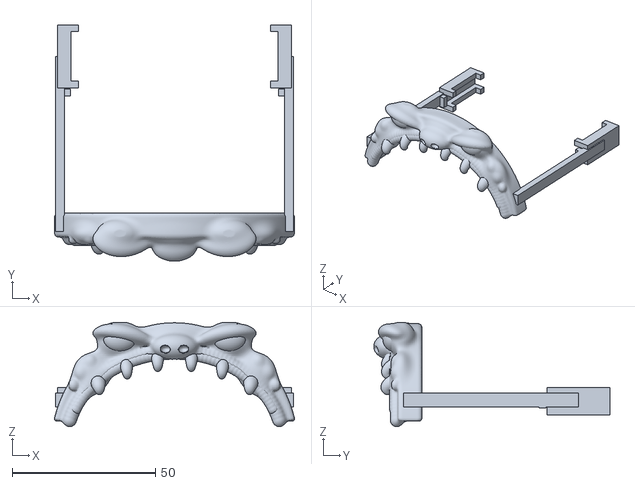
[picture p128: CAD file, 2026-11-04]
cad/experiments/halloween-sculpt/monster-attachment.stl
83.6 x 82.4 x 36.3
