ebf-hue/mini-scos/cad/experiments/halloween-sculpt/print/monster-four-colour.3mf

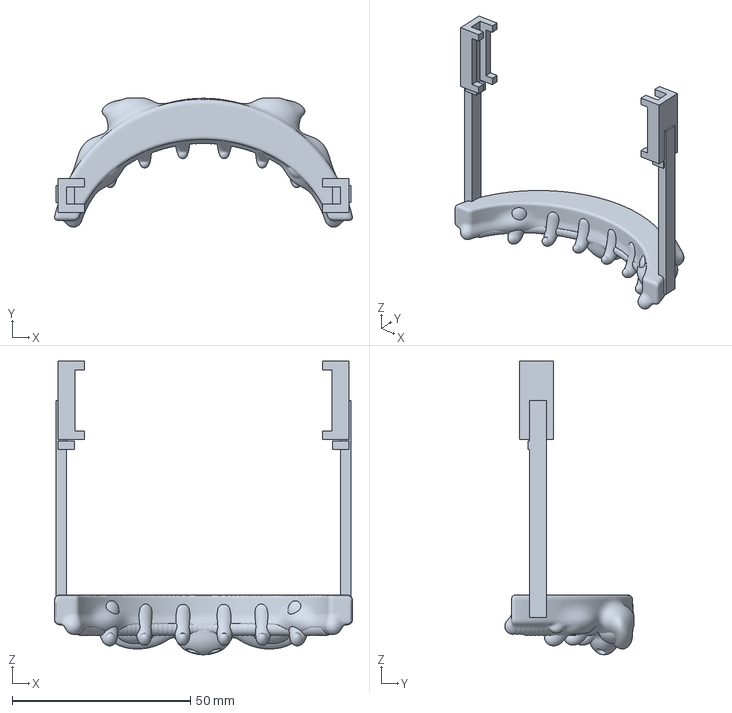
[picture p129: CAD file, 2026-11-04]
cad/experiments/halloween-sculpt/print/monster-four-colour.3mf
83.6 x 36.3 x 82.4 mm
