ebf-hue/mini-scos/cad/experiments/surface-blend-work/test.stl

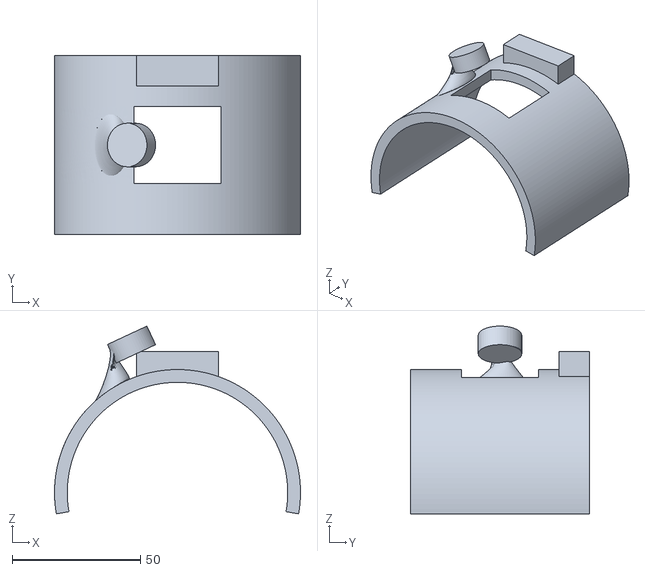
[picture p130: CAD file, 2026-11-04]
cad/experiments/surface-blend-work/test.stl
96.0 x 70.0 x 73.3
