ebf-hue/mini-scos/cad/tower-dovetail/fit-coupon/MaleRailAndLatch.stl

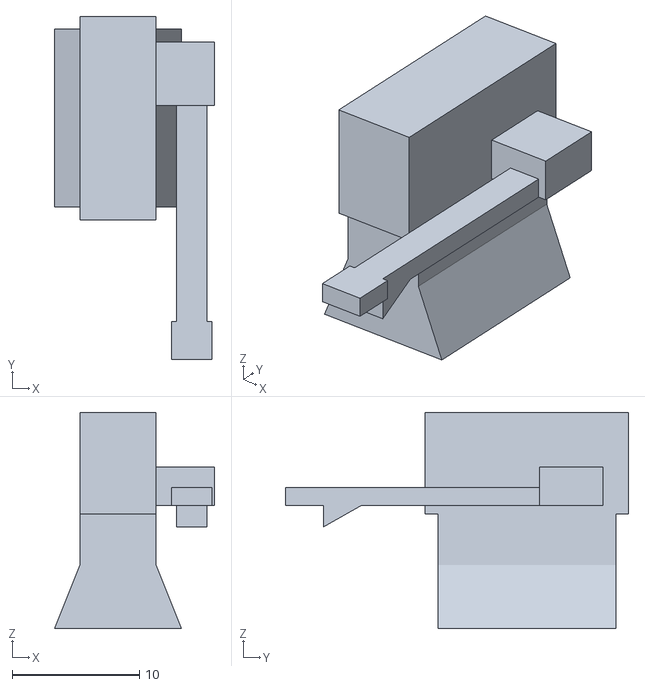
[picture p131: CAD file, 2026-11-04]
cad/tower-dovetail/fit-coupon/MaleRailAndLatch.stl
12.6 x 27.0 x 17.0
