ebf-hue/mini-scos/cad/tower-dovetail/sources/lens-visual/FocusRing.step

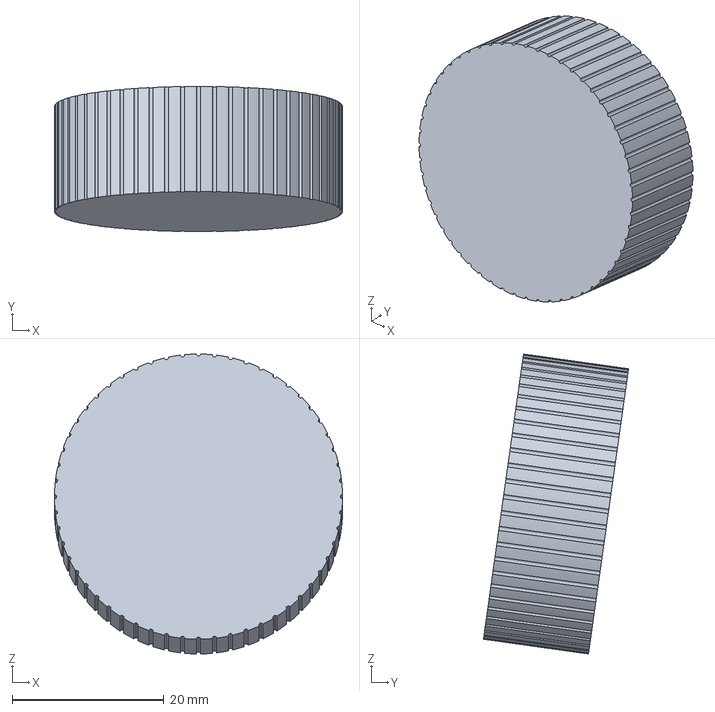
[picture p132: CAD file, 2026-11-04]
cad/tower-dovetail/sources/lens-visual/FocusRing.step
38.0 x 19.2 x 39.6 mm
