ebf-hue/mini-scos/cad/wrist-architecture/parts/LaserCap.step

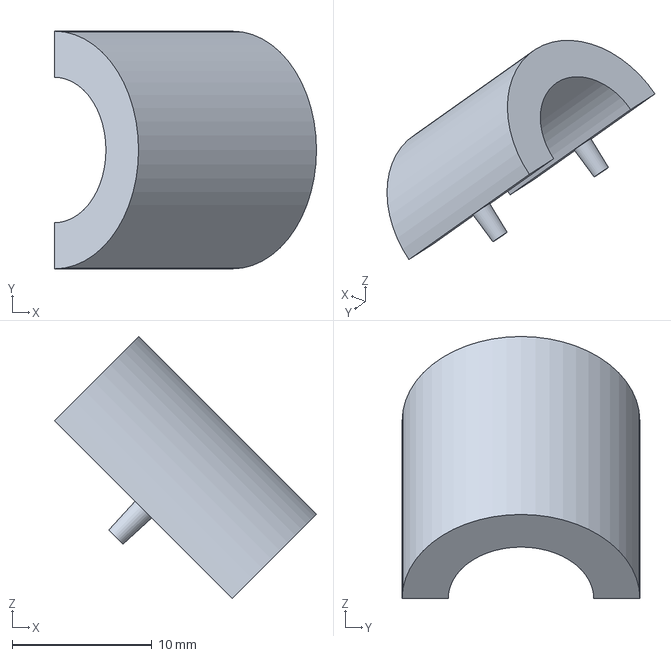
[picture p133: CAD file, 2026-11-04]
cad/wrist-architecture/parts/LaserCap.step
18.7 x 17.0 x 18.7 mm
