ebf-hue/mini-scos/cad/02-arm-cuff-concept/exports/optical_pod.step

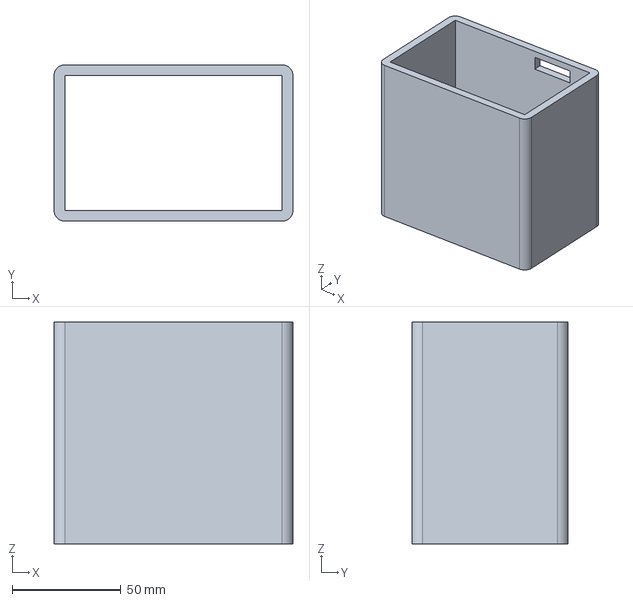
[picture p134: CAD file, 2026-11-04]
cad/02-arm-cuff-concept/exports/optical_pod.step
110.0 x 72.0 x 102.0 mm
