ebf-hue/mini-scos/cad/02-arm-cuff-concept/exports/v04/laser_clamp.step

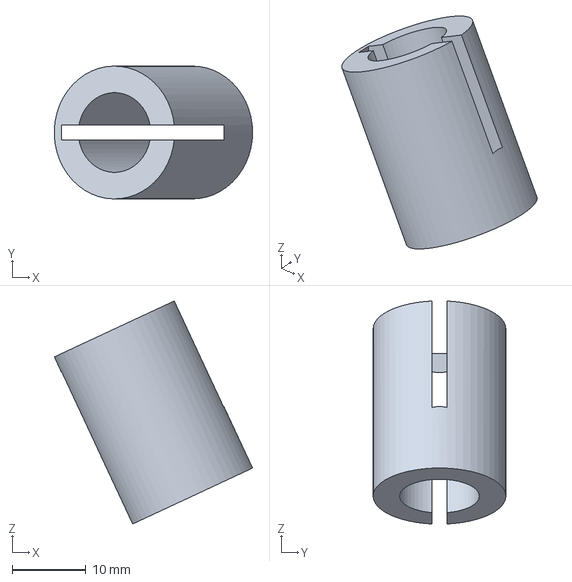
[picture p135: CAD file, 2026-11-04]
cad/02-arm-cuff-concept/exports/v04/laser_clamp.step
26.9 x 18.0 x 30.2 mm
