ebf-hue/mini-scos/cad/03-c-rest-module3/exports/laser_cap.step

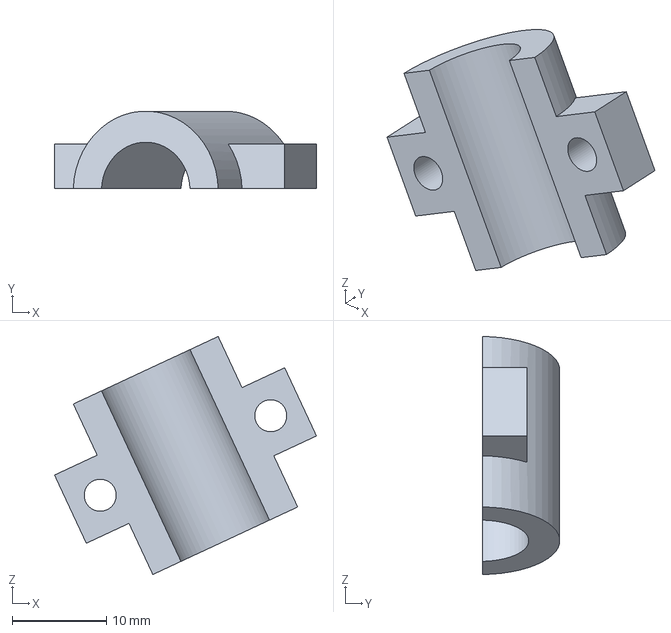
[picture p136: CAD file, 2026-11-04]
cad/03-c-rest-module3/exports/laser_cap.step
27.9 x 8.23 x 25.3 mm
