ebf-hue/mini-scos/cad/04-c-rest-printable/exports/rest.step

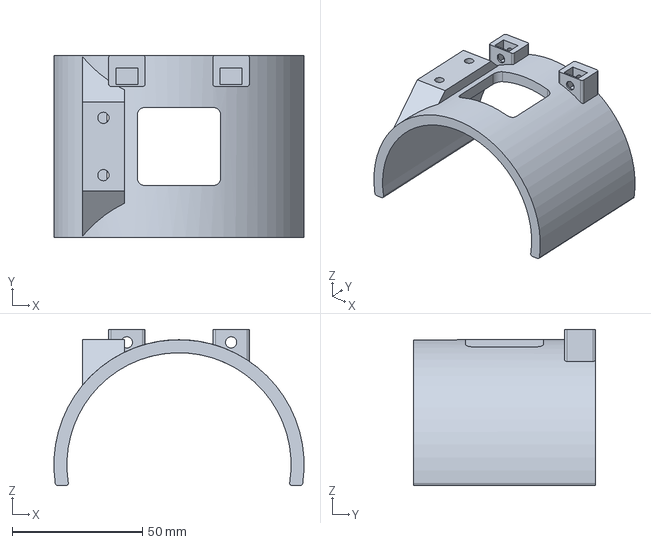
[picture p137: CAD file, 2026-11-04]
cad/04-c-rest-printable/exports/rest.step
95.9 x 70.0 x 60.0 mm
