ebf-hue/mini-scos/cad/06-solidcraft-mount-v1/bambu/oriented/SpineCamera.stl

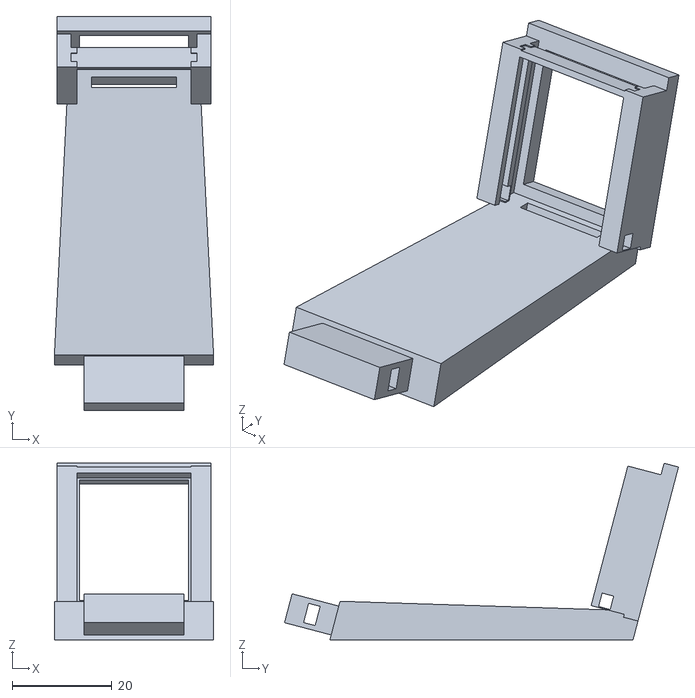
[picture p140: CAD file, 2026-11-04]
cad/06-solidcraft-mount-v1/bambu/oriented/SpineCamera.stl
32.0 x 79.2 x 35.5
