ebf-hue/mini-scos/cad/09-solidcraft-mount-v4/exports/LaserBand.stl

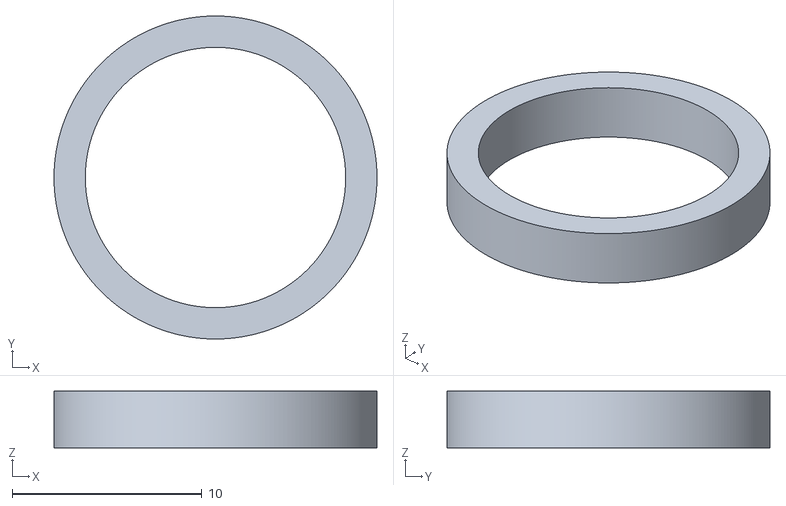
[picture p141: CAD file, 2026-11-04]
cad/09-solidcraft-mount-v4/exports/LaserBand.stl
17.0 x 17.0 x 3.00
