ebf-hue/mini-scos/cad/12-solidcraft-mount-v7/bambu/oriented/SpineCamera_standard.stl

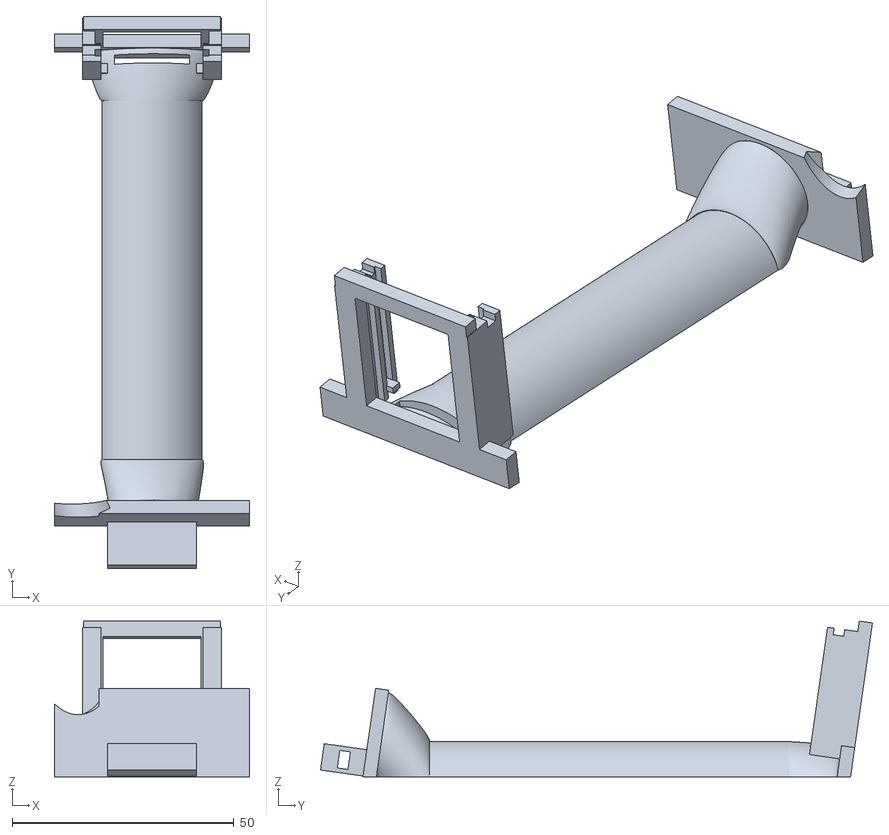
[picture p142: CAD file, 2026-11-04]
cad/12-solidcraft-mount-v7/bambu/oriented/SpineCamera_standard.stl
44.0 x 124.5 x 35.2
