ebf-hue/mini-scos/cad/12-solidcraft-mount-v7/camera_source/standard/native_camera.step

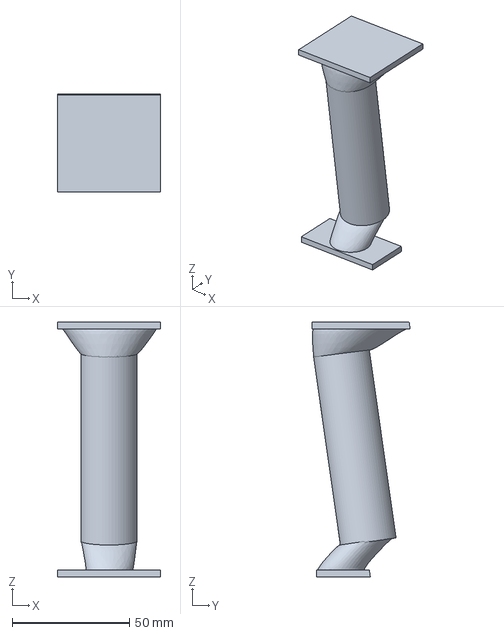
[picture p143: CAD file, 2026-11-04]
cad/12-solidcraft-mount-v7/camera_source/standard/native_camera.step
44.0 x 42.0 x 108.9 mm
