ebf-hue/mini-scos/cad/12-solidcraft-mount-v7/camera_source/wide/native_camera.step

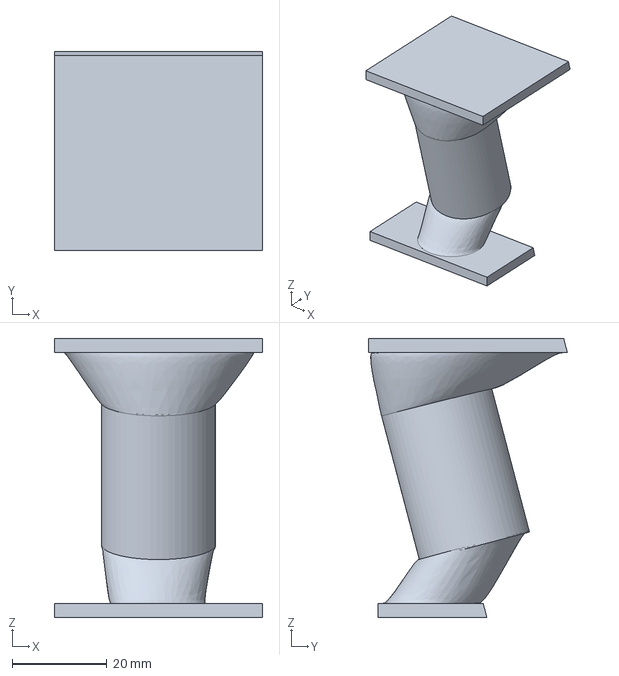
[picture p144: CAD file, 2026-11-04]
cad/12-solidcraft-mount-v7/camera_source/wide/native_camera.step
44.0 x 42.0 x 58.9 mm
