ebf-hue/mini-scos/cad/12-solidcraft-mount-v7/standard_exports/Keeper.step

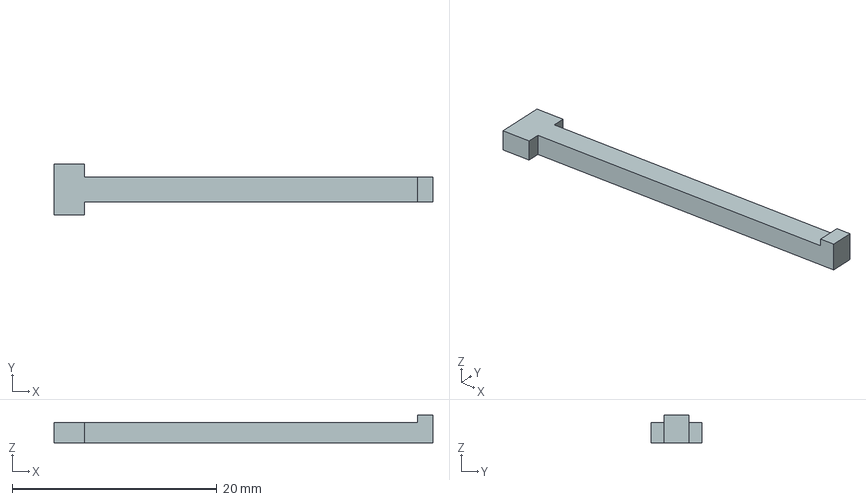
[picture p145: CAD file, 2026-11-04]
cad/12-solidcraft-mount-v7/standard_exports/Keeper.step
37.0 x 5.00 x 2.70 mm
