ebf-hue/mini-scos/cad/12-solidcraft-mount-v7/surface_source/RestBase.step

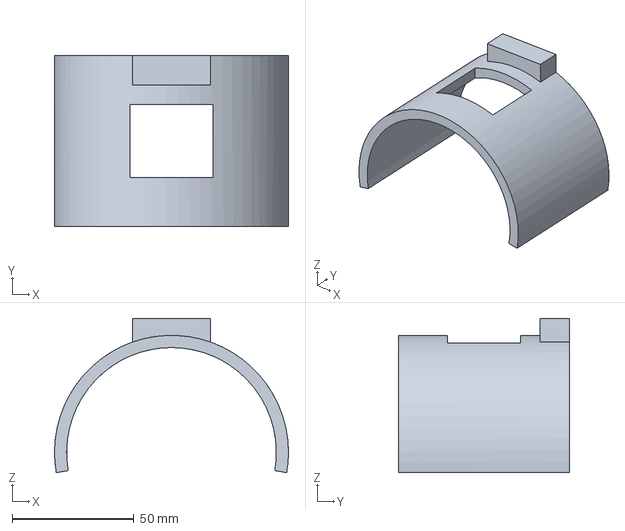
[picture p146: CAD file, 2026-11-04]
cad/12-solidcraft-mount-v7/surface_source/RestBase.step
96.0 x 70.0 x 63.3 mm
