ebf-hue/mini-scos/cad/14-wrist-architecture/bambu/oriented/LaserCap.stl

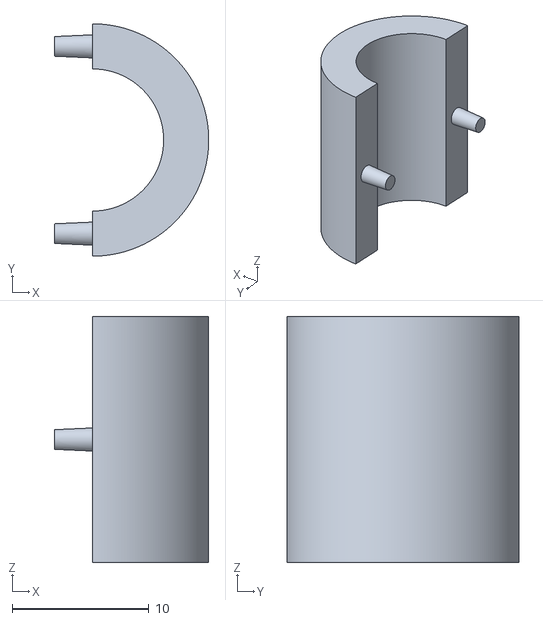
[picture p148: CAD file, 2026-11-04]
cad/14-wrist-architecture/bambu/oriented/LaserCap.stl
11.3 x 17.0 x 18.0
