ebf-hue/mini-scos/cad/14-wrist-architecture/wrist-concept.step

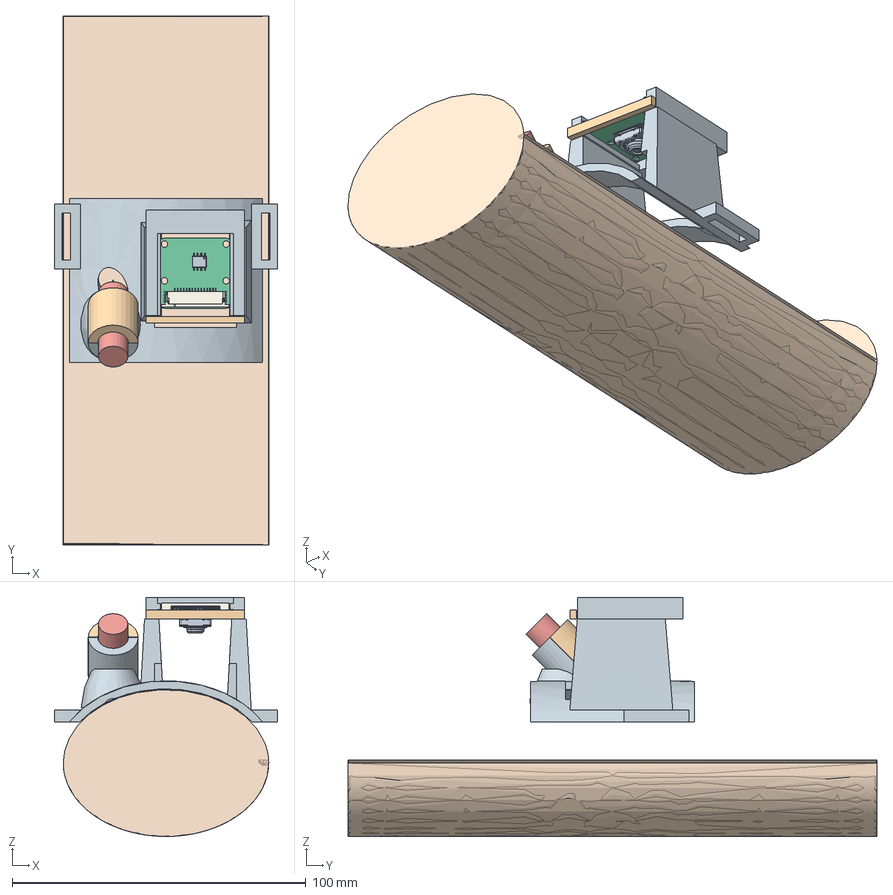
[picture p149: CAD file, 2026-11-04]
cad/14-wrist-architecture/wrist-concept.step
76.0 x 180.0 x 81.4 mm
WristSaddle
CameraKeeper
LaserCap
LaserReference
BeamReference
ArmReference
OfficialCM3_PCB
OfficialCM3_Connector
