ebf-hue/mini-scos/cad/15-tower-mechanical/parts/BlueTrim.step

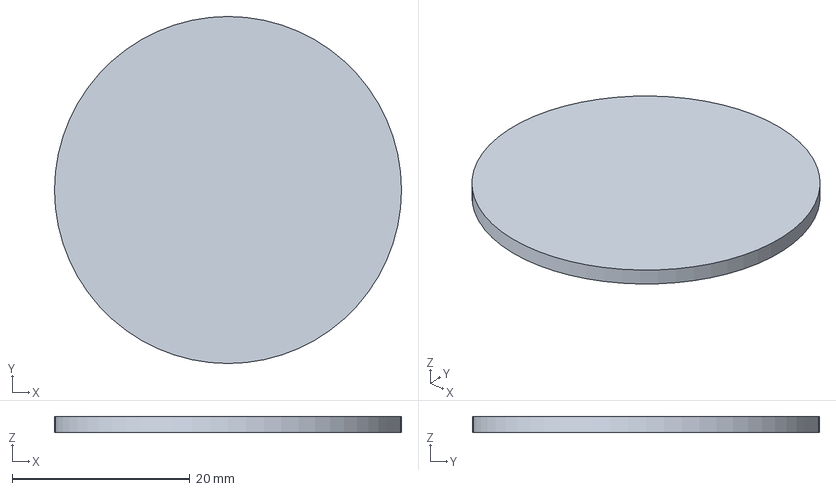
[picture p150: CAD file, 2026-11-04]
cad/15-tower-mechanical/parts/BlueTrim.step
39.0 x 39.0 x 1.80 mm
