ebf-hue/mini-scos/cad/15-tower-mechanical/sources/lens-visual/LensRearBody.step

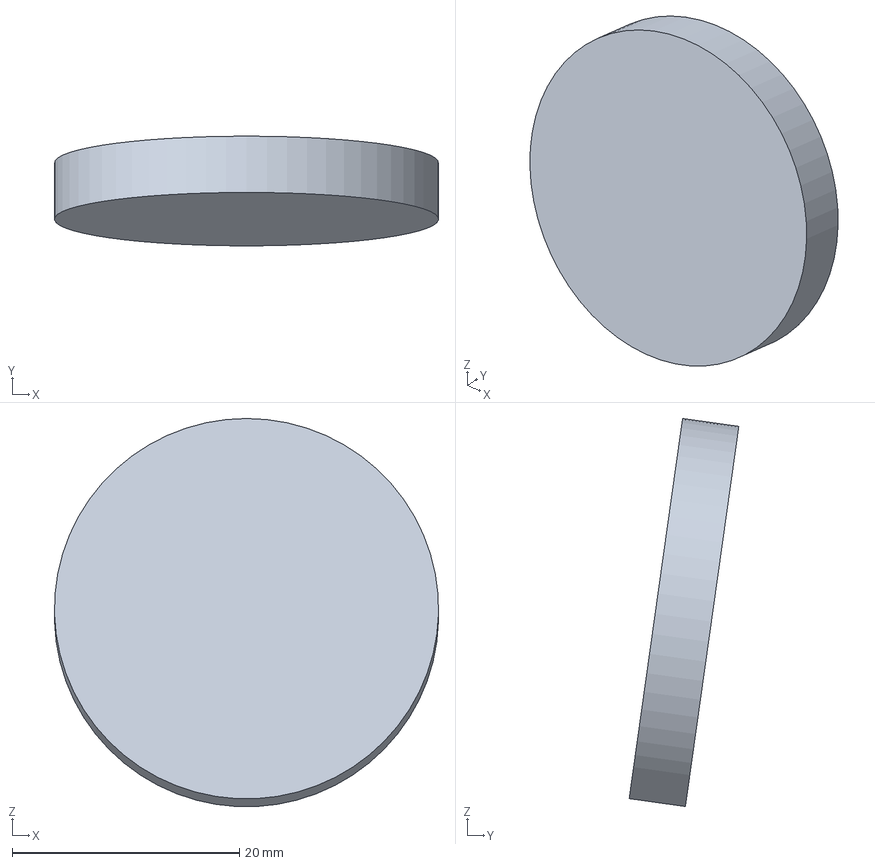
[picture p151: CAD file, 2026-11-04]
cad/15-tower-mechanical/sources/lens-visual/LensRearBody.step
33.8 x 9.65 x 34.1 mm
