ebf-hue/mini-scos/cad/16-tower-dovetail/bambu/oriented/BracedFrame.stl

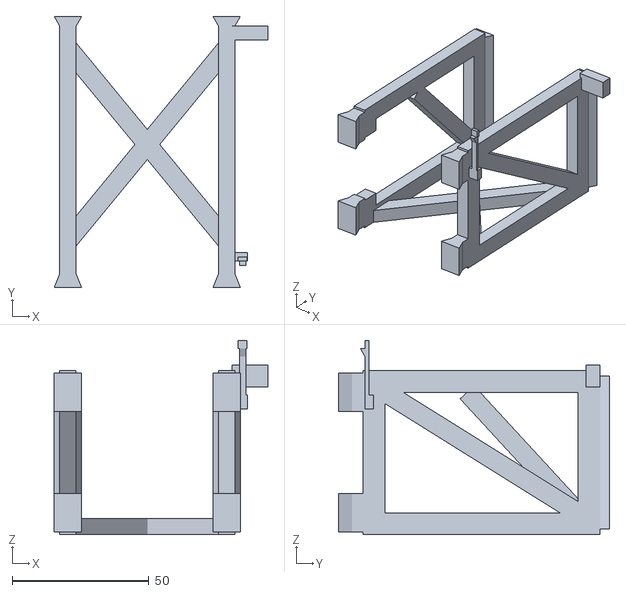
[picture p152: CAD file, 2026-11-04]
cad/16-tower-dovetail/bambu/oriented/BracedFrame.stl
78.0 x 99.0 x 71.0
