ebf-hue/mini-scos/cad/16-tower-dovetail/parts/FrontGlass.step

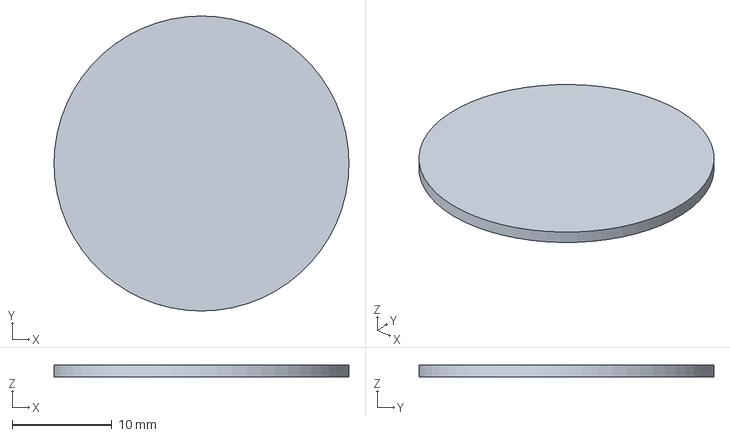
[picture p153: CAD file, 2026-11-04]
cad/16-tower-dovetail/parts/FrontGlass.step
29.6 x 29.6 x 1.20 mm
