ebf-hue/mini-scos/cad/17-tower-open-optics/guides/LaserCenterline.step

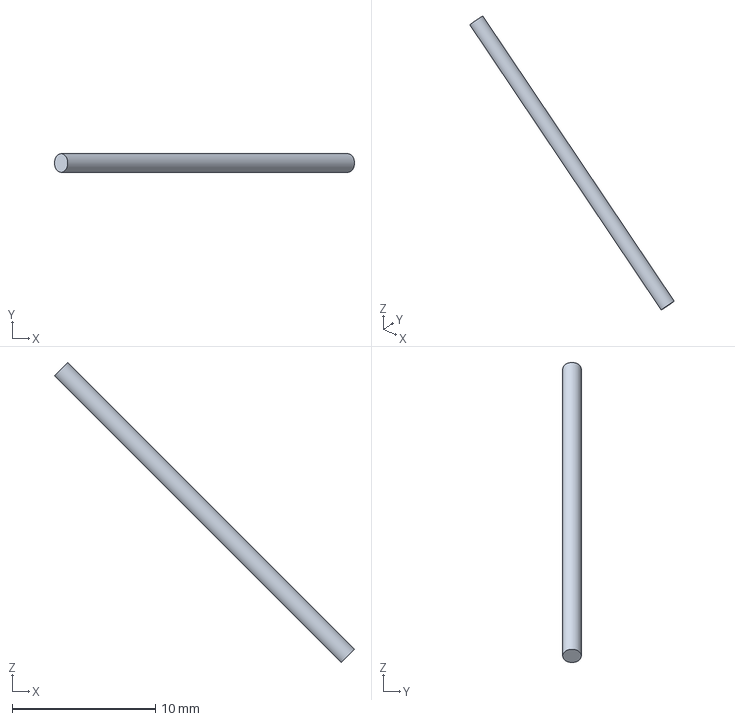
[picture p154: CAD file, 2026-11-04]
cad/17-tower-open-optics/guides/LaserCenterline.step
20.9 x 1.30 x 20.9 mm
