ebf-hue/mini-scos/cad/17-tower-open-optics/tower-open-optics.step

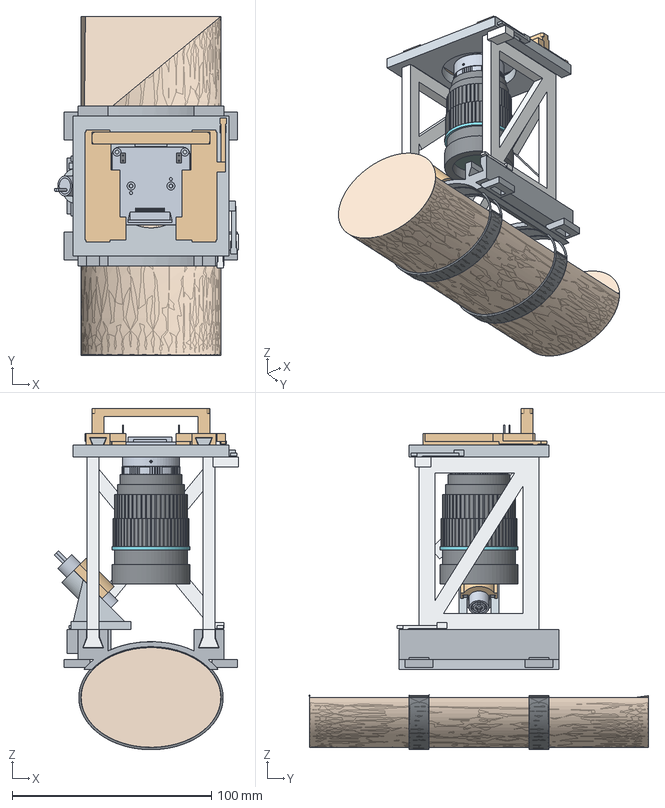
[picture p155: CAD file, 2026-11-04]
cad/17-tower-open-optics/tower-open-optics.step
92.5 x 170.0 x 171.2 mm
WristBase
BracedFrame
CameraPlate
CameraRetainer
LaserBracket
LaserCap
TriggerJ3Housing
StrobeJ2Housing
CAdapterEnvelope
LensRearBody
ApertureRing
FocusRing
BlueTrim
FrontBarrel
FrontRim
FrontGlass
ArmReference
Strap0
Strap1
