ebf-hue/mini-scos/cad/18-tower-recessed-clips/inspection/ApertureRing.step

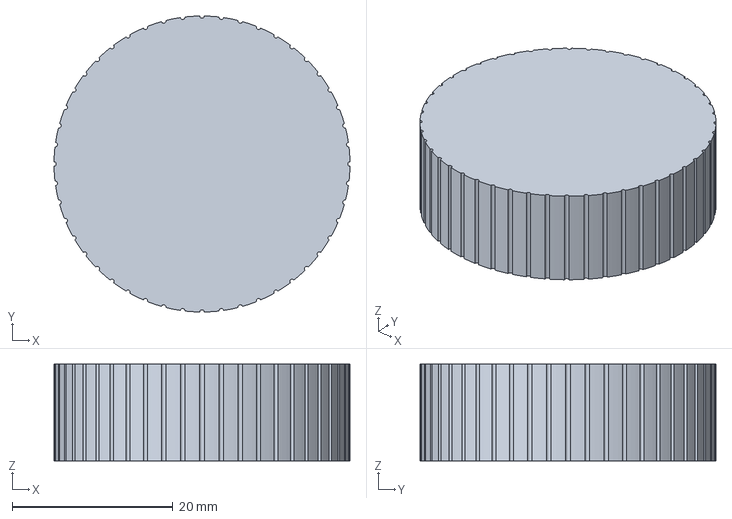
[picture p156: CAD file, 2026-11-04]
cad/18-tower-recessed-clips/inspection/ApertureRing.step
36.8 x 36.8 x 12.0 mm
