ebf-hue/mini-scos/cad/18-tower-recessed-clips/parts/LaserBracket.step

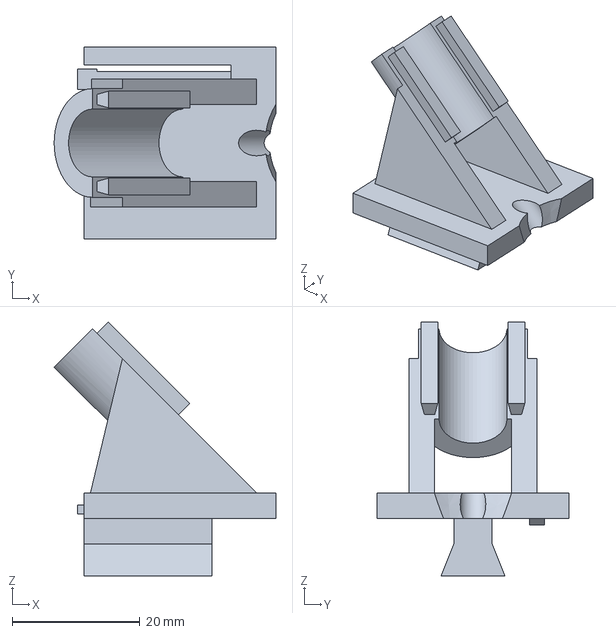
[picture p157: CAD file, 2026-11-04]
cad/18-tower-recessed-clips/parts/LaserBracket.step
34.7 x 30.0 x 39.7 mm
