ebf-hue/mini-scos/cad/19-camera-tray/bambu/oriented/WristBase.stl

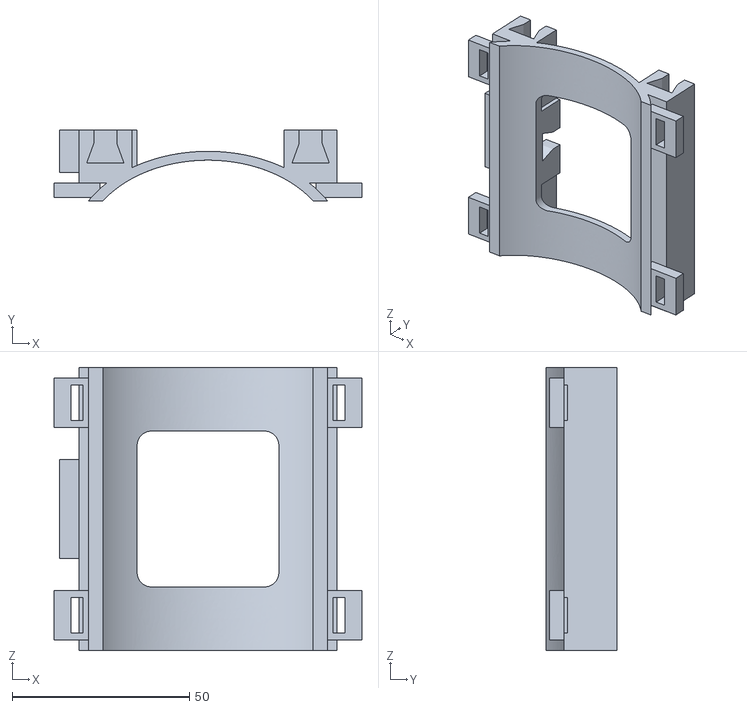
[picture p158: CAD file, 2026-11-04]
cad/19-camera-tray/bambu/oriented/WristBase.stl
87.0 x 20.0 x 80.0
