ebf-hue/mini-scos/(list of files, cad)

Other CAD files:
cad/06-solidcraft-mount-v1/exports/assembly_wide.step
cad/07-solidcraft-mount-v2/exports/assembly_standard.step
cad/08-solidcraft-mount-v3/exports/assembly_standard.step
cad/09-solidcraft-mount-v4/exports/assembly_wide.step
cad/08-solidcraft-mount-v3/exports/assembly_wide.step
cad/09-solidcraft-mount-v4/exports/assembly_standard.step
cad/12-solidcraft-mount-v7/exports/assembly_wide.step
cad/11-solidcraft-mount-v6/exports/assembly_standard.step
cad/02-arm-cuff-concept/exports/v04/filter_frame.step
cad/08-solidcraft-mount-v3/bambu/mount_standard/mount_standard.3mf
cad/08-solidcraft-mount-v3/bambu/mount_standard_single/layout.3mf
cad/08-solidcraft-mount-v3/bambu/mount_wide/mount_wide.3mf
cad/08-solidcraft-mount-v3/bambu/mount_wide_single/layout.3mf
cad/08-solidcraft-mount-v3/bambu/oriented/SpineCamera_standard.stl
cad/11-solidcraft-mount-v6/bambu/mount_standard/mount_standard.3mf
cad/11-solidcraft-mount-v6/bambu/mount_standard_single/mount_standard_single.3mf
cad/11-solidcraft-mount-v6/bambu/mount_wide/mount_wide.3mf
cad/11-solidcraft-mount-v6/bambu/mount_wide_single/layout.3mf
cad/11-solidcraft-mount-v6/exports/SpineCamera_standard.stl
cad/11-solidcraft-mount-v6/surface_source/RestFinished.step
cad/12-solidcraft-mount-v7/bambu/mount_standard/mount_standard.3mf
cad/14-wrist-architecture/bambu/wrist-inward-fit-test/wrist-inward-fit-test.3mf
cad/14-wrist-architecture/parts/WristSaddle.step
cad/14-wrist-architecture/revisions/pre-laser-blend/WristSaddle.step
cad/16-tower-dovetail/bambu/tower-dovetail-a1-mini-black/tower-dovetail-a1-mini-black.3mf
cad/17-tower-open-optics/before-y-stops/CameraRetainer.step
cad/17-tower-open-optics/parts/CameraReference.step
cad/18-tower-recessed-clips/inspection/CameraReference.step
cad/18-tower-recessed-clips/sources/imx296-with-headers-estimated.step
cad/19-camera-tray/bambu/scos-five-replacements-a1-mini-red/scos-five-replacements-a1-mini-red.3mf
cad/19-camera-tray/sources/imx296-with-headers-estimated.step
cad/01-bench-fixture/exports/laser_fit_coupon.stl
cad/07-solidcraft-mount-v2/bambu/mount_standard_single/mount_standard_single.3mf
cad/07-solidcraft-mount-v2/bambu/mount_wide_single/mount_wide_single.3mf
cad/08-solidcraft-mount-v3/bambu/mount_standard_single/mount_standard_single.3mf
cad/08-solidcraft-mount-v3/bambu/mount_wide_single/mount_wide_single.3mf
cad/08-solidcraft-mount-v3/exports/Rest.step
cad/09-solidcraft-mount-v4/bambu/mount_standard_single/layout.3mf
cad/09-solidcraft-mount-v4/bambu/mount_wide_single/mount_wide_single.3mf
cad/11-solidcraft-mount-v6/bambu/mount_standard_single/layout.3mf
cad/11-solidcraft-mount-v6/bambu/mount_wide_single/mount_wide_single.3mf
cad/12-solidcraft-mount-v7/bambu/mount_standard_single/layout.3mf
cad/12-solidcraft-mount-v7/bambu/mount_wide_single/mount_wide_single.3mf
cad/12-solidcraft-mount-v7/exports/SpineCamera.step
cad/14-wrist-architecture/parts/LaserCap.step
cad/16-tower-dovetail/fit-coupon/MaleRailAndLatch.step
cad/17-tower-open-optics/before-y-stops/CameraPlate.step
cad/17-tower-open-optics/parts/TriggerJ3Housing.step
cad/01-bench-fixture/exports/bench_fixture.step
cad/01-bench-fixture/exports/bench_fixture_with_hood.step
cad/01-bench-fixture/exports/camera_hood.step
cad/01-bench-fixture/exports/camera_spacer.stl
cad/01-bench-fixture/exports/filter_holder.step
cad/01-bench-fixture/exports/laser_carrier.step
cad/01-bench-fixture/exports/laser_clamp_upper.stl
cad/01-bench-fixture/exports/rail_join_plate.step
cad/01-bench-fixture/exports/rail_join_plate.stl
cad/01-bench-fixture/exports/rail_segment.step
cad/01-bench-fixture/exports/rail_segment.stl
cad/01-bench-fixture/exports/target_holder.step
cad/01-bench-fixture/exports/target_holder.stl
cad/02-arm-cuff-concept/exports/arm_cuff_concept.step
cad/02-arm-cuff-concept/exports/laser_clamp.step
cad/02-arm-cuff-concept/exports/lower_cuff.step
cad/02-arm-cuff-concept/exports/upper_cuff.step
cad/02-arm-cuff-concept/exports/v02/arm_cuff_concept.step
cad/02-arm-cuff-concept/exports/v02/filter_frame.step
cad/02-arm-cuff-concept/exports/v02/laser_clamp.step
cad/02-arm-cuff-concept/exports/v02/lower_cuff.step
cad/02-arm-cuff-concept/exports/v02/optical_pod.step
cad/02-arm-cuff-concept/exports/v02/upper_cuff.step
cad/02-arm-cuff-concept/exports/v03/camera_mount.step
cad/02-arm-cuff-concept/exports/v03/filter_frame.step
cad/02-arm-cuff-concept/exports/v03/forearm_reference.step
cad/02-arm-cuff-concept/exports/v03/laser_clamp.step
cad/02-arm-cuff-concept/exports/v03/open_arm_saddle.step
cad/02-arm-cuff-concept/exports/v03/open_saddle.step
cad/02-arm-cuff-concept/exports/v03/slotted_camera_upright.step
cad/02-arm-cuff-concept/exports/v04/camera_mount.step
cad/02-arm-cuff-concept/exports/v04/forearm_reference.step
cad/02-arm-cuff-concept/exports/v04/open_saddle.step
cad/03-c-rest-module3/exports/c_rest.step
cad/03-c-rest-module3/exports/c_rest.stl
cad/03-c-rest-module3/exports/camera_carrier.step
cad/03-c-rest-module3/exports/camera_carrier.stl
cad/03-c-rest-module3/exports/laser_cap.stl
cad/03-c-rest-module3/exports/laser_cradle.step
cad/03-c-rest-module3/exports/laser_cradle.stl
cad/04-c-rest-printable/exports/camera_cassette.stl
cad/04-c-rest-printable/exports/camera_keeper.step
cad/04-c-rest-printable/exports/camera_keeper.stl
cad/04-c-rest-printable/exports/fit_coupon.step
cad/04-c-rest-printable/exports/fit_coupon.stl
cad/04-c-rest-printable/exports/laser_clip.step
cad/04-c-rest-printable/exports/laser_clip.stl
cad/04-c-rest-printable/exports/laser_pin_19mm.step
cad/04-c-rest-printable/exports/laser_pin_19mm.stl
cad/04-c-rest-printable/exports/locking_pin_20mm.step
cad/04-c-rest-printable/exports/locking_pin_20mm.stl
cad/04-c-rest-printable/exports/rest.stl
cad/04-c-rest-printable/exports/tower_standard_105mm.step
cad/04-c-rest-printable/exports/tower_standard_105mm.stl
cad/04-c-rest-printable/exports/tower_wide_55mm.step
cad/04-c-rest-printable/exports/tower_wide_55mm.stl
cad/06-solidcraft-mount-v1/bambu/mount_wide_single/mount_wide_single_preserved_before_v3.3mf
cad/06-solidcraft-mount-v1/exports/Keeper.step
cad/06-solidcraft-mount-v1/exports/Keeper.stl
cad/06-solidcraft-mount-v1/exports/Rest.step
cad/06-solidcraft-mount-v1/exports/Rest.stl
cad/06-solidcraft-mount-v1/exports/SpineCamera.step
cad/06-solidcraft-mount-v1/exports/SpineCamera.stl
cad/07-solidcraft-mount-v2/exports/Rest.stl
cad/08-solidcraft-mount-v3/exports/LockingKey.step
cad/08-solidcraft-mount-v3/exports/Rest.stl
cad/09-solidcraft-mount-v4/exports/Keeper.step
cad/09-solidcraft-mount-v4/exports/Rest.stl
cad/11-solidcraft-mount-v6/exports/FitCollar.step
cad/11-solidcraft-mount-v6/exports/FitCollar.stl
cad/11-solidcraft-mount-v6/exports/Rest.step
cad/11-solidcraft-mount-v6/exports/Rest.stl
cad/11-solidcraft-mount-v6/exports/SpineCamera.step
cad/12-solidcraft-mount-v7/exports/Keeper.stl
cad/12-solidcraft-mount-v7/exports/Rest.step
cad/12-solidcraft-mount-v7/exports/Rest.stl
cad/12-solidcraft-mount-v7/exports/SpineCamera.stl
cad/12-solidcraft-mount-v7/exports/SpineCamera_standard.stl
cad/12-solidcraft-mount-v7/standard_exports/Rest.stl
cad/12-solidcraft-mount-v7/standard_exports/SpineCamera.step
cad/12-solidcraft-mount-v7/standard_exports/SpineCamera.stl
cad/12-solidcraft-mount-v7/standard_exports/SpineCamera_standard.stl
cad/12-solidcraft-mount-v7/surface_source/LaserBand_reference.step
cad/12-solidcraft-mount-v7/surface_source/RestFinished.step
cad/12-solidcraft-mount-v7/surface_source/proven_blend.step
cad/13-bench-architecture/sources/OfficialCM3_Connector.step
cad/13-bench-architecture/sources/OfficialCM3_Detail.step
cad/13-bench-architecture/sources/OfficialCM3_LensHousing.step
cad/13-bench-architecture/sources/OfficialCM3_PCB.step
cad/14-wrist-architecture/bambu/oriented/WristSaddle.stl
cad/14-wrist-architecture/parts/CameraKeeper.step
cad/15-tower-mechanical/parts/ApertureRing.step
cad/15-tower-mechanical/parts/ArmReference.step
cad/15-tower-mechanical/parts/BasePin-1_0.step
cad/15-tower-mechanical/parts/BasePin-1_1.step
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
