ebf-hue/mini-scos/cad/03-c-rest-module3/assembly.png

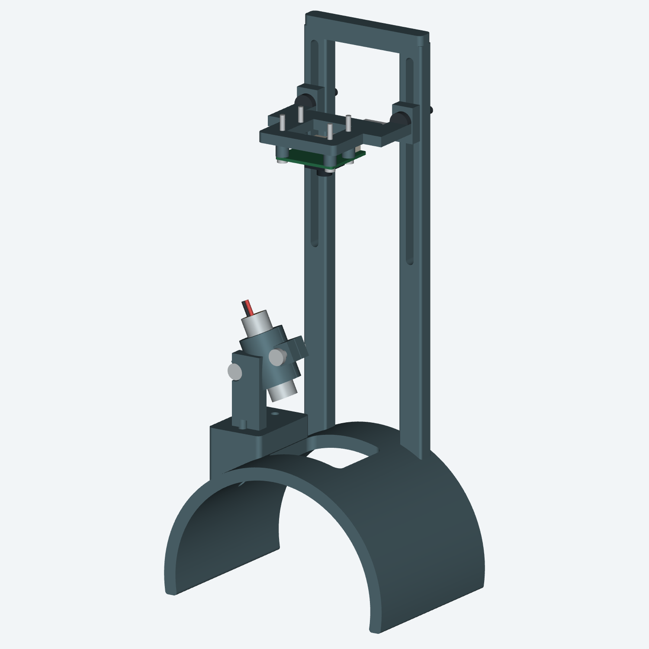
cad/03-c-rest-module3/assembly.png
