ebf-hue/mini-scos/cad/14-wrist-architecture/print/plate.png

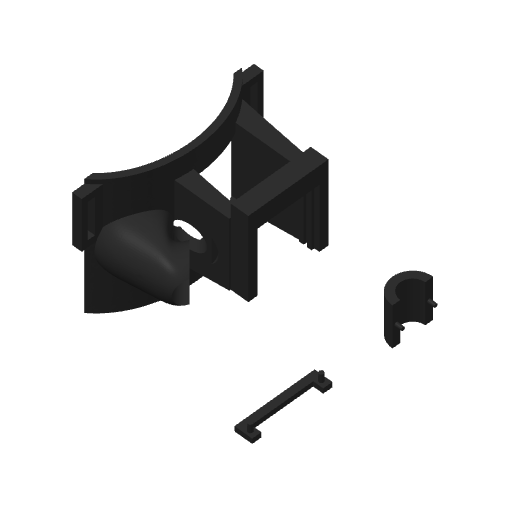
cad/14-wrist-architecture/print/plate.png
