ebf-hue/mini-scos/cad/18-tower-recessed-clips/camera-seat-assembled.png

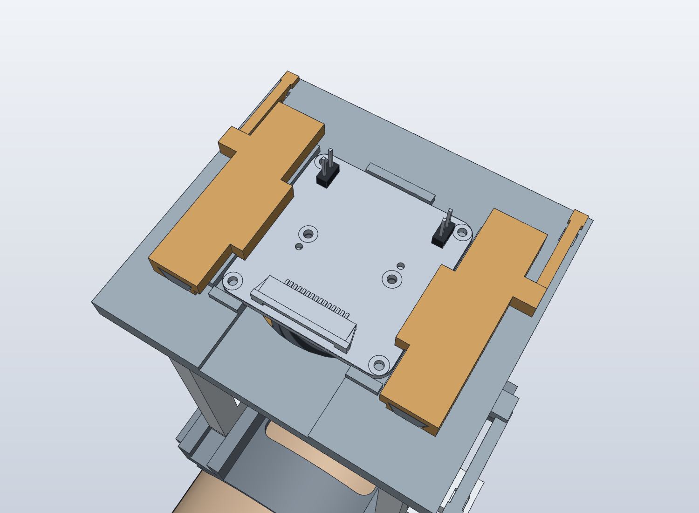
cad/18-tower-recessed-clips/camera-seat-assembled.png
