ebf-hue/mini-scos/cad/19-camera-tray/camera-seat-assembled.png

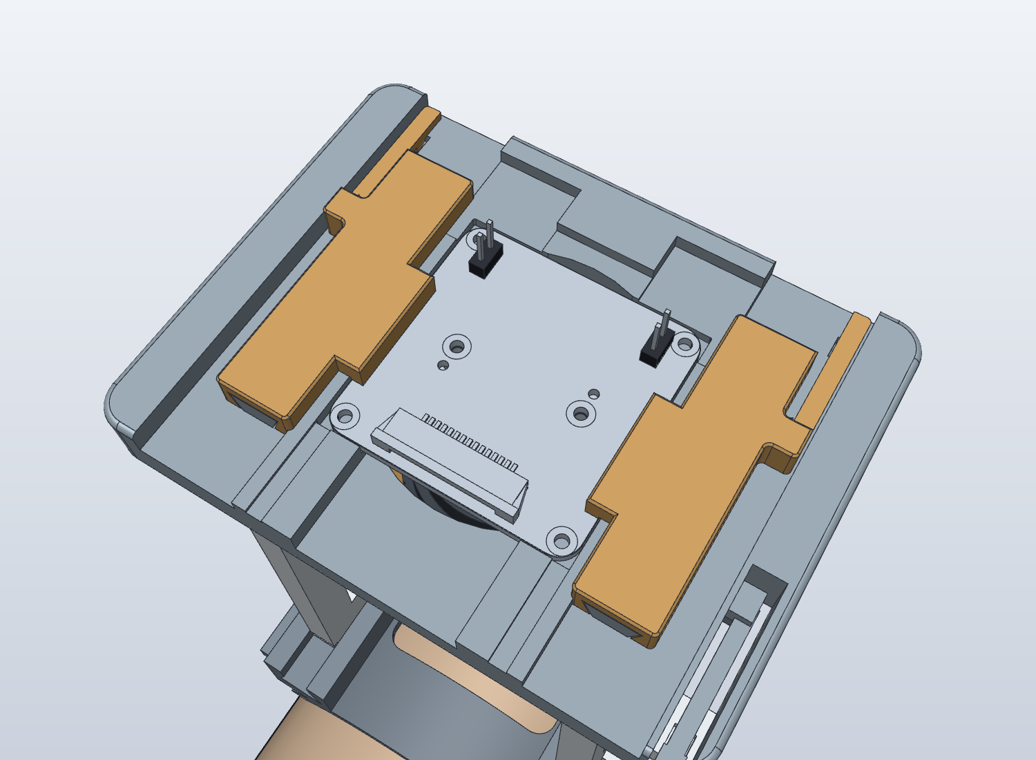
cad/19-camera-tray/camera-seat-assembled.png
