ebf-hue/mini-scos/cad/experiments/halloween-sculpt/print/monster-four-colour-plate.png

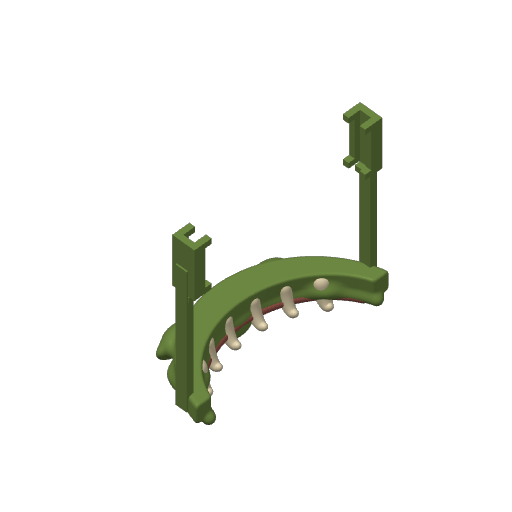
cad/experiments/halloween-sculpt/print/monster-four-colour-plate.png
