ebf-hue/mini-scos/cad/experiments/README.md

# Experiments

These are outside the numbered SCOS prototype sequence.

- `surface-blend-work/`: surface-blending trials and intermediate geometry.
- `halloween-monster/`: early removable decorative accessory experiments.
- `halloween-sculpt/`: later sculpted accessory experiment.

The accessory scripts reference the wrist mount in `../14-wrist-architecture/`. These folders are preserved for reference, not marked as current SCOS hardware.
