ebf-hue/mini-scos/cad/experiments/halloween-monster/monster-face.png

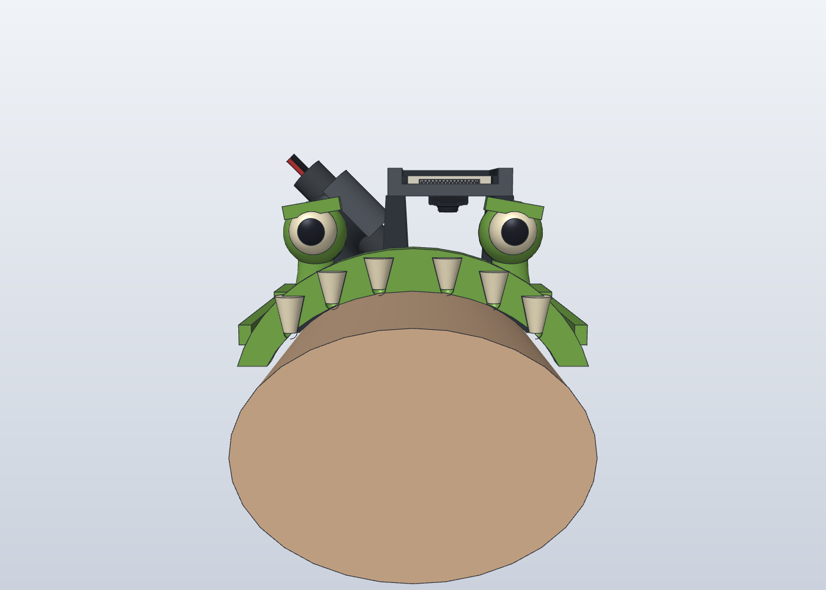
cad/experiments/halloween-monster/monster-face.png
