ebf-hue/mini-scos/cad/experiments/halloween-monster/monster-side.png

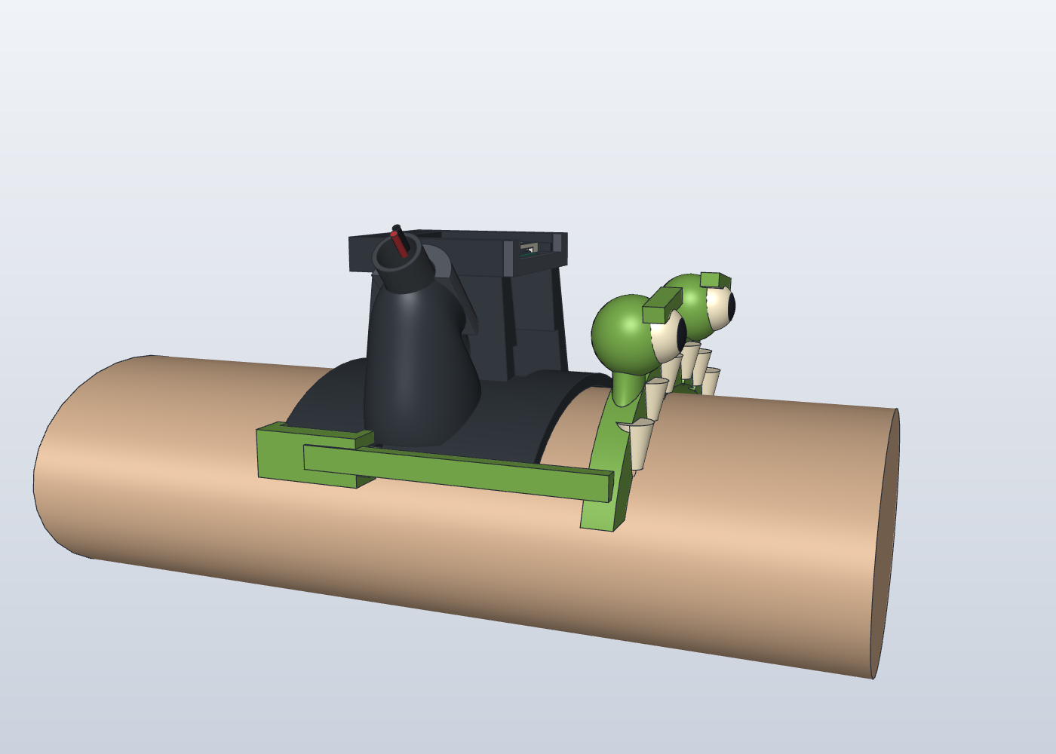
cad/experiments/halloween-monster/monster-side.png
