ebf-hue/mini-scos/cad/experiments/halloween-monster/monster-wrist.png

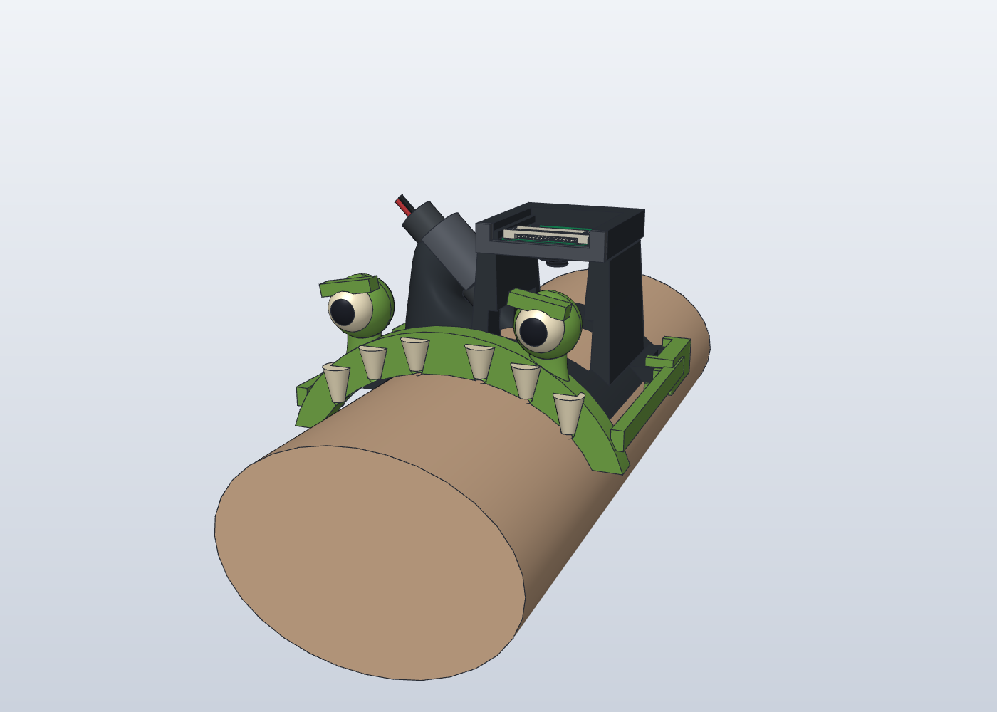
cad/experiments/halloween-monster/monster-wrist.png
