ebf-hue/mini-scos/cad/experiments/halloween-sculpt/sculpt-front.png

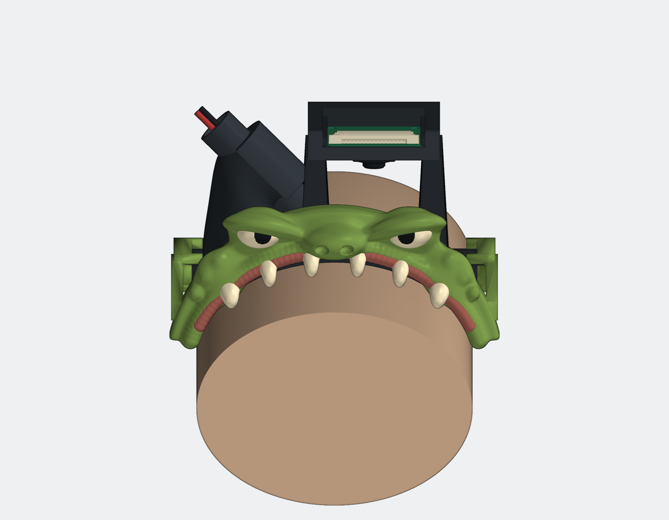
cad/experiments/halloween-sculpt/sculpt-front.png
