ebf-hue/mini-scos/cad/experiments/halloween-sculpt/sculpt-side.png

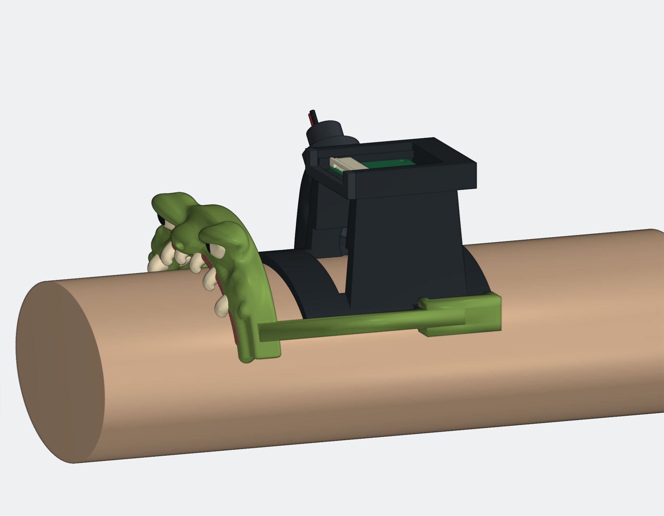
cad/experiments/halloween-sculpt/sculpt-side.png
