ebf-hue/mini-scos/cad/experiments/surface-blend-work/blend_joined.png

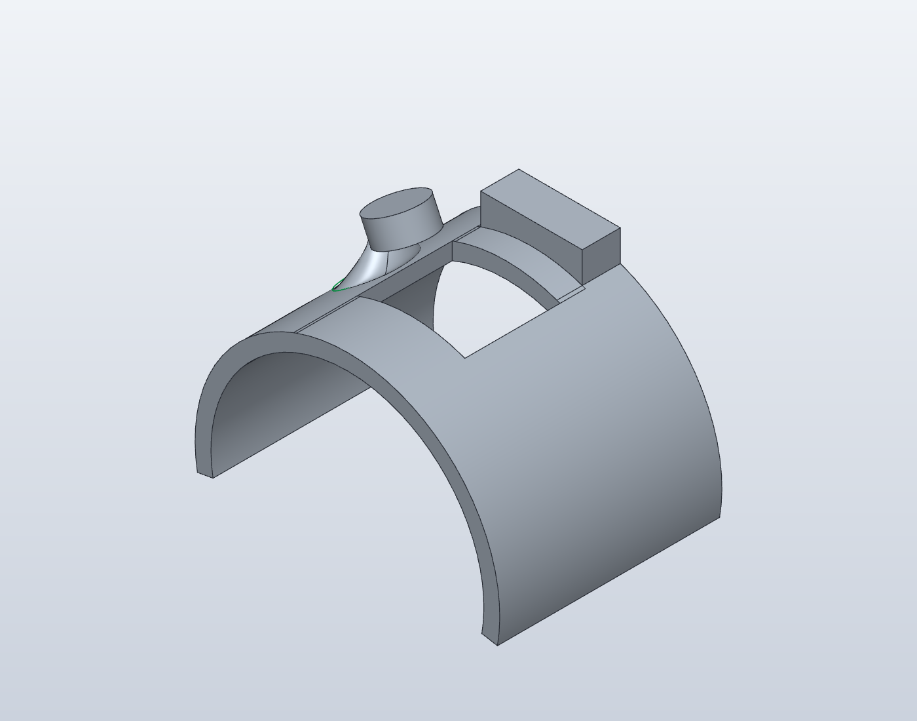
cad/experiments/surface-blend-work/blend_joined.png
