ebf-hue/mini-scos/(list of files, drawings)

Other design files:
cad/17-tower-open-optics/pcb-restraint-check.json
cad/18-tower-recessed-clips/pcb-restraint-check.json
cad/19-camera-tray/pcb-restraint-check.json
