ebf-hue/mini-scos/(commit log)

2026-10-19 Add bench fixture and open arm saddle CAD concepts
2026-11-04 upload initial camera_app.py with RGB and raw preview windows
2026-11-04 Add wrist-mounted camera and lofted laser prototype (#24)
2026-11-04 Add IMX296 dovetail wrist tower CAD and SolidCraft screenshots (#27)
2026-11-04 Organize CAD design history and preserve latest camera-tray prototype
